2AMLogic/gf180-ldo/sim/README.md

# sim/ — evidence record format

This directory holds simulation testbenches and their results. Results are
**append-only evidence**: once a record is written, it is never edited or
deleted. A re-run — even one that corrects a mistake — mints a new record
with a new ID; a correction references the record it supersedes rather than
overwriting it in place.

This convention exists because CLAUDE.md commits this repo to two rules that
need a concrete schema to be enforceable:

- **Verification is the product.** No claim without a testbench. Every
  recorded result carries the full PVT corner matrix (−40/27/125 °C, ±10%
  supply, process corners) unless the record explicitly states why a subset
  was used.
- **`sim/` is append-only evidence.** Re-runs get new records; records are
  never edited or deleted.

## Provenance note (checked at build time, 2026-07-30)

This convention mirrors the ratified `sim/README.md` on `2AMLogic/gf180-bandgap`
`main` (landed via their PR #22, merged 2026-07-30). At the time this doc was
written, bandgap's harness PR (#23, "Stand up the ngspice + gf180mcu PVT
simulation harness") was still **open and unmerged**, and it writes evidence
as a machine-readable JSON/CSV pair under `sim/results/<tb>/` rather than the
Markdown records described below — i.e. it is a *competing* scheme that has
not yet been reconciled with the ratified Markdown convention. Since the
Markdown convention is what is currently ratified on bandgap `main`, this
repo adopts it as-is (see "LDO-specific extensions" below for the one place
this repo diverges, with rationale). If bandgap later reconciles #23 against
this convention (or supersedes it via a decision record), re-check this doc
against bandgap `main` and update accordingly — do not let the two repos'
evidence formats silently drift apart, since cross-block tooling and review
uniformity is the whole point of matching.

## Directory / naming convention

Each testbench topic gets its own experiment directory:

```
sim/
  <experiment-slug>/                 # e.g. dropout-vs-load, psrr-dc, startup, mc-untrimmed
    testbench/                       # testbench netlist(s) / xschem export used
    netlist-snapshots/
      <record-id>.spice              # frozen DUT netlist used for this record
    corners/
      <record-id>/
        <corner-id>.log              # raw ngspice output per PVT point
                                      # e.g. ss_-40c_2.97v.log
    records/
      <record-id>.md                 # append-only summary record
```

- **`<experiment-slug>`** — short, descriptive, kebab-case name for what is
  being verified (`dropout-vs-load`, `psrr-dc`, `startup`, `mc-untrimmed`,
  ...). One directory per distinct claim being tested, not per run.
- **`<record-id>`** — unique and traceable:
  `<YYYYMMDD>-<HHMMSS>-<short-git-sha>` (e.g. `20260729-153000-1a7ef75`).
  Re-runs simply mint a new `<record-id>`; nothing under `records/` is ever
  edited in place. The same `<record-id>` ties together the netlist snapshot,
  the raw per-corner logs, and the summary record for one run.
- **`<corner-id>`** — `<process-corner>_<temp>c_<supply>v.log`, e.g.
  `ss_-40c_2.97v.log`, `tt_27c_3.3v.log`, `ff_125c_3.63v.log`. For claims that
  are also load-conditioned (see "Operating conditions" below), the load
  point may be appended, e.g. `ss_-40c_2.97v_50ma.log`, when a single record
  sweeps more than one load current within the same corner matrix.
- **`testbench/`** is not versioned per record — it holds the current
  testbench netlist(s)/xschem export(s) used to generate records. If the
  testbench itself changes in a way that could affect comparability across
  records, note that in the new record's summary (e.g. under Claim or a
  free-text note).

### Raw corner logs are committed, not ignored

> **Superseded for new runs (issue #511, DR-0041).** The rest of this section
> describes how every record up to now was written, and those files stay
> exactly where they are. A run minted after DR-0041 stores its logs and
> netlist snapshot in the artifact store instead and commits only a manifest
> and the Markdown record; see "Stored evidence" below.

The repo root `.gitignore` ignores `*.log` (scratch output), so it carries an
explicit negation to re-include evidence logs:

```gitignore
!sim/*/corners/**/*.log
```

Raw per-corner ngspice output under `sim/<slug>/corners/<record-id>/` is
**evidence**, not scratch — a record's Links field points at those files, so
they must be committed alongside the record they substantiate. The negation
generalizes to any new experiment slug; no parent directory is excluded, so
git's "cannot re-include a file under an excluded directory" rule does not
apply. Anything else matching `*.log` (simulator scratch, tool noise) stays
ignored. Verify with `git check-ignore -v <path>` if a log unexpectedly fails
to stage.

**Binary `.raw` waveform dumps are scratch, not evidence — deliberately.**
The root `.gitignore` ignores `*.raw` with no negation, and that is
intentional, not an oversight: a full ngspice `.raw` rawfile (from `write
out.raw` or a `wrdata`/binary dump in a `.control` block) is large, opaque,
and not diffable, and a 9-point PVT matrix of them adds up fast. Anything a
record's **Result** cites — a measured value, a pass/fail, a spec-point
extraction from a curve — must be reproducible from the committed `.log`
alone, via `.meas` statements or `print`/`echo` output to stdout, which
ngspice captures into the corner log. A testbench deck MAY still write a
`.raw` file locally for interactive debugging, but must not rely on it as
the record of a claim: nothing under `sim/` is evidence unless it is
committed, and `.raw` files are never committed. If a harness needs to
preserve full waveform data rather than a scalar/point extraction, that is
a signal the record format needs a new evidence kind (open an issue rather
than silently committing a `.raw`) — this convention does not currently
have one.

## Summary record format

Each run produces one `records/<record-id>.md` file with the following
fields:

- **Record ID** — the `<record-id>` for this run (matches the filename and
  the corresponding `netlist-snapshots/` / `corners/` subdirectory).
- **Claim** — which spec parameter/line this record substantiates (reference
  the ratified spec, e.g. `spec/<file>.md#<anchor>`, once ratified specs
  exist — see #1). Placeholder anchors are acceptable until #1 ratifies.
- **Netlist provenance** — `schematic` (`design/...`) or `extracted`
  (post-layout, `layout/...`). Required so post-layout re-runs are
  distinguishable from the original schematic-level record.
- **Corner matrix run** — explicit list of (process corner, temperature,
  supply) points actually executed. Must be the full PVT matrix from
  CLAUDE.md (−40/27/125 °C, ±10% supply, process corners) unless the record
  states why a subset was used.
- **Operating conditions** *(LDO-specific — see below)* — load current or
  load profile, output capacitor value + ESR range, and enable state.
  Required whenever the claim depends on load or the output network, i.e.
  most LDO spec lines (dropout, load/line regulation, stability, transients,
  startup). Omit only for claims that are provably load-independent (e.g. a
  pure reference-voltage TC check with the output disconnected), and say so.
- **Statistical convention** (when applicable, e.g. Monte Carlo mismatch
  analysis) — N samples and sigma level reported. Used for distribution
  claims that are not a per-corner pass/fail (e.g. reporting a spread against
  the untrimmed spec).
- **Result** — per-corner pass/fail, plus an overall pass/fail against the
  ratified spec value. For curve-shaped claims (e.g. PSRR vs frequency,
  transient step response) that are checked against a single spec point
  within a sweep (e.g. "PSRR > 50 dB @ 1 kHz"), the Result states the value
  extracted at that spec point plus pass/fail against it; the full curve/
  waveform data lives in the raw log under `corners/`, referenced from
  Links. A record MAY report more than one spec point extracted from the
  same sweep (e.g. PSRR at 1 kHz and 100 kHz) as separate line items under
  Result, each with its own pass/fail — the sweep is run once, but every
  claim it substantiates gets an explicit, unambiguous verdict. Records
  minted by `sim/run_corners.py` additionally carry a **`dc path`** column
  and a **DC solve path** census inside Result — see "A verdict can move
  without the circuit moving" below. It is attribution, never a verdict: no
  rung value has ever made a record pass or fail.
- **Links** — paths to the testbench file(s), the frozen netlist snapshot,
  and the raw per-corner logs used to produce this record.
- **Timestamp / author** — when the record was created and who (human or
  agent) created it.
- **Supersedes** (optional) — the prior `<record-id>` this record supersedes,
  for corrections or for a post-layout extracted re-run that reports a
  schematic-vs-extracted delta against the schematic-level record. Mirrors
  the status/supersession language proposed for `spec/` decision records
  (see #6), so both conventions read as one house style.

## LDO-specific extensions (where "match bandgap" ends)

Bandgap's corner matrix is process/temperature/supply only — a bandgap
reference has no load pin. An LDO's spec lines are additionally load- and
output-network-conditioned (dropout @ 50 mA; load regulation 1–50 mA; line
regulation; stability across 0–50 mA load with a 1 µF ± ESR output cap
range; startup into full load, minimum load, and current limit; PSRR and
transient response, both load-dependent). A PVT corner alone does not fully
specify one of these claims — the **Operating conditions** field above
closes that gap so a claim like "dropout < 300 mV @ 50 mA at ss/125 °C/
2.97 V" is fully specified by the record: process/temp/supply come from
Corner matrix run, load/cap/enable come from Operating conditions. This is
the one deliberate divergence from the bandgap convention; the field is
additive (records with no load dependency simply state N/A), so it does not
break parity for claims that don't need it.

## Append-only rule

`records/*.md` files are never edited or deleted after creation. A re-run or
a correction always creates a new record with a new `<record-id>`. If it
corrects or replaces a prior result, it references that prior record via
**Supersedes** rather than overwriting it. This applies even to typo fixes —
the append-only guarantee is what makes `sim/` usable as an evidence trail;
"fixing" an existing record in place would defeat that.

The rule has **no exceptions and needs none**: everything under a real
experiment slug is real evidence. That is why the worked example below is
inline in this document only and is deliberately *not* materialized as files
under `sim/dropout-vs-load/` (or any other slug). A placeholder record
committed to a real slug would be an evidence-shaped file that is not
evidence — it would have to be either deleted later (breaking this rule the
moment it is written) or left permanently interleaved with genuine records,
where any rollup that globs `sim/*/records/*.md` would ingest its fabricated
verdict. Illustrate the format in prose; only real runs write files.

**Enforcement.** The writer refuses to overwrite in-process, and CI enforces
the rule on every pull request: `sim/check_append_only.py` diffs
`origin/<base>...HEAD` and fails if any path under `sim/*/records/`,
`sim/*/corners/`, `sim/*/netlist-snapshots/` (the frozen DUT netlists that a
record's fresh/stale attribution depends on), `layout/records/`, or
`manifests/artifacts/*.manifest.json` is modified, deleted, or renamed (only
additions pass). The "no exceptions" stance stands; if a decision record ever
ratifies one, it must be listed with its DR number in
`sim/append-only-allowlist.txt` so it stays visible in review (empty today).

**Growth report.** Because `sim/` can only grow, CI also runs
`sim/report_evidence_growth.py` on every pull request. It writes files and
bytes added per `sim/<slug>` to the job summary. It is reporting only: it
never fails and enforces no ceiling.

## Stored evidence

New evidence bytes go to the fleet artifact store; git keeps a manifest and a
Markdown record (issue #511, [DR-0041](../spec/decision-records/DR-0041-new-evidence-bytes-go-to-the-artifact-store-git-keeps-manifests.md)).
Evidence bytes are private and manifests are public, so a manifest is safe in
this public repo. Evidence already committed is not rewritten or migrated.

- **Corner-runner records.** `python3 sim/run_corners.py <bench>` stages the
  netlist snapshot and per-corner logs under `sim/.work/.stage/` (git-ignored),
  stores them with `klt artifact put`, then commits
  `manifests/artifacts/<bench>-<record-id>.manifest.json` and
  `sim/<bench>/records/<record-id>.md`. The record ends with a "Stored
  evidence" table (name, size, sha256 per object). Zero-byte files cannot be
  stored and are listed there as empty. The record's `netlist-snapshots/` and
  `corners/` paths are the manifest `name`s, not files in the repo.
- **Other outputs.** Write them to scratch (`sim/.work/...` or outside the
  repo), then
  `python3 sim/run_store_evidence.py <bench> <run-id> <dir> --summary <summary.md>`.
  It commits the manifest and `sim/<bench>/campaigns/<run-id>.md`.
  The `klt`-batch adapters (`klt_record.py`, `tb_adapter.py`) still write the
  old layout; moving them is tracked separately.
- **Configuration** is the environment only, read by `klt`:
  `KLT_ARTIFACT_BROKER` and optionally `KLT_ARTIFACT_REPO`. Nothing is
  defaulted and no broker URL, bucket or account identifier is written in this
  repo. A manifest `uri` is the logical `artifact:<key>`; any other scheme is
  refused. `klt` must be klayout-tools `7e3561f` or later. `klt` reports no
  commit, so the writer probes its behaviour offline. To try another version
  use a throwaway environment (`uvx --from ... klt`), not a host install.
- **Fail closed.** If the broker is unset or unreachable, or `klt` lacks
  `artifact put` or is too old, `run_corners.py` refuses before simulating
  (exit 10). A put that fails after the grid also exits 10. Either way nothing
  goes under `manifests/` or `sim/`, the staged bytes stay in
  `sim/.work/.stage/`, and there is no option to commit the bytes instead.
  `--no-write` exploration needs no store.
- **Verify by hash.** `klt artifact verify <manifest>` (or
  `python3 scripts/check_artifact_manifests.py verify <manifest>`) re-hashes
  every entry through the broker. CI runs
  `scripts/check_artifact_manifests.py check --tree <sha>`: schema, `artifact:`
  URIs only, and no stored object's bytes also committed. CI never contacts the
  broker, so it does not hash-verify and says so.

## Reproducibility caveat: a version string is not a content fingerprint (#182)

The Environment section documents "everything needed to re-run this record",
and lists the resolved `ngspice` **self-reported version string** (e.g.
`ngspice-46`). Issue #182 found that string insufficient on its own: this
repo's evidence is produced across a fleet of independently-provisioned
builder hosts (see Loom's own per-host lease records), each with its own
locally-installed toolchain, and even **on a single host over time** two
differently-built binaries were found coexisting that both print the
identical `"ngspice-46 ... Compiled with KLU Direct Linear Solver"` banner
while differing byte-for-byte. At a numerically marginal operating point
(within a couple of degrees of DR-0001's 45° phase-margin bar), that
difference in binary content was directly observed to move the measured
phase margin by ~2° and gain margin by ~1 dB on an otherwise byte-identical,
unmodified netlist and PDK — see
`sim/loop-stability/records/20260906-090647-3981d88.md` for the full
investigation and ruling-out evidence.

**Consequence for this convention**: "reproducible" for a `sim/` record does
**not** mean "any host/session reporting the same `ngspice` version string
will reproduce this record's numbers to the last digit" — it means
"reproducible given a matching resolved binary and PDK content, which the
record's Environment section must make checkable." Every record's
Environment section now also carries (or should carry, for records minted by
harness code that predates #182):

- **ngspice binary sha256** — a content fingerprint of the resolved
  executable (`sim.harness.runner.ngspice_binary_sha256()`), not just its
  self-reported version string.
- **Host** — the hostname that produced the record (`socket.gethostname()`),
  since Loom's builder fleet spans multiple independently-provisioned
  machines.

When comparing two records for a claimed regression or an unexplained
per-point delta near a spec bar, **check whether `ngspice binary sha256` and
`Host` match before treating the delta as evidence about the design**. A
mismatch on either field means the two records were not produced by the same
toolchain, and a delta between them is toolchain provenance, not a design
regression — file it as a toolchain-reproducibility question (as #182 did),
not as a spec-line failure. This does **not** relax DR-0001 or any other
ratified spec bar: a record's own PASS/FAIL verdict against its stated bar
stands as recorded regardless of this caveat; the caveat only qualifies
what a *comparison across two records* is allowed to conclude.

Recording the fingerprint makes drift *detectable after the fact*; it does
not stop it. Issue #184 hardens `sim/run_corners.py --check-env` to enforce
toolchain identity *before* a run, rather than only reporting the
fingerprint for later comparison — see
[`docs/environment-setup.md`](../docs/environment-setup.md)'s "A version
banner is not a toolchain identity" section.

Issue #247 then found that check could invert once Homebrew's unversioned
`ngspice` formula moved past the pinned 46_1 — it began blaming the
correctly-pinned binary and naming an unvalidated ngspice-47 keg as the
"correct" root. It now checks the *version* pin as well as containment, and
prefers a non-drifting root. The **four distinct ngspice-46 builds already
present across the committed records** are documented there as an accepted,
historical split (census, and what a cross-fingerprint comparison may and may
not conclude): `docs/environment-setup.md` → "The ngspice-46 builds already
in `sim/*/records/` are an accepted, historical split". Per the append-only
rule above, none of those records are regenerated to reconcile it.

## A verdict can move without the circuit moving: the DC solve path (#301)

The caveat above is about the toolchain *binary* changing underneath a
record. There is a second, closely-related way two records can disagree with
no electrical change between them, and it happens on one fixed binary: the
**DC continuation ladder**.

ngspice does not solve a DC operating point with one algorithm. It tries the
first-guess Newton solve, and on non-convergence descends a ladder of
continuation methods, taking the first one that converges:

| rung | what ngspice prints when this rung solved the point |
|---|---|
| `direct` | *(nothing — the first Newton pass converged)* |
| `dynamic-gmin` | `Dynamic gmin stepping completed` |
| `true-gmin` | `True gmin stepping completed` |
| `source-stepping` | `Source stepping completed` |
| `pseudo-transient` | `Transient op finished successfully` |

Which rung a corner lands on is a property of the numerical path, not of the
circuit. Issue #301 measured a 2×2 on `sim/quiescent-current` — two DUT
netlists × a seeded/unseeded deck, one host, one ngspice binary, one PDK —
in which the bench's overall verdict flipped between two builds whose
`iq_en_ua` agrees to six significant figures at every corner. DR-0033 (a
poly-resistor *flavour* swap, electrically neutral on this bench) had moved
which rung the one marginal corner caught on, and nothing in the recorded
evidence said so.

So every `sim/run_corners.py` record now reports, per corner, the deepest
rung that corner's DC solve(s) reached, plus a grid-level census. Read it
the same way as `ngspice binary sha256` and `Host`:

- **A census difference between two records is a real difference**, even
  when every printed measurement matches — those corners' solutions came
  from different algorithms.
- **A deep rung is not a failure.** ngspice descends the ladder on its own,
  and the answer it returns is still checked by the same `tb.json` checks as
  any other corner. The rung marks *marginality*, so a corner sitting on
  `source-stepping` today is the one to expect to move tomorrow.
- **Do not tune a deck against a rung.** A `.nodeset` DC seed chosen to move
  one corner up the ladder is validated against a numerical path, not
  physics; issue #301's own 2×2 is the counter-example (the seed that fixed
  the marginal corner on one DUT created a new failure at a *different*
  corner on the next one). Any future seed must re-run that A/B on the DUT
  current at the time.
- **The last rung is fatal, not marginal (#310).** Everything above applies
  to the first four rungs. A log showing the ladder fell *through*
  `source-stepping` — `Warning: source stepping failed` followed by
  `Note: Transient op started` / `Note: Transient op finished successfully` —
  means ngspice reported a snapshot of an unsettled synthetic transient as
  the operating point: it exits 0 and prints every requested measurement,
  but the values are not a DC solution. Committed evidence:
  `sim/quiescent-current/corners/20260915-234352-077e15b/ss_-40c_2.97v.log`
  reports `iq_en_ua = -137.99` — a *negative* no-load supply current, i.e.
  capacitor displacement current, which no DC operating point has — and the
  corner's bench checks only caught it by luck (see #310's "Why it
  matters"). The harness therefore fails such a corner outright, gated to
  DC-solve benches (`op`, `dc`, `ac`): a bench that declares a `.tran`
  analysis is exempt, because its initial-time-point solve walks the same
  ladder and a pseudo-transient initial condition does not invalidate the
  transient that follows. This applies on every code path that drives
  ngspice in this repo: `run_point()` and `run_ngspice_deck()` (#310), and
  the standalone bash driver `sim/harness/lib/run_point.sh`'s
  `harness_run_point()` plus `sim/devchar/lib/devchar.sh`'s `dc_run()`
  (#317) — the latter two shell out to the same
  `_ladder_exhaustion_lines()` / `_runs_transient_analysis()` rather than
  keeping their own copy, so all four call sites cannot drift apart.

Implementation: `sim.harness.runner.classify_dc_path()` classifies one
corner's combined ngspice stdout+stderr; `sim.harness.report.dc_path_census()`
rolls the grid up. Both are pure log parsing — they change no deck, assert
nothing, and run on every bench that goes through `run_point()`. Sweep
testbenches with their own driver (`sim/loop-stability`,
`sim/soft-start-loop-gain`) can opt in by calling `classify_dc_path()` on
what `run_ngspice_deck()` already returns; none does yet. `dc_path` census
reporting is `run_point()`/`run_ngspice_deck()`-specific (#301) and is not
part of what the bash driver's ladder-exhaustion *gate* needed to port —
`sim/harness/lib/run_point.sh` and `sim/devchar/lib/devchar.sh` fail a
corner outright the same way, they just do not also classify/census the
rung for corners that pass.

## Records measured under open_pdks `c6d73a3` are superseded as PDK evidence (#428 / #430)

`sim/harness/pdk.py` pins `PINNED_OPEN_PDKS_REVISION =
f6eeac7dad085ffcc829ccfd721f7b4ce39edcf7`. Every record minted before that
re-pin was measured at the previous pin, open_pdks
`c6d73a35f524070e85faff4a6a9eef49553ebc2b` (local `~/.ciel` trees, and the
batch fleet's `/opt/pdk`). Those records are **not edited**; the convention
below is how a reader tells which revision a record speaks for.

- **A record that states no `f6eeac7…` revision speaks for `c6d73a3…`.**
  Records minted by `klt sim` carry the worker's PDK stamp in their klt
  report (`environment.remote.worker_environment.pdk.stamp_text`).
- **A re-qualified bench gets a new record** whose `Supersedes` field names the
  prior head record(s) and whose PDK-revision field states `f6eeac7…`, with a
  same-DUT old-vs-new comparison when a same-DUT baseline exists. The older
  record stays valid evidence for `c6d73a3…` and is superseded only as
  evidence for the pinned revision. `sim/CHARACTERIZATION.md` picks the new
  record up automatically (newest record whose snapshot matches the current
  DUT).
- **The fleet's PDK can lag the repo's pin.** The batch fleet's worker image
  carries its own `/opt/pdk`; a request that does not say otherwise is
  simulated against that tree. `sim/harness/klt_batch.py` therefore submits
  `options.stage_model_inputs: true`, which ships the submitting host's model
  files (its `~/.ciel` tree, checked against the pin by
  `sim/run_corners.py --check-env`) with the job. Confirm per run: the klt
  report's `worker_environment.models_staged` is `true` and its `model_inputs`
  list the staged files. The report's `pdk.stamp_text` keeps naming the
  worker's own tree and is not what the job used.

Re-qualification status (issue #430). "Moved" means a measurement or a
pass/fail verdict differs from the same-DUT record at `c6d73a3…`:

| bench | new record | same-DUT old record | moved? |
|---|---|---|---|
| `quiescent-current` | `20261020-pdk-f6eeac7-iq` | `20261015-iq-320-pvt` | no (81/81 points identical) |
| `current-limit` | `20261020-pdk-f6eeac7-ilim` | `20261015-ilim-320-pvt` | no (63/63 points identical) |
| `enable-shutdown` | `20261020-pdk-f6eeac7-en` | none (older DUT only) | not separable; all checks pass |

The `tb.json` benches are re-qualified in the section below (#464, #467, #468). The
remaining benches (`loop-stability`, `soft-start`) are not yet re-qualified and
still speak for `c6d73a3…` only; they are tracked in #465.

## Re-qualification at the pinned open_pdks through `klt sim` (#464, #467, #468)

`sim/harness/pdk.py` pins open_pdks `f6eeac7`. The batch fleet's image carries
a different revision (`c6d73a3` when #467 checked: `worker_environment.pdk.stamp_text`
in a `klt sim` report), and an off-host `klt sim` executes the image's models
unless the request sets `options.stage_model_inputs`. A record that claims the
pin must therefore be run with the models staged and show
`worker_environment.pdk.models_staged: true`; the harness adapter below sets it.

A bench that declares itself in `tb.json` goes to the fleet through
`sim/harness/tb_adapter.py`, which turns `tb.json` (grid, `analyses`, `measure`,
`checks`) into a `klt_batch.Job`; the bench's `testbench/klt_run.py` is a few
lines over it and the measurements and bounds stay in `tb.json`. It maps a
`meas` analysis line to a `.meas` card, a `measure` entry built from card
results to a `.meas … param=` card (a card's result is a printed scalar, not a
vector a later `let` can read), and any other `measure` entry to an `expr`,
with `m_<name>` references and the bench's own `<kind>1.` plot qualifiers
rewritten. A single-request bench that reads a plot its analysis does not
produce is refused by name rather than approximated.

A bench that chains analyses in one `.control` block (`op`, `ac dec …`,
`ac lin 1 1k 1k`) cannot be one request, because `klt sim` runs one analysis per
corner. `tb_adapter.states()` splits it into one request per analysis and sends
each `measure` entry to the analysis whose plot it reads (`ac1.x` and `meas ac`
results to `ac1`; an unqualified vector read to the last analysis, ngspice's
current plot); an entry that reads two analyses is refused. These fragments take
their supply from `.param vdd_val`, and the fleet's worker answers a swept
`corners.params` axis with `params_unsupported_worker`, so each supply point is
its own request with `vdd_val` written into the body: a 3-supply bench is
`states x 3` requests, and the driver merges the values per corner. `klt_run.py`
leaves `summary.csv` and the per-request reports and logs under
`corners/<record-id>/klt-<state>-<vin>v/`; `PYTHONPATH=sim python3 -m
harness.klt_record <slug> --record-id <id>` turns them into the record and
netlist snapshot, graded with `report.evaluate_checks`, and writes the
old-vs-new table against the newest earlier record (a *Reading* is written by
hand).

| bench | driver | latest record at `f6eeac7` (batch) | verdict |
|---|---|---|---|
| `dropout-vs-load` | `testbench/klt_run.py` | `20261021-031411-06b3540` | PASS, 27/27 (#472) |
| `line-regulation` | `testbench/klt_run.py` | `20261021-032652-06b3540` | FAIL, 26/27 (`ff_125c_3.30v`, DR-0039, #302) |
| `load-regulation` | `testbench/klt_run.py` | `20261021-031815-06b3540` | PASS, 81/81 (#472) |
| `amp-openloop` | `testbench/klt_run.py` | `20261021-023703-7d3b2a0` | PASS, 81/81 |
| `psrr-dc` | `testbench/klt_run.py` | `20261021-023703-7d3b2a0` | PASS, 81/81 |
| `psrr-vs-freq` | `testbench/klt_run.py` | `20261021-023703-7d3b2a0` | FAIL, 42/45 (DR-0031, #302) |
| `psrr-vs-freq-50ma` | `testbench/klt_run.py` | `20261021-034534-0165a0b` | FAIL, 42/45 (DR-0031, #302; `ss_-40c_2.97v` physical since the supply-gated sink, #478) |
| `load-transient` | `testbench/klt_run.py` | `20261021-pdk-f6eeac7-tran` | FAIL, 73/81 (peak excursion; the DR-0037 DUT, not the pin, #483) |
| `startup` | `testbench/klt_run.py` | `20261021-pdk-f6eeac7-startup` | PASS, 81/81 (41 points carry a `Dynamic gmin stepping failed` warning) |
| `mc-output-accuracy` | `testbench/klt_run.py` | `20261021-pdk-f6eeac7-mc` | FAIL, 0/45 (`divider_exact_uv`; the DR-0037 DUT, not the pin, #484) |

For these three, running the same request on the image's `c6d73a3` and on the
staged `f6eeac7` gave a byte-identical `summary.csv`: the PDK revision alone
moved no number. The first re-qualification's failures reproduced in a
single-corner local run; #472 traced them to the sweep path landing on a second
DC root (pass device off) and changed the three sweeps (dropout Vin rising;
load current in 7 mA steps, Vsup outer in `line-regulation`) without moving a
bound. The remaining `line-regulation` failure is `ff_125c_3.30v`, DR-0039.

`amp-openloop` and `psrr-dc` measure `error_amp.spice`, which has not changed
since their previous records, so those two are same-DUT comparisons: the DC,
gain and headroom measurements agree with the earlier local records to within
their 6-digit rounding and the AC-crossing ones (`ugbw_khz`, `pm_deg`,
`peak_excess_db`) move by at most 0.7 %, with no verdict change. A single-corner
local run of the same request against the c6d73a3 and f6eeac7 trees returned
identical values, so that residual is not the PDK revision. The two PSRR benches
measure `ldo_core.spice`, which has moved since their previous records, so there
is no same-DUT record to compare against.

## Interim evidence note (for #4, device characterization)

#4 (characterizing gf180mcu devices for the LDO — pass FETs, resistors,
caps) is in flight and may land CSV tables with a per-directory README
(`sim/devchar/<category>/`) before or concurrent with this format landing,
per its own stated fallback ("use plain CSV tables plus a README per
directory... note in the PR that the format should be migrated once #5
ratifies"). That output is **table-shaped evidence**, not a single-claim
pass/fail record, and it does not need to be force-fit into one
`records/<record-id>.md` file per row. The relationship to this convention:

- A CSV table of measured device parameters across a corner sweep (e.g. an
  Rds(on)-vs-width table across all process/temp/supply points) is itself a
  form of raw/summarized output and belongs alongside a `corners/`-style
  directory, not in place of it — the underlying per-corner ngspice logs
  (or an equivalent single run producing the whole table) are the
  `corners/` content, and the CSV is a derived rollup.
- Where a characterization table's row is used later to *substantiate a
  spec claim* (e.g. "this pass-FET width meets the < 300 mV dropout spec"),
  that claim gets its own `records/<record-id>.md` under the relevant
  experiment slug (e.g. `sim/pass-fet-sizing/records/...`), with **Links**
  pointing back at the `sim/devchar/...` table and deck that produced the
  underlying data. The record does not have to re-run the sweep — it can
  cite the existing devchar evidence directly.
- Migration is **not required retroactively**: existing devchar CSVs/READMEs
  landed under the documented interim fallback are not invalidated by this
  format landing. New characterization work, and any record that makes a
  spec-line pass/fail claim from characterization data, should follow this
  convention going forward.

## Worked example

**Illustrative only** — nothing in this section exists on disk, and the paths,
record IDs, and values below remain invented to show the shape of a complete
record without duplicating a real one here. This matches the sister repo
(`2AMLogic/gf180-bandgap`), whose `sim/` likewise carries its worked example
in the README rather than as a committed placeholder tree.

Issue #12 has since landed the real `sim/dropout-vs-load/` (and six sibling
experiment directories, one per ratified spec line) — see
`sim/dropout-vs-load/records/` for an actual record in this exact shape, and
`sim/harness/README.md`'s "Writing a testbench" section for the `dut_netlist`
manifest field #12 added — which designates, among the design netlists #35's
`includes` brings into the deck, the one that is the DUT — so a testbench can
instantiate a real DUT (the LDO core) through this harness rather than only
PDK primitives.

Directory layout for a dropout-vs-load claim on the LDO output, followed by
a post-layout extracted re-run of the same claim:

```
sim/
  dropout-vs-load/
    testbench/
      tb_dropout_vs_load.spice
    netlist-snapshots/
      20260730-120000-4e9c1a2.spice
      20260815-093000-9b3d7f1.spice
    corners/
      20260730-120000-4e9c1a2/
        tt_27c_3.30v_50ma.log
        ss_-40c_2.97v_50ma.log
        ff_125c_3.63v_50ma.log
        ...
      20260815-093000-9b3d7f1/
        tt_27c_3.30v_50ma.log
        ss_-40c_2.97v_50ma.log
        ff_125c_3.63v_50ma.log
        ...
    records/
      20260730-120000-4e9c1a2.md
      20260815-093000-9b3d7f1.md
```

What `records/20260730-120000-4e9c1a2.md` would contain (invented values — no
simulation has been run and no ratified spec values exist yet, see #1):

```markdown
# Record 20260730-120000-4e9c1a2

- **Record ID**: 20260730-120000-4e9c1a2
- **Claim**: `spec/ldo.md#dropout-voltage` — dropout voltage at full load
  current, TBD mV target (placeholder; ratified spec pending #1)
- **Netlist provenance**: schematic (`design/ldo.sch`)
- **Corner matrix run**:
  - Process: tt, ss, ff
  - Temperature: −40 °C, 27 °C, 125 °C
  - Supply: 2.97 V, 3.30 V, 3.63 V (±10% of 3.3 V)
  - (9 corner points total — full process x temp matrix at nominal supply,
    plus supply sweep at tt/27C; see testbench for exact point list)
- **Operating conditions**:
  - Load current: 50 mA (full-load dropout point; stretch target 100 mA not
    yet swept)
  - Output cap: 1.0 µF, ESR = 100 mΩ (nominal; ESR range 10 mΩ–1 Ω not yet
    swept for this claim — see stability experiment for ESR sensitivity)
  - Enable state: enabled (EN = VIN), steady-state (not a startup transient)
- **Statistical convention**: N/A (corner-matrix claim, not a distribution
  claim)
- **Result**:
  - tt/27C/3.30V: PASS (placeholder value)
  - ss/-40C/2.97V: PASS (placeholder value)
  - ff/125C/3.63V: PASS (placeholder value)
  - ... (remaining corners: PASS, placeholder values)
  - **Overall: PASS** (placeholder — pending ratified spec, #1)
- **Links**:
  - Testbench: `sim/dropout-vs-load/testbench/tb_dropout_vs_load.spice`
  - Netlist snapshot: `sim/dropout-vs-load/netlist-snapshots/20260730-120000-4e9c1a2.spice`
  - Raw logs: `sim/dropout-vs-load/corners/20260730-120000-4e9c1a2/`
- **Timestamp / author**: 2026-07-30T12:00:00Z, agent-builder
- **Supersedes**: (none — first record for this claim)
```

A later post-layout extracted re-run of the same claim would live under the
same `dropout-vs-load/` experiment directory with its own `<record-id>`,
`Netlist provenance: extracted (layout/ldo.gds -> extracted netlist)`, the
same **Operating conditions** fields (load/cap/enable are a test-setup
property, not a netlist-provenance property, so they carry over unless the
re-run deliberately changes them), and a `Supersedes: 20260730-120000-4e9c1a2`
field carrying a schematic-vs-extracted delta summary in its Result section.

A Monte Carlo mismatch check (e.g. of output-accuracy spread under the
feedback divider's device mismatch) would follow the same shape as bandgap's
worked example: a distinct experiment slug, `Corner matrix run` narrowed to
the nominal or worst corner with a note explaining the narrowing, and a
populated `Statistical convention` field (e.g. "N = 500 Monte Carlo samples,
distribution reported at ±3σ").
