2AMLogic/gf180-ldo/spec/decision-records/README.md

# Decision records: status index

<!-- GENERATED by spec/decision-records/build_index.py -- do not edit. -->
<!-- Regenerate: python3 spec/decision-records/build_index.py > spec/decision-records/README.md -->

Only **ratified** records are in force. Everything else is a proposal or a held/negative-result write-up awaiting the operator. Status is read from each record's `Status` line (see `TEMPLATE.md`); CI fails if this file is stale or a record's status cannot be classified.

41 records: 12 ratified, 28 proposed, 1 held, 0 superseded.

| DR | Title | Status | Superseded by |
|---|---|---|---|
| [DR-0001](DR-0001-output-cap-strategy.md) | Output capacitor and ESR window | ratified | - |
| [DR-0002](DR-0002-input-flavor.md) | Input voltage flavor — 3.3 V now, 5 V deferred | ratified | - |
| [DR-0003](DR-0003-output-programmability.md) | Output programmability — fixed 1.8 V, mask-option taps only | ratified | - |
| [DR-0004](DR-0004-spec-ratification.md) | Ratification of the target specification, with amendments A1–A12 | ratified | - |
| [DR-0005](DR-0005-current-limit-window.md) | the untrimmed current-limit window cannot be ±10 % on this PDK | ratified | - |
| [DR-0006](DR-0006-startup-settling-window.md) | the Startup row's 3 ms settling window cannot coexist with its 1 V/ms ramp bound on an untrimmed on-chip ramp | ratified | - |
| [DR-0007](DR-0007-light-load-stability-envelope.md) | The 0 mA / no-external-load point of DR-0001's stability matrix | held | - |
| [DR-0008](DR-0008-loop-gain-rhp-pole-precondition.md) | DR-0001's phase/gain margin is only a stability test when the loop gain has no right-half-plane poles | ratified | - |
| [DR-0009](DR-0009-shelf-corner-vs-crossover-frontier.md) | With the amplifier no longer oscillating, the gain-shelf compensation reaches ~0.1 mA, not 50 mA | proposed | - |
| [DR-0010](DR-0010-buffer-sense-device-negative-result.md) | A direct super-source-follower sense device around `Mbuf` plateaus below the PM bar and spends PSRR margin | proposed | - |
| [DR-0011](DR-0011-isolated-sense-bias-negative-result.md) | An isolated-bias-reference super-source-follower still fails — it collapses margin instead of merely plateauing | proposed | - |
| [DR-0012](DR-0012-shelf-width-is-cc-over-cf.md) | The gain shelf's width is `Cc/Cf`, not an Iq budget — and that closes the 0.1 mA column | proposed | - |
| [DR-0013](DR-0013-adaptive-shelf-position.md) | The shelf does not need to be wider, it needs to move — and moving it hits the same `p2` ceiling. Candidate 2, measured and rejected at the committed operating point | proposed | - |
| [DR-0014](DR-0014-compensation-return-node.md) | `f_2`'s ceiling is the compensation network's return node, not an Iq budget — and adaptive *bias* cannot be the lever | proposed | - |
| [DR-0015](DR-0015-adaptive-shelf-from-the-pass-gate.md) | The gain shelf can be made to track the load — a triode replica across `Rz`, gated by the pass device's own drive | proposed | - |
| [DR-0016](DR-0016-compensation-pareto-front.md) | The compensation Pareto front for wide cap × load range — a spec-and-lever trade study, not a new circuit | proposed | - |
| [DR-0017](DR-0017-return-node-move-does-not-net-improve-with-adaptive-rz-already-shipped.md) | With `Mrza`/`Rza` already shipped, `Cc` -> `BG` plus a `Cf` step is a wash, not a win -- and the `Cf` floor is numerically prohibitive to reach | proposed | - |
| [DR-0018](DR-0018-narrow-stability-envelope-to-1uf-nominal.md) | With compensation-network tuning exhausted, propose closing issue #51's residual gap by spec decision (DR-0016's Candidates 1 and 3), not a further circuit change | ratified | - |
| [DR-0019](DR-0019-buffer-standing-current-blocked-by-amp-iq-allocation.md) | Buying `f_hi` via `Mbuf`/`Mbufb` standing current is blocked by the amplifier's own (already-exhausted) `iq_ua` allocation, and too low-leverage to reach the target even without it | proposed | - |
| [DR-0020](DR-0020-dropout-measurement-definition.md) | dropout is the headroom at the regulation knee, not `Vin − Vout` at a pinned `Vin = 2.10 V` | proposed | - |
| [DR-0021](DR-0021-vref-is-a-top-level-port.md) | `VREF` becomes a top-level `ldo_core` port; this repo does not design its own bandgap | proposed | - |
| [DR-0022](DR-0022-startup-clearance-narrows-above-1uf.md) | the Startup row's current-limit-clearance clause is a bound only up to C_eff = 1 µF, not to DR-0001's 4.7 µF ceiling | proposed | - |
| [DR-0023](DR-0023-softstart-injection-mirror-topology.md) | cascode the soft-start injection mirror (`Mgmo_ss` against `Mgmr_ss`) rather than restore an output-side clamp | ratified | - |
| [DR-0024](DR-0024-startup-current-budget-at-1uf.md) | restate the Startup row as a startup-current budget at 1 µF, and re-centre the soft-start ramp ~5x faster | ratified | - |
| [DR-0025](DR-0025-model-bin-selection-binds-on-per-finger-width.md) | gf180mcu model-bin selection binds on the per-finger width `W/NF`; this repo pins it in the deck rather than inheriting it from the host | ratified | - |
| [DR-0026](DR-0026-softstart-injection-accuracy-by-local-feedback.md) | make the soft-start injection transconductance accurate by local feedback, rather than by scaling the feedback transimpedance or reinstating an output-side clamp | ratified | - |
| [DR-0027](DR-0027-wnflag-facts-reproduce-across-ngspice-majors.md) | DR-0025's `wnflag` model-bin facts reproduce on ngspice-42 and ngspice-47; the ngspice-46 pin does not move | proposed | - |
| [DR-0029](DR-0029-softstart-injection-branch-gating-negative-result.md) | gate the soft-start injection transconductor's degeneration branches off a self-referential mirror node — proposed mechanism, not yet ready to ratify | proposed | - |
| [DR-0030](DR-0030-contact-layer-em-placeholder.md) | The `CON` contact layer's EM limit is a 129 µA/cut placeholder, with a falsifiable revisit trigger | proposed | - |
| [DR-0031](DR-0031-psrr-binds-on-the-softstart-injection-settled-state.md) | the ratified PSRR row binds on the soft-start injection element's *settled* state, and rectification-by-mirror-cutoff cannot meet it — negative result, plus the target it adds (T8) | proposed | - |
| [DR-0032](DR-0032-pass-device-width-is-capped-by-loop-gain-margin.md) | the pass device stays at W = 2 mm — the < 200 mV dropout stretch is unreachable by widening alone, capped by the ratified loop gain margin | proposed | - |
| [DR-0033](DR-0033-poly-resistor-flavour-is-set-by-dc-current-not-by-area.md) | A poly resistor's flavour is chosen by whether it carries DC current, not by its area — `Rbias` stays `ppolyf_u_1k`, the rest of `error_amp`'s field goes to `ppolyf_u_3k` | proposed | - |
| [DR-0034](DR-0034-the-dropout-stretch-unlocks-on-margin-dr-0033-already-delivered.md) | The 1.9 dB `DR-0032` was short of arrived with `DR-0033`, not from a compensation change — the pass device goes to W = 2.8 mm and the `< 200 mV` dropout stretch is met | proposed | - |
| [DR-0035](DR-0035-vin-referenced-softstart-ramp-ceiling.md) | reference the soft-start ramp ceiling to `VIN`, not to `VREF` — the ratified PSRR row closes with 9.6 dB of margin, and the Iq the branches burn after hand-over comes back with it | proposed | - |
| [DR-0036](DR-0036-softstart-branch-standing-current-is-recovered-at-the-ramp-ceiling-not-at-the-branches.md) | the soft-start injection branches' standing current is recovered at the ramp ceiling, not at the branches — branch-supply gating converges, and still loses | proposed | - |
| [DR-0037](DR-0037-vref-forcing-servo-replaces-the-idealized-bias-cccs.md) | a VREF-forcing V-to-I servo replaces the idealized `Fbias` / `Fss_ramp` CCCS in `ldo_ilimit` and `ldo_softstart` | proposed | - |
| [DR-0038](DR-0038-error-amp-stays-in-tree-against-gf180-opamp.md) | `error_amp` stays in tree -- `gf180-opamp`'s published amplifier is not comparable evidence, and what it does show is not a viable base | proposed | - |
| [DR-0039](DR-0039-line-reg-ff-125c-is-the-softstart-injection-residual.md) | the `ff_125c_3.30v` line-regulation failure is the soft-start injection element's settled residual, not loop gain — the 5 mV/V bound stays and DR-0035's VIN-referenced ceiling has to be re-landed over DR-0037 | proposed | - |
| [DR-0040](DR-0040-pass-array-generator-stays-own-against-gate-driver-power-array-folded.md) | the pass-array generator stays its own -- `gf180-gate-driver`'s `power_array_folded` solves a different problem (a row fold this array does not need), and neither generator subsumes the other | proposed | - |
| [DR-0041](DR-0041-new-evidence-bytes-go-to-the-artifact-store-git-keeps-manifests.md) | new evidence bytes go to the fleet artifact store; git keeps a manifest and the Markdown record | proposed | - |
| [DR-0043](DR-0043-ngspice-pin-is-a-major-version-floor-not-an-exact-version.md) | the ngspice pin is a major-version floor (at least ngspice-46), not an exact version | proposed | - |

## Design citations of unratified records

`design/*.sch` cites these records that are not ratified (report-only; ranked by total citations). CI fails on a cited record with no file, or a cited superseded record with no `superseded by` pointer.

| DR | Status | Citing file | Count |
|---|---|---|---|
| DR-0009 | proposed | design/error_amp.sch | 4 |
| DR-0007 | held | design/error_amp.sch | 2 |
| DR-0007 | held | design/ldo_core.sch | 1 |
| DR-0015 | proposed | design/error_amp.sch | 3 |
| DR-0021 | proposed | design/ldo_core.sch | 3 |
| DR-0029 | proposed | design/ldo_softstart.sch | 3 |
| DR-0036 | proposed | design/ldo_softstart.sch | 3 |
| DR-0012 | proposed | design/error_amp.sch | 2 |
| DR-0027 | proposed | design/ldo_softstart.sch | 2 |
| DR-0032 | proposed | design/ldo_core.sch | 2 |
| DR-0033 | proposed | design/error_amp.sch | 1 |
| DR-0033 | proposed | design/ldo_core.sch | 1 |
| DR-0034 | proposed | design/ldo_core.sch | 1 |
| DR-0034 | proposed | design/ldo_ilimit.sch | 1 |
| DR-0035 | proposed | design/ldo_softstart.sch | 2 |
| DR-0031 | proposed | design/ldo_softstart.sch | 1 |
