2AMLogic/gf180-ldo/spec/decision-records/DR-0032-pass-device-width-is-capped-by-loop-gain-margin.md

# DR-0032: the pass device stays at W = 2 mm — the < 200 mV dropout stretch is unreachable by widening alone, capped by the ratified loop gain margin

- **Status**: proposed
- **Date**: 2026-09-22
- **Decided by**: agent-builder, issue #139 (recommendation only)

## Context

`design/ldo_core.sch`'s pass device has shipped since issue #8 as
`pfet_03v3 L=0.28u W=2000u nf=40` (2 mm), described in the schematic itself as
a simplification of the ~4 mm sizing `sim/devchar/CONCLUSIONS.md` §1
recommends. Until #138 / `DR-0020` corrected the dropout *measurement* the
simplification had no measurable consequence. With the corrected measurement it
does: at 2 mm the ratified **< 300 mV** Dropout row still passes at every one of
27 PVT corners (worst 267.383 mV at `ss`/125 °C, 32.6 mV of margin), but the
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
