2AMLogic/gf180-ldo/sim/CHARACTERIZATION.md

# Characterization report

Aggregated, regeneratable rollup of every ratified `README.md` Target-specification row against the evidence currently committed under `sim/<slug>/records/`. This is issue #104 (T1/bronze checklist item 8, per #95's 2026-08-15 re-read).

## How this file is generated

```
python3 sim/build_characterization_report.py > sim/CHARACTERIZATION.md
```

This file is **generated, not hand-edited** — see `sim/build_characterization_report.py`'s module docstring for the exact verdict-extraction and freshness rules. Re-run it after any `sim/` record lands (or any `design/netlist/*.spice` change) and commit the regenerated file; do not edit this file by hand.

Current DUT netlist sha256: `design/netlist/ldo_core.spice` = `4f99a1a9dcf681be3b470b7f11c8cff1a7a3bc63b276f0aa909fe88dfef5e4e1`, `design/netlist/error_amp.spice` = `76841b846788afb832a627d942baeda532b89249767136f1467bd6c80eff736a`.

## Summary

| Spec row | Verdict | Fresh? | Evidence |
|---|---|---|---|
| Input | N/A | N/A | see note below |
| Output | FAIL | STALE | `sim/mc-output-accuracy/records/20260905-223503-3093ea1.md` (+ 3 more, see detail) |
| Load | N/A | N/A | see note below |
| Dropout @ 50 mA | PASS | fresh | `sim/dropout-vs-load/records/20261021-031411-06b3540.md` |
| Line reg | FAIL | fresh | `sim/line-regulation/records/20261021-032652-06b3540.md` |
| Load reg (0–50 mA) | PASS | fresh | `sim/load-regulation/records/20261021-031815-06b3540.md` |
| Load transient | PASS | STALE | `sim/load-transient/records/20260905-202554-3093ea1.md` |
| PSRR | FAIL | fresh | `sim/psrr-dc/records/20261021-023703-7d3b2a0.md` (+ 2 more, see detail) |
| Iq (excluding load current) | MIXED | fresh | `sim/quiescent-current/records/20261020-pdk-f6eeac7-iq.md` (+ 1 more, see detail) |
| Current limit | PASS | fresh | `sim/current-limit/records/20261020-pdk-f6eeac7-ilim.md` |
| Startup | MIXED | STALE | `sim/startup/records/20260916-112114-8b551ab.md` (+ 1 more, see detail) |
| Enable / shutdown | PASS | fresh | `sim/enable-shutdown/records/20261020-pdk-f6eeac7-en.md` |
| Thermal | PASS | fresh | `sim/current-limit/records/20261020-pdk-f6eeac7-ilim.md` |
| Output noise | N/A | N/A | see note below |
| Area | N/A | N/A | see note below |
| Stability | PASS | STALE | `sim/loop-stability/records/20260923-132038-a992b52.md` |

## Detail

### Input

**Ratified target**: 3.3 V ±10% (2.97–3.63 V)

**N/A**: Not independently tested: the 2.97-3.63 V input range is the Vin corner axis every other row's PVT sweep already covers, rather than a claim with a testbench of its own.

### Output

**Ratified target**: 1.8 V ±2% (fixed; divider laid out as a unit-resistor string for metal-mask-option derivatives)

**Verdict**: FAIL  **Fresh**: STALE

- `mc-output-accuracy` — statistical term (Monte Carlo mismatch): `sim/mc-output-accuracy/records/20260905-223503-3093ea1.md` — **PASS**, stale
  - Overall: PASS
- `amp-openloop` — deterministic systematic-offset term: `sim/amp-openloop/records/20261021-023703-7d3b2a0.md` — **PASS**, fresh (matches current `error_amp`)
  - Overall: PASS
- `line-regulation` — counted inside the window, not added to it: `sim/line-regulation/records/20261021-032652-06b3540.md` — **FAIL**, fresh (matches current `ldo_core`)
  - Overall: FAIL
- `load-regulation` — counted inside the window, not added to it: `sim/load-regulation/records/20261021-031815-06b3540.md` — **PASS**, fresh (matches current `ldo_core`)
  - Overall: PASS

### Load

**Ratified target**: 0–50 mA, where 0 mA means no external load — the feedback divider's ~2 µA is the only inherent preload and no external preload resistor may be assumed (DR-0001)

**N/A**: Not independently tested: the 0-50 mA operating-current axis is a condition exercised by the Dropout, Line reg, Load reg, Load transient, Current limit and PSRR rows, not a claim with a testbench of its own.

### Dropout @ 50 mA

**Ratified target**: < 300 mV — binds ss / 125 °C / Vin = 2.10 V (measured, note 4)

**Verdict**: PASS  **Fresh**: fresh

- `dropout-vs-load` — verdict rests on DR-0020's measurement definition (PROPOSED, not ratified): dropout read at the regulation knee. The ratified < 300 mV bound itself is unchanged. If the operator rejects DR-0020 this row reverts to FAIL on the superseded fixed-headroom metric: `sim/dropout-vs-load/records/20261021-031411-06b3540.md` — **PASS**, fresh (matches current `ldo_core`)
  - Overall: PASS

### Line reg

**Ratified target**: < 5 mV/V over Vin 2.97–3.63 V, at 1 mA and at 50 mA

**Verdict**: FAIL  **Fresh**: fresh

- `line-regulation`: `sim/line-regulation/records/20261021-032652-06b3540.md` — **FAIL**, fresh (matches current `ldo_core`)
  - Overall: FAIL

### Load reg (0–50 mA)

**Ratified target**: < 1% (18 mV), counted inside the ±2% accuracy window rather than in addition to it

**Verdict**: PASS  **Fresh**: fresh

- `load-regulation`: `sim/load-regulation/records/20261021-031815-06b3540.md` — **PASS**, fresh (matches current `ldo_core`)
  - Overall: PASS

### Load transient

**Ratified target**: 1 ↔ 50 mA step, 1 µs edges, at C_eff = 0.33 µF and ESR 0–500 mΩ: peak excursion ≤ 150 mV, recovery to within ±1% (18 mV) of the settled value in ≤ 20 µs

**Verdict**: PASS  **Fresh**: STALE

- `load-transient`: `sim/load-transient/records/20260905-202554-3093ea1.md` — **PASS**, stale
  - Overall: PASS

### PSRR

**Ratified target**: > 50 dB @ 1 kHz and > 20 dB @ 100 kHz, at I_load = 1 mA (binding — light load) and at 50 mA, C_eff = 1 µF nominal, verified across the stability window

**Verdict**: FAIL  **Fresh**: fresh

- `psrr-dc` — amp-level open-loop DC term: `sim/psrr-dc/records/20261021-023703-7d3b2a0.md` — **PASS**, fresh (matches current `error_amp`)
  - Overall: PASS
- `psrr-vs-freq` — closed-loop, 1 mA (binding light load): `sim/psrr-vs-freq/records/20261021-023703-7d3b2a0.md` — **FAIL**, fresh (matches current `ldo_core`)
  - Overall: FAIL
- `psrr-vs-freq-50ma` — closed-loop, 50 mA (full load): `sim/psrr-vs-freq-50ma/records/20261021-034534-0165a0b.md` — **FAIL**, fresh (matches current `ldo_core`)
  - Overall: FAIL

### Iq (excluding load current)

**Ratified target**: < 30 µA at no load **and** at full load — binds ff / 125 °C / 3.63 V

**Verdict**: MIXED  **Fresh**: fresh

- `quiescent-current`: `sim/quiescent-current/records/20261020-pdk-f6eeac7-iq.md` — **MIXED**, fresh (matches current `ldo_core`)
  - Overall (Iq, ratified < 30 uA enabled, no load and 50 mA): PASS … FAIL at `ss_-40c_2.97v` / Overall (shutdown Iq, ratified < 3 uA): PASS
- `enable-shutdown` — same run also substantiates this row's full-load enabled-state clause: `sim/enable-shutdown/records/20261020-pdk-f6eeac7-en.md` — **PASS**, fresh (matches current `ldo_core`)
  - Overall (Enable / shutdown, ratified shutdown Iq < 3 uA, Vin->Vout leakage <= 1 uA, disabled state): PASS / Overall (Iq at full load, ratified < 30 uA, enabled state): PASS

### Current limit

**Ratified target**: 62–95 mA over PVT untrimmed, constant-current (brickwall) clamp; never engages for I_load ≤ 50 mA at any corner (binds ff / −40 °C, strongest pass drive); survives a continuous Vout = 0 short at Vin_max (note 5, note 9)

**Verdict**: PASS  **Fresh**: fresh

- `current-limit`: `sim/current-limit/records/20261020-pdk-f6eeac7-ilim.md` — **PASS**, fresh (matches current `ldo_core`)
  - Overall (current limit, ratified 62–95 mA window): PASS

### Startup

**Ratified target**: monotonic into any load 0–50 mA and any C_eff in the stability window; controlled ramp ≤ 5 V/ms, so inrush ≤ 5 mA and startup at full rated load stays ≥ 10 mA below the current limit, both at C_eff = 1 µF (nominal) — above 1 µF both clauses are characterized, not bound, up to DR-0001's 4.7 µF ceiling (note 5a); inside ±2% within 1.8 ms of enable (note 8); overshoot ≤ +2% of the final value

**Verdict**: MIXED  **Fresh**: STALE

- `startup`: `sim/startup/records/20260916-112114-8b551ab.md` — **PASS**, stale
  - Overall: PASS
- `soft-start`: `sim/soft-start/records/20260918-190207-8a59d23.md` — **MIXED**, stale
  - Overall (Startup, ratified row, DR-0006): FAIL on ramp rate … and FAIL on inrush and current-limit clearance … PASS on the ratified ≤ 6 ms settling clause at 163/163 … PASS on the ratified ±2% settled-accuracy allocation at 161/163 / Overall (Startup, DR-0024 proposed bounds, not yet ratified): PASS on ramp rate (163/163 ≤ 5 V/ms) and settling (163/163 ≤ 1.8 ms) … FAIL on inrush, current-limit clearance, monotonicity and peak dV_out/dt / Overall (issue #246's own targets, `design/softstart_injection_ compensation.md` §3): T5 PASS at 63/63 … and T6/T7 PASS re-measured against the cascoded element … T1, T2, T3 and T4 FAIL / Overall (the named `softstart_injection_compensation.md` §4 experiment): conclusive.

### Enable / shutdown

**Ratified target**: shutdown Iq < 3 µA at ff / 125 °C / 3.63 V; disabled output state is pass device fully off with no internal active discharge; Vin→Vout leakage ≤ 1 µA at the same corner

**Verdict**: PASS  **Fresh**: fresh

- `enable-shutdown`: `sim/enable-shutdown/records/20261020-pdk-f6eeac7-en.md` — **PASS**, fresh (matches current `ldo_core`)
  - Overall (Enable / shutdown, ratified shutdown Iq < 3 uA, Vin->Vout leakage <= 1 uA, disabled state): PASS / Overall (Iq at full load, ratified < 30 uA, enabled state): PASS

### Thermal

**Ratified target**: 92 mW continuous worst case (Vin 3.63 V at 50 mA); ≤ 346 mW into a Vout = 0 short at the untrimmed 95 mA limit ceiling (note 9); specified to Tj ≤ 125 °C — θJA and sustained-short survivability delegated to the package/integration spec

**Verdict**: PASS  **Fresh**: fresh

- `current-limit` — only substantiates the '<=290 mW into a short' clause; the '92 mW continuous worst case' clause has no dedicated testbench of its own: `sim/current-limit/records/20261020-pdk-f6eeac7-ilim.md` — **PASS**, fresh (matches current `ldo_core`)
  - Overall (thermal, ratified <= 346 mW into a short): PASS

### Output noise

**Ratified target**: not specified — explicitly waived (note 7)

**N/A**: Explicitly waived, README note 7 -- no consumer requirement exists to substantiate a number against.

### Area

**Ratified target**: < 0.1 mm² total core area, pass FET included, excluding pads and sealring

**N/A**: Not simulable pre-layout -- no LDO layout exists yet (#2).

### Stability

**Ratified target**: stable 0.1-50 mA at C_eff = 1 uF nominal (X5R/X7R), ESR >= 200 mOhm; PM >= 45 deg, GM >= 10 dB worst corner (630/630 matrix points, worst 48.65 deg / 11.21 dB, DR-0008 resurgence clean 0/630). The full 0.33-4.7 uF / no-minimum-ESR window is NOT verified: 1523/1890 of its 0.1-50 mA points pass and the shortfall is structural (DR-0015, DR-0017), needing f_hi (buffer bandwidth) to close -- see DR-0016 Candidate 2 and DR-0019, which measures that lever foreclosed by the amplifier's own iq_ua allocation (issue #147). 0 mA (no external load) remains outside the envelope per DR-0007.

**Verdict**: PASS  **Fresh**: STALE

- `loop-stability` — verdict is computed from this record's own committed `-matrix.csv`, filtered to the ratified DR-0018 envelope (0.1-50 mA, C_eff = 1 uF, ESR >= 200 mOhm), not from the record's full-matrix prose verdict -- that prose states DR-0001's ORIGINAL, wider 4536-point matrix, which this row no longer claims (DR-0018, ratified 2026-09-15). The wider-matrix result is kept visible alongside the envelope verdict below, not dropped; points outside the envelope are covered by DR-0018 (cap/ESR) and DR-0007 (0 mA) -- subset accounting cross-checked in sim/loop-stability/records/20260922-022122-ac57c94.md: `sim/loop-stability/records/20260923-132038-a992b52.md` — **PASS**, stale
  - envelope (DR-0018, 0.1-50 mA / C_eff=1uF nominal / ESR>=200 mOhm): **PASS** -- 630/630 points passing, worst PM 48.65 deg / worst GM 11.21 dB, DR-0008 resurgence flagged 0/630; full matrix (DR-0001's original, wider window): 2790/4536 passing

## Tally

16 ratified rows: 12 testable (7 PASS, 3 FAIL, 2 MIXED, 0 UNKNOWN), 4 N/A.

Freshness among the 12 testable rows: 8 fresh, 4 stale, 0 unknown.

A row is only a true current PASS if its Verdict column reads PASS **and** its Fresh column reads fresh — a stale PASS reflects a design state this repo has since moved past, not a claim about `design/netlist/ldo_core.spice` as committed today.

## Appendix: supporting testbenches (not a ratified spec row)

These `sim/` experiment directories exist and carry real evidence but do not map to a distinct row of README.md's Target specification table — listed for completeness, not tallied above.

| Experiment | Role |
|---|---|
| `amp-selfosc` | precondition check for loop-stability's Bode margins (the error amp's own local loop must not self-oscillate); not itself a ratified spec row. |
| `op-point-sanity` | loop-closure sanity check, not a ratified spec row. |
| `smoke-bias` | harness self-verification (PVT plumbing), not a spec claim. |
| `devchar` | PDK device characterization feeding other rows' assumptions (e.g. divider-mismatch, README note 3); has no records/ directory of its own -- see sim/devchar/CONCLUSIONS.md. |
| `vref-transfer` | VREF-to-VOUT small-signal transfer over frequency, light load (1 mA) -- issue #178 / DR-0021 Decision #3's 'accuracy / tempco / noise / its own PSRR' contract-table row; not itself a ratified spec row (no threshold exists for this transfer), but its measured gain feeds the reference accuracy-class budget derived in sim/vref-transfer/README.md. |
| `vref-transfer-50ma` | VREF-to-VOUT small-signal transfer over frequency, full load (50 mA) -- the load-dependent sibling of vref-transfer, same role. |
| `soft-start-loop-gain` | small-signal loop gain, phase margin, gain margin and the DR-0008 gain-resurgence metric of the main loop *during* the soft-start hand-over, held at pinned points of the ramp across the `device`/`binj` DUT variants (issue #196). Not a ratified spec row, and explicitly not a DR-0001 verdict: DR-0001's matrix is the settled operating point, where the ramp is over and the FB injection is off, so `loop-stability` remains the Stability row's evidence and nothing here moves it -- see sim/soft-start-loop-gain/README.md, "What it measures, and what it deliberately does not". |
| `toolchain-portability` | measures the *simulator*, not the design (issue #254 / DR-0027): whether DR-0025's `wnflag` model-bin facts and `sim/loop-stability`'s loop-gain margins reproduce across ngspice majors (42, 46, 47). Not a ratified spec row and explicitly never a DR-0001 (or any other spec-line) verdict -- see sim/toolchain-portability/README.md, "What a record here may and may not conclude". No sim/loop-stability record is added, edited, or superseded by anything under this slug. |

---

Generated by `sim/build_characterization_report.py`. Not itself evidence — see the append-only records under `sim/<slug>/records/` for that. Regenerate after any `sim/` record lands or `design/netlist/*.spice` changes; do not hand-edit.
