2AMLogic/gf180-ldo/sim/devchar/caps/results/moscap.csv

device | moscap_corner | temp_c | vbias_v | w_um | l_um | area_um2 | c_f | c_density_ff_per_um2
cap_nmos_03v3 | moscap_typical | -40 | -3.30 | 10 | 10 | 100 | 2.3E-15 | 0.023
cap_nmos_03v3 | moscap_typical | -40 | -3.30 | 30 | 30 | 900 | 2.07E-14 | 0.023
cap_pmos_03v3 | moscap_typical | -40 | -3.30 | 10 | 10 | 100 | 3.958E-13 | 3.958
cap_pmos_03v3 | moscap_typical | -40 | -3.30 | 30 | 30 | 900 | 3.5622E-12 | 3.958
cap_nmos_03v3_b | moscap_typical | -40 | -3.30 | 10 | 10 | 100 | 9.25427E-14 | 0.925427
cap_nmos_03v3_b | moscap_typical | -40 | -3.30 | 30 | 30 | 900 | 8.32884E-13 | 0.925427
cap_pmos_03v3_b | moscap_typical | -40 | -3.30 | 10 | 10 | 100 | 3.97499E-13 | 3.97499
cap_pmos_03v3_b | moscap_typical | -40 | -3.30 | 30 | 30 | 900 | 3.57749E-12 | 3.97499
cap_nmos_06v0 | moscap_typical | -40 | -3.30 | 10 | 10 | 100 | 3.7E-15 | 0.037
cap_nmos_06v0 | moscap_typical | -40 | -3.30 | 30 | 30 | 900 | 3.33E-14 | 0.037
cap_pmos_06v0 | moscap_typical | -40 | -3.30 | 10 | 10 | 100 | 2.177E-13 | 2.177
cap_pmos_06v0 | moscap_typical | -40 | -3.30 | 30 | 30 | 900 | 1.9593E-12 | 2.177
cap_nmos_03v3 | moscap_typical | -40 | -3.15 | 10 | 10 | 100 | 2.3E-15 | 0.023
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
