2AMLogic/gf180-ldo/sim/devchar/caps/results/summary_mim.csv

device | mim_corner | temp_c | size_um | c_at_0v_f | density_at_0v_ff_per_um2 | c_spread_over_bias_ppm | voltage_coeff_0_to_3v3_ppm_per_v | area_density_ff_per_um2 | perimeter_density_ff_per_um | density_at_0v_large_ff_per_um2
cap_mim_1f0_m2m3_noshield | mimcap_ff | -40 | 10 | 1.00623e-13 | 1.00623 | 0 | 0 | 0.887528 | 0.296754 | 0.927095
cap_mim_1f0_m2m3_noshield | mimcap_ff | 27 | 10 | 1.00713e-13 | 1.00713 | 0 | 0 | 0.888322 | 0.297021 | 0.927924
cap_mim_1f0_m2m3_noshield | mimcap_ff | 125 | 10 | 1.00836e-13 | 1.00836 | 0 | 0 | 0.889413 | 0.297367 | 0.929062
cap_mim_1f0_m2m3_noshield | mimcap_ss | -40 | 10 | 1.22983e-13 | 1.22983 | 0 | 0 | 1.08475 | 0.362696 | 1.13312
cap_mim_1f0_m2m3_noshield | mimcap_ss | 27 | 10 | 1.23093e-13 | 1.23093 | 0 | 0 | 1.08573 | 0.362988 | 1.13413
cap_mim_1f0_m2m3_noshield | mimcap_ss | 125 | 10 | 1.23244e-13 | 1.23244 | 0 | 0 | 1.08706 | 0.363442 | 1.13552
cap_mim_1f0_m2m3_noshield | mimcap_typical | -40 | 10 | 1.11803e-13 | 1.11803 | 0 | 0 | 0.986143 | 0.329717 | 1.03011
cap_mim_1f0_m2m3_noshield | mimcap_typical | 27 | 10 | 1.11903e-13 | 1.11903 | 0 | 0 | 0.987025 | 0.330013 | 1.03103
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
