2AMLogic/gf180-ldo/sim/devchar/caps/results/summary_mim_pvt.csv

device | size_um | c_typical_27c_f | c_max_f | c_max_corner | c_max_temp_c | c_min_f | c_min_corner | c_min_temp_c | pvt_spread_pct_of_typical | tc_27_to_125_ppm_per_c | tc_m40_to_27_ppm_per_c
cap_mim_1f0_m2m3_noshield | 10 | 1.11903e-13 | 1.23244e-13 | mimcap_ss | 125 | 1.00623e-13 | mimcap_ff | -40 | 20.2148 | 12.4926 | 13.3378
cap_mim_1f5_m2m3_noshield | 10 | 1.62173e-13 | 1.87926e-13 | mimcap_ss | 125 | 1.36624e-13 | mimcap_ff | -40 | 31.6341 | 33.5998 | 44.9124
cap_mim_1f5_m3m4_noshield | 10 | 1.62173e-13 | 1.87926e-13 | mimcap_ss | 125 | 1.36624e-13 | mimcap_ff | -40 | 31.6341 | 33.5998 | 44.9124
cap_mim_1f5_m4m5_noshield | 10 | 1.62173e-13 | 1.87926e-13 | mimcap_ss | 125 | 1.36624e-13 | mimcap_ff | -40 | 31.6341 | 33.5998 | 44.9124
cap_mim_1f5_m5m6_noshield | 10 | 1.62173e-13 | 1.87926e-13 | mimcap_ss | 125 | 1.36624e-13 | mimcap_ff | -40 | 31.6341 | 33.5998 | 44.9124
cap_mim_2f0_m2m3_noshield | 10 | 2.08538e-13 | 2.29593e-13 | mimcap_ss | 125 | 1.87457e-13 | mimcap_ff | -40 | 20.2054 | 8.95447 | 18.1076
