2AMLogic/gf180-ldo/sim/devchar/caps/results/summary_moscap.csv

device | moscap_corner | temp_c | size_um | density_max_ff_per_um2 | vbias_at_max_v | density_min_ff_per_um2 | vbias_at_min_v | density_at_0v_ff_per_um2 | density_at_p1v65_ff_per_um2 | density_at_m1v65_ff_per_um2 | max_over_min_ratio | knee_v_at_half_swing | usable_bias_min_v | usable_bias_max_v
cap_nmos_03v3 | moscap_ff | -40 | 10 | 3.5847 | 1.8 | 0.0207 | -3.3 | 0.0220543 | 3.58469 | 0.0207 | 173.174 | 0.633882 | 0.9 | 3.3
cap_nmos_03v3 | moscap_ff | -40 | 30 | 3.5847 | 1.8 | 0.0207 | -3.3 | 0.0220543 | 3.58469 | 0.0207 | 173.174 | 0.633882 | 0.9 | 3.3
cap_nmos_03v3 | moscap_ff | 27 | 10 | 3.5847 | 1.8 | 0.0207 | -3.3 | 0.0220543 | 3.58469 | 0.0207 | 173.174 | 0.633882 | 0.9 | 3.3
cap_nmos_03v3 | moscap_ff | 27 | 30 | 3.5847 | 1.8 | 0.0207 | -3.3 | 0.0220543 | 3.58469 | 0.0207 | 173.174 | 0.633882 | 0.9 | 3.3
cap_nmos_03v3 | moscap_ff | 125 | 10 | 3.5847 | 1.8 | 0.0207 | -3.3 | 0.0220543 | 3.58469 | 0.0207 | 173.174 | 0.633882 | 0.9 | 3.3
cap_nmos_03v3 | moscap_ff | 125 | 30 | 3.5847 | 1.8 | 0.0207 | -3.3 | 0.0220543 | 3.58469 | 0.0207 | 173.174 | 0.633882 | 0.9 | 3.3
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
