2AMLogic/gf180-ldo/sim/devchar/fets/results/cgg_nmos.csv

device | corner | temp_c | vin_v | l_um | w_mm | metric | cgg_f | cgd_f | cgg_per_mm_f
nfet_03v3 | typical | -40 | 2.10 | 0.28u | 1 | cgg_at_vds300mV | 8.00449E-13 | 3.18346E-13 | 8.00449E-13
nfet_03v3 | typical | -40 | 2.10 | 0.28u | 2 | cgg_at_vds300mV | 1.6009E-12 | 6.36691E-13 | 8.00449E-13
nfet_03v3 | typical | -40 | 2.10 | 0.28u | 4 | cgg_at_vds300mV | 3.20179E-12 | 1.27338E-12 | 8.00449E-13
nfet_03v3 | typical | -40 | 2.10 | 0.28u | 8 | cgg_at_vds300mV | 6.40359E-12 | 2.54677E-12 | 8.00449E-13
nfet_03v3 | typical | -40 | 2.10 | 0.28u | 16 | cgg_at_vds300mV | 1.28072E-11 | 5.09353E-12 | 8.00449E-13
nfet_03v3 | typical | -40 | 2.10 | 0.50u | 1 | cgg_at_vds300mV | 8.07787E-13 | 1.87434E-13 | 8.07787E-13
nfet_03v3 | typical | -40 | 2.10 | 0.50u | 2 | cgg_at_vds300mV | 1.61557E-12 | 3.74869E-13 | 8.07787E-13
nfet_03v3 | typical | -40 | 2.10 | 0.50u | 4 | cgg_at_vds300mV | 3.23115E-12 | 7.49738E-13 | 8.07787E-13
nfet_03v3 | typical | -40 | 2.10 | 0.50u | 8 | cgg_at_vds300mV | 6.46229E-12 | 1.49948E-12 | 8.07787E-13
nfet_03v3 | typical | -40 | 2.10 | 0.50u | 16 | cgg_at_vds300mV | 1.29246E-11 | 2.99895E-12 | 8.07787E-13
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
