2AMLogic/gf180-ldo/WORK_LOG.md

# Work Log

Merged PRs and closed issues from the initial 30-day Guide review window.

## Archives

- [2026-09](work_log/WORK_LOG_2026-09.md)

### 2026-11-08

- **PR #564**: feat: add 1 uF load-transient PVT records with recovery time

### 2026-11-07

- **PR #562**: Bump Repo Skills 0.25.1 -> 0.25.10

### 2026-11-06

- **PR #557**: feat: report files and bytes added per sim slug on PRs (non-blocking)
- **Issue #388** (closed): ci: report sim/ evidence growth per PR and cap runaway additions (append-only evidence can only grow)
- **PR #558**: refactor(layout): share one guard_ring in gen_gds_common
- **Issue #555** (closed): Deduplicate the two _guard_ring implementations into gen_gds_common
- **PR #553**: refactor: collapse quiescent-current klt_run onto tb_adapter
- **Issue #476** (closed): Collapse quiescent-current klt_run.py onto tb_adapter (duplicate grade/main/PDK pin gap)
- **PR #556**: feat: cite limit-checked sim envelopes as T1 item 5 evidence
- **Issue #552** (closed): T1 item 5: cite #538's limit-checked envelopes for Current limit, Dropout, Load reg, Enable/shutdown

### 2026-11-05

- **PR #550**: refactor: run xschem netlist export through klt netlist with a bounded timeout
- **Issue #549** (closed): Simplify: replace hand-rolled xschem subprocess in xschem_export.py with klt netlist (also adds missing timeout)
- **PR #546**: sim: soft-start startup peak is equal in both DUTs across the full PVT and EXTRA_CAPS matrix
- **Issue #351** (closed): Explain the 2x lower peak Icap / dV/dt at soft-start with the DR-0037 bias servo (142 vs 282 mA at tt/27C)

### 2026-11-04

- **PR #543**: sim(enable-shutdown): add 63-corner batch envelope with ratified limits
- **Issue #538** (closed): sim: declare limits and spec_row in klt_run front ends and re-mint envelopes for the passing T1 item-5 rows (current limit, enable/shutdown, dropout, load reg)
- **PR #541**: feat(sim): declare ratified limits and spec_row in klt envelopes
- **PR #539**: signoff: declare all ratified item-5 rows as gaps and grade against a klt git rev
- **Issue #523** (closed): T1 item 5 (corner verification): declare the ratified row set and cite klt sim corner envelopes per row in the block manifest

### 2026-11-02

- **Issue #366** (closed): sim: route the remaining ratified-row PVT grid drivers (loop-stability, current-limit, enable-shutdown, soft-start) through klt_batch instead of local fan-out

### 2026-10-31

- **PR #534**: Bump Repo Skills 0.24.7 -> 0.25.1

### 2026-10-27

- **PR #527**: chore(signoff): pin klayout-tools to PyPI 0.8.0 and regenerate T1 record
- **Issue #526** (closed): Bump klayout-tools pin dc136150a49e → 0.8.0

### 2026-10-25

- **PR #520**: sim: parameterise load-transient output network, add --param override and recovery measures

### 2026-10-24

- **PR #517**: refactor: restore helper names and wrap long line in gen_gds
- **Issue #510** (closed): pass_array/gen_gds.py: revert over-broad renames from #509 (_insert_merged_region, _contacts_per_merged_region)
- **PR #509**: refactor: hoist PCell-instantiate and merged-region helpers into gen_gds_common
- **Issue #508** (closed): Hoist repeated PCell-instantiate and merged-layer-region helpers into gen_gds_common.py

### 2026-10-23

- **PR #512**: feat: store new sim evidence via the artifact store, commit manifests only
- **Issue #511** (closed): Adopt the common artifact store for sim evidence (manifests in git, bytes via klt artifact)

### 2026-10-22

- **PR #505**: feat(signoff): attest T1 items 1, 9 and 10 via klt signoff --attest
- **Issue #448** (closed): signoff: attest T1 items 1, 9 and 10 with klt signoff --attest envelopes
- **PR #490**: sim: attribute load-transient excursions to the DR-0034 pass width and the out-of-envelope output network
- **PR #499**: docs: record pass-array generator stays its own vs gate-driver power_array_folded (DR-0040)
- **Issue #498** (closed): Adopt or record: pass-device array generator vs gf180-gate-driver's folded power array (REUSE.md)

### 2026-10-21

- **PR #494**: refactor(sim): share klt grid retry driver between loop sweeps
- **Issue #492** (closed): Dedup run_grid_klt() DC-seed retry driver and backend selection between loop sweeps
- **PR #491**: refactor(sim): share ROW coercion and curve capture between loop sweeps
- **Issue #489** (closed): Dedup run_curve() and ROW coercion between loop-stability and soft-start-loop-gain sweep.py (falsy-zero NaN drift)
- **PR #487**: sim(mc-output-accuracy): attribute the divider-identity residual to the soft-start FB injection element
- **PR #481**: Bump Repo Skills 0.24.3 -> 0.24.7
- **PR #486**: sim: re-qualify load-transient, startup and mc-output-accuracy at f6eeac7 via klt sim
- **Issue #464** (closed): sim: add klt sim front ends and re-qualify the tb.json reference benches at open_pdks f6eeac7 (part of #430)
- **Issue #469** (closed): sim: re-qualify transient and Monte Carlo benches load-transient, startup, mc-output-accuracy at f6eeac7 via klt sim (part of #464)
- **PR #480**: sim: gate the psrr-vs-freq-50ma sink on the supply so ss/-40C/2.97V reaches 50 mA physically
- **PR #479**: fix(sim): reach DC bench operating points by continuation so the sweeps stay off the pass-device-off root
- **PR #477**: sim: re-qualify amp-openloop and the PSRR benches at open_pdks f6eeac7 on the batch fleet
- **PR #475**: spec: DR-0039 attributes the ff/125C line-regulation failure to the soft-start injection residual
- **PR #474**: sim: shared tb.json klt adapter and fleet re-qualification of three DC-sweep benches at open_pdks f6eeac7
- **PR #471**: refactor: share one ngspice measurement-line parser across harness consumers
- **PR #466**: sim: re-qualify iq, current-limit, enable-shutdown at open_pdks f6eeac7 via staged models
- **Issue #478** (closed): sim: psrr-vs-freq-50ma ss_-40c_2.97v converges to the pass-device-off state (Vout 0.145 V, 5.0 mA)
- **Issue #473** (closed): line-regulation: ff_125c_3.30v reads ~8.2 mV/V against the ratified 5 mV/V bound (design or spec decision; split from #472)
- **Issue #472** (closed): sim: three DC-sweep benches regress on the DR-0037 DUT (dropout knee guard x5, ss/-40C false convergence x2)
- **Issue #470** (closed): Consolidate three drifting ngspice measurement parsers into one
- **Issue #468** (closed): sim: re-qualify AC benches amp-openloop, psrr-dc, psrr-vs-freq, psrr-vs-freq-50ma at f6eeac7 via klt sim (part of #464)
- **Issue #467** (closed): sim: shared tb.json klt adapter + re-qualify dropout-vs-load, line-regulation, load-regulation at f6eeac7 (part of #464)
- **PR #462**: refactor: hoist grid rollup and CSV writer into harness.pvt_log
- **Issue #461** (closed): Dedup rollup/write_csv between enable-shutdown and current-limit summarize.py

### 2026-10-20

- **PR #431**: feat(sim): pin PDK to open_pdks f6eeac7 via ciel and refuse mismatched trees
- **Issue #429** (closed): Re-pin open_pdks to f6eeac7: ciel install, PDK search + revision check (phase 1 of #428)

### 2026-10-18

- **PR #458**: refactor(sim): share klt_run argparse prologue and summary.csv writer
- **Issue #456** (closed): Dedupe klt_run.py wrappers: shared argparse prologue and summary.csv writer

### 2026-10-17

- **PR #455**: sim(soft-start-loop-gain): add klt sim batch front end for the margin and hand-over decks
- **Issue #451** (closed): sim: batch front end for the soft-start-loop-gain Tian bench (follow-up to #366)
- **PR #452**: sim(loop-stability): add klt sim batch front end for the Tian loop-gain grid
- **PR #450**: sim: add klt sim batch front end for enable-shutdown PVT grid
- **PR #446**: sim: cap local jobs at 2 and require explicit backend for remaining grid drivers

### 2026-10-16

- **PR #442**: sim(soft-start): cap per-unit batch timeout at 3480 s to fit the fleet job ceiling (#320, partial)
- **PR #439**: sim(soft-start): complete the 63-point PVT matrix for the DR-0037 servo via per-process batch shards
- **PR #434**: Bump Repo Skills 0.24.1 -> 0.24.3

### 2026-10-15

- **PR #432**: sim(quiescent-current): 81-point PVT record for the DR-0037 bias servo (#320, partial)
- **PR #427**: test: disable git auto-maintenance in temp-repo test fixtures
- **PR #425**: sim(current-limit): full PVT record for the DR-0037 bias servo (#320, partial)
- **PR #424**: Bump Repo Skills 0.19.5 -> 0.24.1
- **PR #419**: fix(harness): validate manifest checks at load (#418)
- **PR #380**: fix(sim): protect frozen netlist snapshots with the append-only guard
- **Issue #426** (closed): test flake: test_lock_note_text_tamper_fails errors on temp-dir cleanup (Directory not empty)
- **Issue #418** (closed): sim: reject malformed check definitions before a PVT run
- **Issue #378** (closed): Protect frozen DUT netlist snapshots with the append-only evidence guard
- **Issue #374** (closed): sim: phase 2 of #366 - route current-limit, enable-shutdown, soft-start, soft-start-loop-gain grid drivers through klt_batch

### 2026-10-14

- **Issue #293** (closed): README: embed the fleet burndown chart (one line)

### 2026-10-13

- **PR #400**: ci: fail when README T1 tier/count prose disagrees with the verdict of record
- **Issue #398** (closed): ci: fail when README T1 tier/count prose disagrees with signoff/records/t1-tier-report.json

### 2026-10-12

- **PR #423**: sim: make append-only record writes atomic under concurrent writers
- **PR #421**: fix(sim): fail closed on non-finite measurements and statistics (#420)
- **PR #417**: spec: extend the amendment guard to ratified README notes
- **PR #415**: fix(ci): size nightly startup smoke budget from measurement (#409)
- **PR #414**: fix(ci): cover top-level layout/records in host-path guard (#413)
- **PR #412**: fix(sim): require complete unique stability-matrix coverage before row PASS
- **Issue #422** (closed): sim: make append-only record writes atomic under concurrent writers
- **Issue #420** (closed): sim: prevent measurement overflow from silently passing spread checks
- **Issue #416** (closed): spec: extend the amendment guard to ratified README notes
- **Issue #413** (closed): ci: include top-level layout records in the host-path evidence guard
- **Issue #411** (closed): Auditor: CI reader counts superseded cancelled checks as failures
- **Issue #410** (closed): Require complete, unique stability-matrix coverage before the characterization row can PASS
- **Issue #409** (closed): Build/runtime failure on main: nightly startup smoke times out after 300 seconds

### 2026-10-10

- **PR #407**: sim: reject failed ngspice runs even when all generic PVT measurements parse
- **Issue #406** (closed): sim: reject failed ngspice runs even when all generic PVT measurements parse

### 2026-10-09

- **PR #404**: ci: pin the ratified README spec table behind a lock and DR amendments
- **PR #403**: ci: harden ci.yml (permissions, concurrency, timeouts, pin uv/volare)
- **Issue #397** (closed): ci: pin the ratified README spec table so a row cannot change without a decision record
- **Issue #402** (closed): ci: harden ci.yml (least-privilege permissions, concurrency, timeouts, pin uv/volare)

### 2026-10-08

- **PR #394**: Bind characterization freshness to the designated DUT
- **PR #392**: spec: index design citations of unratified decision records (#387)
- **PR #389**: spec: DR-0038 resolves error_amp reuse 'evaluate' (keep own)
- **PR #386**: test: golden-record unit tests for the sim rollup scripts
- **PR #385**: docs: README repository layout lists every tracked top-level path (#383)
- **PR #382**: ci: adopt correctness-only ruff (F+E9) lint gate
- **PR #379**: Dedupe gen_gds helpers: route divider and testcell through gen_gds_common (#370)
- **PR #375**: sim(loop-stability): cap local jobs at 2, require explicit --backend local (Part of #366)
- **PR #373**: fix(sim): stop embedding absolute host paths in records (#365)
- **PR #372**: ci: enforce append-only evidence rule at PR level
- **PR #369**: Generate status index for spec/decision-records (#362)
- **PR #368**: docs(signoff): README reflects the two drawn layout cells (Part of #79)
- **PR #364**: Enforce pinned xschem 3.4.7 in netlist export (#361)
- **PR #360**: sim(soft-start): bias-acquisition characterization of both DR-0037 servos (#352)
- **Issue #393** (closed): Bind characterization freshness to the designated DUT
- **Issue #387** (closed): Cross-check design/ schematic DR citations against decision-record status (surface load-bearing unratified records)
- **Issue #384** (closed): Resolve reuse.lock.json 'evaluate' for error_amp vs gf180-opamp with a decision record
- **Issue #381** (closed): Unit-test the sim rollup scripts (summarize.py / peak_analyze.py) against committed raw logs
- **Issue #383** (closed): README: Repository layout block omits signoff/, ratification/, docs/, reuse.lock.json
- **Issue #377** (closed): ci: adopt a correctness-only Python lint gate (ruff F+E9) in place of the no-op lint script
- **Issue #370** (closed): Dedupe gen_gds helpers: route divider and testcell through gen_gds_common.py
- **Issue #365** (closed): sim harness: records embed absolute host paths (home dirs, worktree paths) into public append-only evidence
- **Issue #371** (closed): ci: enforce sim/ append-only evidence rule at PR level (no modify/delete/rename of committed records)
- **Issue #362** (closed): Generate a status index for spec/decision-records (23 of 36 records are still 'proposed')
- **Issue #361** (closed): design/netlist.py --check is unwired and cannot distinguish a stale netlist from a different xschem build (pin: 3.4.7)
- **Issue #357** (closed): Auditor Capability Request: Python runtime missing on audit host
- **Issue #352** (closed): Investigate the gmin-stepping 'nonconvergence' diagnostic on the DR-0037 self-biased servo (possible zero-current operating point)

### 2026-10-07

- **PR #354**: sim(soft-start): explain 2x lower startup peak Icap with DR-0037 servo (#351)
- **PR #350**: design: VREF-forcing V-to-I servo replaces Fbias/Fss_ramp (#320) [partial: single-point verification]

### 2026-10-06

- **PR #343**: fix(sim/loop-stability): drop dead Xsoftstart.CLG nodeset from dc_seed_lines
- **Issue #307** (closed): sim(loop-stability): dc_seed_lines() seeds Xsoftstart.CLG, a node ldo_softstart no longer has (it is HG now)

### 2026-10-03

- **PR #342**: layout: make testcell gen_gds.py assertions audible via _fail()
- **Issue #296** (closed): layout: testcell's gen_gds.py assertions are silent — klayout -b -r swallows SystemExit

### 2026-10-02

- **PR #341**: spec: ratify DR-0026 per operator review, correct header (#261)
- **Issue #303** (closed): PR #267 / DR-0028's branch-supply gating costs 5-7 dB of PSRR at the two corners the ratified row already fails
- **Issue #261** (closed): process: PR #258 (DR-0026 proposal) merged without the loom:operator human-approval gate every prior DR-ratification PR received

### 2026-09-30

- **PR #340**: feat: let handover_t15.py grade an arbitrary --dut-netlist, gated on --no-write
- **PR #338**: spec: the soft-start branch standing current comes back at the ramp ceiling, not at the branches (DR-0036)
- **PR #297**: layout: draw the feedback divider, and make an inapplicable LVS negative control a hard error
- **PR #171**: fix(ratification): remove unwrapped private-repo reference from market-key/SKILL.md
- **Issue #339** (closed): sim harness: soft-start's hand-over and transient drivers have no --dut-netlist override, so an A/B of the injection element needs a dirty design/ tree
- **Issue #287** (closed): [Parent #173] Lay out the current-limit and soft-start blocks as DRC/LVS-clean cells
- **Issue #286** (closed): [Parent #173] Lay out the feedback divider, and give drclvs.py LVS negative controls that work on an all-passive cell

### 2026-09-25

- **PR #337**: layout(#335): align floorplan §8.3 to DR-0030's updated margin
- **PR #336**: layout(#333): dedupe _fail/_rd/_load_pdk_pcells/_label into gen_gds_common.py
- **PR #334**: docs: restate DR-0030's contact EM margin at the shipped 2.8 mm device
- **Issue #335** (closed): floorplan §8.3's 'DR-0030 still quotes 25.0 µA / 5.2×' note goes stale once #332 lands
- **Issue #333** (closed): Remove duplicate _fail/_rd/_load_pdk_pcells/_label helpers in passives and pass_array gen_gds.py
- **Issue #332** (closed): DR-0030's contact-layer margin (25.0 µA / 5.2×) is stated at the superseded 2 mm device

### 2026-09-24

- **PR #331**: layout(#330): floorplan §3 re-keyed to the shipped 70 µm unit, and its IR split replaced by the measured one
- **PR #329**: layout(#285): the pass array and its Msense replica, as one DRC/LVS-clean cell
- **PR #328**: sim: scope the compliance-sink guarantee in five sibling decks and gate the missing vout half
- **PR #326**: sim(#304): the compliance sink never had a root to delete at fs_125c_3.63v -- it is a false convergence, and the claims now say so
- **Issue #330** (closed): floorplan §3 still describes the superseded 50 µm unit cell, and its IR split is 3.3 mΩ optimistic against the as-drawn array
- **Issue #325** (closed): sim: five sibling decks still assert the unscoped compliance-sink guarantee #304 disproved
- **Issue #304** (closed): sim/psrr-vs-freq lands on the sub-ground DC root at fs_125c_3.63v -- the compliance-limited sink does not delete it under FB injection
- **Issue #285** (closed): [Parent #173] Lay out the pass-device array and its Msense replica as one DRC/LVS-clean cell

### 2026-09-23

- **PR #323**: spec: propose a VIN-referenced soft-start ramp ceiling (DR-0035)
- **PR #322**: sim(standalone benches): propagate #310's pseudo-transient op gate to run_point.sh
- **PR #321**: fix: render the PDK's lvs_format-less passives as primitive R/C so LVS can read them
- **PR #319**: fix: prefer the newest evidence record matching the current DUT
- **PR #318**: sim(harness): make the pseudo-transient op rung fatal for DC benches
- **PR #316**: spec: the < 200 mV dropout stretch unlocks on margin DR-0033 already delivered — pass device to 2.8 mm (DR-0034)
- **PR #315**: design(error_amp): fix stale rejected-variant phase margin in §6.14's cost/benefit table
- **PR #314**: sim(harness): record which DC continuation rung each PVT corner's op solved on
- **PR #306**: design: a poly resistor's flavour follows its DC-current duty (DR-0033) — Rz/Rza/Rbufb go ppolyf_u_3k, Rbias cannot, and 17% of the core-area budget comes back
- **PR #305**: sim: the ratified PSRR row fails on main -- bisected to the soft-start injection element's settled residual, and why no sizing lever closes it (DR-0031)
- **PR #299**: refactor: share one sha256_of() helper instead of three copies
- **PR #295**: spec: keep the pass device at 2 mm — the 200 mV dropout stretch is capped by DR-0018's ratified gain margin, not by area
- **Issue #317** (closed): sim(standalone benches): the shared run_point.sh driver lacks the pseudo-transient op gate #310 added to the harness
- **Issue #313** (closed): drclvs.py cannot netlist any cell with a passive: the PDK's resistor/MIM-cap xschem symbols have no lvs_format
- **Issue #311** (closed): quiescent-current's #301 DC seed inverts on the post-DR-0033 DUT: it now CREATES the pseudo-transient corner the unseeded deck no longer has
- **Issue #310** (closed): sim(harness): a pseudo-transient `op` fallback is recorded as a converged DC point — FATAL_LOG_PATTERNS does not catch it
- **Issue #309** (closed): sim: quiescent-current's head record lost its res_ff/res_ss corners in DR-0033's swap, and error_amp.md §6.14 cites the rejected variant's phase margin
- **Issue #301** (closed): sim(quiescent-current): the ss/-40C/2.97V corner lands on the non-regulating DC branch, so the Iq row's verdict depends on the Newton path rather than on Iq
- **Issue #300** (closed): bug: the ratified PSRR row fails at three corners on current main (29.4 dB at ff/125C/3.63V against a > 50 dB floor), hidden behind a STALE record
- **Issue #298** (closed): Remove duplicate sha256_of() in toolchain-portability: reuse a shared helper
- **Issue #294** (closed): Unlock the < 200 mV dropout stretch: it needs ~1.9 dB more gain margin at 50 mA / 1 uF / 500 mOhm, not a wider pass device
- **Issue #289** (closed): sim/psrr-vs-freq FAILS 3/45 corners on current main (worst 29.4 dB vs the ratified 50 dB row) while its committed record still reads PASS — a stale-record regression, likely from the soft-start series
- **Issue #279** (closed): The amplifier's ppolyf_u_1k serpentines are 24% of the core area budget; ppolyf_u_3k would recover ~16% of it at a wider corner spread on a steep stability frontier
- **Issue #139** (closed): Pass device ships at W = 2 mm, half the sizing DR-0004's spec review assumed — now measurable, and it costs the < 200 mV dropout stretch at 9/27 corners

### 2026-09-22

- **PR #283**: layout: make the DRC/LVS flow drive any registered cell, on any host
- **PR #282**: spec: derive the tech LEF EM unit convention and book the CON contact gap as DR-0030
- **PR #281**: fix: grade Stability against DR-0018's ratified envelope, not DR-0001's original matrix
- **PR #280**: layout: add the floorplan, matching plan and a re-derivable core-area estimate
- **PR #277**: sim: re-verify DR-0018's ratified stability envelope on the current design (630/630)
- **PR #275**: chore: resync installed Loom surfaces
- **PR #274**: 2am: add reuse.lock.json in_tree entry for error_amp vs gf180-opamp
- **Issue #278** (closed): Electromigration limits are not published in the open gf180mcu PDK, so the 50 mA power-path metal sizing rests on a stated placeholder
- **Issue #276** (closed): Characterization rollup grades Stability against DR-0001's original matrix, not the ratified DR-0018 envelope
- **Issue #272** (closed): 2am: reuse rule 9 — in-tree error amplifier duplicates sibling canary gf180-opamp — add reuse.lock.json in_tree entry (evaluate), then adopt or record
- **Issue #51** (closed): LDO loop stability: close the 1-50 mA phase-margin gap via DR-0012's Candidate 2 (adaptive pass-device-replica bias)
- **Issue #15** (closed): Floorplan and matching plan (pass array, sense matching, Kelvin sensing)

### 2026-09-20

- **PR #271**: signoff: grade this block's T1 state from a klt manifest instead of hand-reading it
- **Issue #270** (closed): Commit a klt signoff block manifest so this block's T1 state is graded, not hand-read

### 2026-09-19

- **PR #269**: spec: renumber the soft-start branch-gating negative result DR-0027 -> DR-0029
- **PR #266**: Remove duplicate load() in soft-start-loop-gain: reuse loop-stability's
- **PR #264**: spec: propose DR-0027, a negative/partial result on gating soft-start's degeneration branches
- **PR #263**: spec: DR-0025's wnflag facts reproduce on ngspice-42/47 (DR-0027)
- **PR #262**: sim: list soft-start-loop-gain in the rollup and fail on any unmapped slug
- **PR #260**: sim: waive grid-level spread checks on a grid too small to define a spread (#253)
- **Issue #268** (closed): DR-0027 numbering collision: two decision records both landed as DR-0027 (PR #263, PR #264)
- **Issue #265** (closed): Remove duplicate load() in soft-start-loop-gain/testbench/compare_records.py: reuse loop-stability's
- **Issue #257** (closed): sim: build_characterization_report.py leaves sim/soft-start-loop-gain unmapped — its records appear in neither the rollup nor the appendix
- **Issue #254** (closed): spec: revisit DR-0025's `wnflag` bin-pin validation on ngspice majors other than 46 (#221's un-performed scope)
- **Issue #253** (closed): sim: `selftest.sh --quick` always FAILs stage 3 on a spread check a single point cannot satisfy

### 2026-09-18

- **PR #258**: spec: propose DR-0026, make the soft-start injection accurate by local feedback rather than by scaling the divider
- **PR #256**: fix: render every bold clause of a split Overall verdict in the rollup
- **PR #255**: spec: ratify DR-0025's per-finger model-bin convention and deck-level wnflag pin
- **PR #252**: fix: make the ngspice identity check pin-aware, not brew-prefix-aware
- **PR #250**: soft-start: cascode the FB-injection mirror per DR-0023, with full PVT evidence (#246)
- **PR #228**: spec: propose ratifying DR-0024's 1 uF startup-current budget + 1.8 ms settling window
- **PR #217**: spec: propose ratifying DR-0023's cascoded soft-start injection mirror topology
- **Issue #251** (closed): sim: CHARACTERIZATION.md drops every FAIL clause of a record whose Overall verdict spans more than one bold run
- **Issue #249** (closed): spec: decide the R4 lever for the soft-start injection element's absolute accuracy (T1-T4 unreachable by cascoding alone)
- **Issue #248** (closed): sim: the ngspice toolchain-identity check is inverted once Homebrew moves past the pinned 46_1
- **Issue #247** (closed): sim: the ngspice toolchain-identity check is inverted once Homebrew moves past the pinned 46_1
- **Issue #246** (closed): Implement DR-0023's cascoded soft-start injection mirror (Mgmo_ss/Mgmr_ss) and re-run sim/soft-start
- **Issue #219** (closed): spec: propose ratifying DR-0025's per-finger model-bin convention and deck-level wnflag pin
- **Issue #191** (closed): Soft start: replace the idealized FB-injection source (Binj_ss) with a device-level transconductor
- **Issue #187** (closed): Soft-start: inrush and current-limit clearance still fail at the 4.7 uF end of DR-0001's capacitor window

### 2026-09-16

- **PR #245**: sim(startup): re-judge tb.json checks against DR-0006's ratified 6 ms bound
- **PR #244**: fix(sim/harness): catch undefined-vector .let/v(...) as fatal (#242)
- **PR #243**: fix(sim/soft-start-loop-gain): rewrite device/binj narrative as cap-resize A/B, retire has_gmsum
- **PR #241**: fix: widen merge-pr.sh closing-keyword regex for colon-adjacent form
- **PR #240**: fix(sim/soft-start-loop-gain): drop dead acopen-fb-inj/acshort-gmsum attribution rows (#234)
- **PR #238**: sim(startup): re-run full PVT against current main's DUT, confirm DR-0006's 6 ms bound holds
- **PR #236**: docs(sim/harness): document -j/--timeout override for Gear-integration benches
- **PR #233**: fix(soft-start): revert device-level FB transconductor to Binj_ss (issue #231)
- **Issue #242** (closed): sim/harness: run_ngspice_deck()'s FATAL_LOG_PATTERNS misses ngspice's "no such variable" wording
- **Issue #239** (closed): sim/soft-start-loop-gain: device/binj is now a DR-0024 cap-resize A/B, not an injection-element A/B (render_record narrative + hand-over GMSUM bug)
- **Issue #237** (closed): merge-pr.sh champion:hold-state pipefail fix (#224/#230) regressed via resync (64fe646)
- **Issue #235** (closed): merge-pr.sh's closing-keyword detector misses colon-adjacent `fix: #N` — false-close self-heal gap (recurred on #191)
- **Issue #234** (closed): sim/soft-start-loop-gain: acopen-fb-inj and acshort-gmsum no longer measure anything after #231's Binj_ss revert
- **Issue #232** (closed): sim/startup: default -j/--timeout causes mass CPU-contention timeouts on multi-core hosts
- **Issue #231** (closed): sim/startup regresses: ff/sf high-temp/voltage corners no longer settle within 6 ms (blocks #128)
- **Issue #220** (closed): sim: DR-0006's 6 ms startup bound may no longer hold — the post-#195/#197 DUT settles 1.455x slower than the netlist it was measured against
- **Issue #128** (closed): Re-run sim/startup with tb.json's checks at 6 ms once DR-0006 ratifies

### 2026-09-15

- **PR #230**: fix: guard unmatched grep -o in champion:hold-state staleness check (#224)
- **PR #229**: spec: mark DR-0022's clearance-at-1uF pass-count as stale
- **PR #226**: ci: run a pass-device-bearing corner in pvt-smoke (verify wnflag=1 on ngspice-42/47)
- **PR #225**: sim(soft-start): confirm DR-0024's resize is a no-op on Iq and loop-stability
- **PR #223**: spec: propose 1 uF startup-current budget + ~5x soft-start resize (DR-0024)
- **PR #222**: spec: pin gf180mcu model-bin selection in the deck and root-cause it (DR-0025)
- **PR #218**: sim: regenerate CHARACTERIZATION.md and add CI staleness check
- **PR #215**: spec: propose DR-0023, cascode the soft-start injection mirror
- **PR #199**: spec: propose ratifying DR-0018's narrowed Stability envelope (+ DR-0007 hold-condition note)
- **PR #137**: spec: propose ratifying DR-0005's 62-95 mA current-limit window
- **Issue #227** (closed): spec: DR-0022's clearance-at-1uF evidence is stale against issue #191's fresher regression data
- **Issue #224** (closed): merge-pr.sh silently exits 1 on every merge when no champion:hold-state comment exists (pipefail bug)
- **Issue #221** (closed): sim: verify the deck-level '.options wnflag=1' bin pin on ngspice-42 and ngspice-47 (only 46 is covered by DR-0025)
- **Issue #216** (closed): sim/CHARACTERIZATION.md is stale against main's own netlist — regenerate after the DR-0005/DR-0006 ratifications and re-point note references
- **Issue #214** (closed): ngspice model-bin resolution for XMpass (pfet_03v3, W=2000u/nf=40) is unverified and build-dependent; every large-W-device sim/ record may rest on an unpinned bin choice
- **Issue #198** (closed): Cut the DR-0018 ratification PR (narrow Stability envelope to 1 µF nominal + DR-0007 status update)
- **Issue #105** (closed): Operator decision: ratify, reject, or revise DR-0005 (current-limit window)

### 2026-09-14

- **PR #213**: refactor(sim): consolidate current-limit/enable-shutdown run_point() into a shared harness_run_pvt_point
- **PR #127**: spec: propose ratifying DR-0006's 6 ms startup settling window
- **Issue #211** (closed): Remove duplicate run_point() in current-limit/enable-shutdown run.sh: consolidate the PVT-point wrapper
- **Issue #106** (closed): Operator decision: ratify, reject, or revise DR-0006 (startup settling window)

### 2026-09-13

- **PR #210**: refactor: dedup ngspice run+validate logic into run_ngspice_deck()
- **PR #208**: Dedup PDK-discovery and corner_sections() codegen blocks across the four sim testbenches
- **PR #206**: Dedup parse_row_fields() between loop-stability and soft-start-loop-gain sweep.py
- **PR #205**: Dedup op-point-sanity's run_point(): reuse sim/harness/lib/run_point.sh
- **Issue #209** (closed): Dedup ngspice run+validate logic: shared helper for loop-stability and soft-start-loop-gain sweeps
- **Issue #207** (closed): Dedup PDK-discovery and corner_sections() codegen blocks across the four sim testbenches
- **Issue #204** (closed): ngspice 'could not find a valid modelname' on all four .include-based testbenches (current-limit, enable-shutdown, op-point-sanity, likely soft-start)
- **Issue #203** (closed): Dedup parse_row_fields() between loop-stability and soft-start-loop-gain sweep.py
- **Issue #202** (closed): Dedup op-point-sanity's run_point(): reuse sim/harness/lib/run_point.sh

### 2026-09-12

- **PR #201**: Remove unused import: re in soft-start-loop-gain selftest
- **Issue #200** (closed): Remove unused import: re in sim/soft-start-loop-gain/testbench/selftest.py

### 2026-09-10

- **PR #197**: sim: soft-start hand-over loop-gain characterization, and the compensation recommendation for #191
- **Issue #196** (closed): sim: small-signal loop-gain / phase-margin characterization of the soft-start hand-over state with the device-level FB-injection element in the loop — the compensation analysis #191's Builder asked for and nobody filed
