2AMLogic/gf180-ldo/sim/tests/test_build_characterization_report.py

#!/usr/bin/env python3
"""Unit tests for sim/build_characterization_report.py's verdict extraction.

    python3 -m unittest discover -s sim/tests -v

``sim/CHARACTERIZATION.md`` is regenerated from the committed records and
diffed in CI, but that diff cannot catch a *faithfulness* defect: the
generator is deterministic, so its output always matches whatever it last
produced regardless of whether the extracted verdict actually reflects the
record's own prose. These tests cover exactly that gap (issue #251): a
record that states one verdict as several bold runs separated by unbolded
prose must render every one of those clauses, not just the first.

No PDK, no ngspice, no network -- these read committed text only.
"""

from __future__ import annotations

import ast
import csv
import hashlib
import importlib.util
import json
import re
import shutil
import subprocess
import sys
import tempfile
import unittest
from pathlib import Path

SIM_DIR = Path(__file__).resolve().parents[1]
_REPORT_PATH = SIM_DIR / "build_characterization_report.py"
_spec = importlib.util.spec_from_file_location(
    "build_characterization_report", _REPORT_PATH
)
bcr = importlib.util.module_from_spec(_spec)
sys.modules["build_characterization_report"] = bcr
_spec.loader.exec_module(bcr)

# The pre-#251 extractor: one bold run per `**Overall...**`, terminated by
# the next `*`. Kept here as the regression oracle -- every verdict it finds
# must still be found, and must still be the *prefix* of what the current
# extractor renders for the same verdict, so no landed record's rendering is
# silently rewritten or dropped by a change to the grouping rules.
LEGACY_OVERALL_RE = re.compile(r"\*\*Overall[^*]*\*\*")

RECORDS = sorted((SIM_DIR).glob("*/records/*.md"))

# The record that surfaced #251 (soft-start, DR-0023 cascode, PR #250): its
# section 7 states four verdicts, each as several bold runs separated by
# unbolded prose.
MULTI_RUN_RECORD = SIM_DIR / "soft-start" / "records" / "20260918-190207-8a59d23.md"
# Its superseded predecessor states each verdict as one contiguous bold run.
SINGLE_RUN_RECORD = SIM_DIR / "soft-start" / "records" / "20260915-103035-18f664f.md"


class TestMultiBoldRunVerdicts(unittest.TestCase):
    """A verdict split across several bold runs renders every clause."""

    FIXTURE = """## 7. Overall verdicts

**Overall (Startup, ratified row, DR-0006): FAIL on ramp rate** (163/163
points exceed the bound) **and FAIL on inrush and current-limit clearance**
(0/83 and 2/83 at C_eff = 1 uF).
**PASS on the ratified <= 6 ms settling clause at 163/163** (worst 1.28 ms).

**Overall (DR-0024 proposed bounds, not yet ratified): PASS on ramp
rate** and **FAIL on inrush, current-limit clearance, monotonicity**, all
for the reason section 3 measures.

## 8. Next
"""

    def test_every_bold_clause_of_a_split_verdict_is_captured(self):
        snippets = bcr.extract_verdict_snippets(self.FIXTURE, None)
        self.assertEqual(len(snippets), 2, snippets)
        self.assertIn("FAIL on ramp rate", snippets[0])
        self.assertIn("and FAIL on inrush and current-limit clearance", snippets[0])
        self.assertIn("PASS on the ratified <= 6 ms settling clause", snippets[0])
        self.assertIn("PASS on ramp rate", snippets[1])
        self.assertIn(
            "FAIL on inrush, current-limit clearance, monotonicity", snippets[1]
        )

    def test_unbolded_prose_between_clauses_is_not_rendered_as_verdict(self):
        snippets = bcr.extract_verdict_snippets(self.FIXTURE, None)
        self.assertNotIn("points exceed the bound", snippets[0])
        self.assertNotIn("worst 1.28 ms", snippets[0])

    def test_split_verdict_classifies_as_mixed(self):
        snippets = bcr.extract_verdict_snippets(self.FIXTURE, None)
        self.assertEqual(bcr.classify(snippets), "MIXED")

    def test_a_blank_line_ends_a_verdict_statement(self):
        text = "**Overall: PASS** on everything.\n\n**Note**: unrelated bold run.\n"
        snippets = bcr.extract_verdict_snippets(text, None)
        self.assertEqual(snippets, ["Overall: PASS"])

    def test_a_sibling_list_item_ends_a_verdict_statement(self):
        text = (
            "- **Overall (current limit, ratified window): FAIL** - 36/63\n"
            "  corners outside the window, **and FAIL at 125 C**.\n"
            "- **Links**:\n"
            "  - Testbench: `sim/current-limit/testbench/tb.json`\n"
        )
        snippets = bcr.extract_verdict_snippets(text, None)
        self.assertEqual(len(snippets), 1, snippets)
        self.assertIn("Overall (current limit, ratified window): FAIL", snippets[0])
        self.assertIn("and FAIL at 125 C", snippets[0])
        self.assertNotIn("Links", snippets[0])

    def test_prose_emphasis_after_the_opener_is_not_a_verdict_clause(self):
        text = (
            "**Overall (the §4 experiment): conclusive.** The A/B moves the "
            "peak by -9.0%, ruling the ramp node **out** as the mechanism.\n"
        )
        self.assertEqual(
            bcr.extract_verdict_snippets(text, None),
            ["Overall (the §4 experiment): conclusive."],
        )

    def test_a_second_overall_opener_starts_a_new_verdict(self):
        text = (
            "**Overall (a): PASS** because of x, **and PASS on y**. "
            "**Overall (b): FAIL** because of z.\n"
        )
        snippets = bcr.extract_verdict_snippets(text, None)
        self.assertEqual(len(snippets), 2, snippets)
        self.assertIn("and PASS on y", snippets[0])
        self.assertNotIn("Overall (b)", snippets[0])
        self.assertIn("Overall (b): FAIL", snippets[1])


class TestLandedRecordRendering(unittest.TestCase):
    """Against the real, append-only records committed under sim/."""

    def test_the_record_that_surfaced_251_renders_its_dropped_clauses(self):
        text = MULTI_RUN_RECORD.read_text()
        rendered = " / ".join(bcr.extract_verdict_snippets(text, None))
        for clause in (
            "FAIL on inrush and current-limit clearance",
            "FAIL on inrush, current-limit clearance, monotonicity and peak",
            "T1, T2, T3 and T4 FAIL",
            "PASS on the ratified",
        ):
            self.assertIn(clause, rendered)
        # ... and its §4 verdict does not pick up the "ruling the ramp node
        # **out**" emphasis run that follows it in the same paragraph.
        self.assertTrue(
            rendered.endswith("§4 experiment): conclusive."), rendered
        )

    def test_superseded_single_run_record_renders_byte_identically(self):
        text = SINGLE_RUN_RECORD.read_text()
        legacy = [
            bcr._clean(m) for m in LEGACY_OVERALL_RE.findall(text)
        ]
        self.assertTrue(legacy, "oracle found no verdicts in the fixture record")
        self.assertEqual(bcr.extract_verdict_snippets(text, None), legacy)

    def test_no_landed_record_loses_or_rewrites_a_verdict(self):
        """Corpus-wide invariant against every committed record.

        For each record: the same number of `**Overall...**` verdicts as the
        pre-#251 extractor found, each rendered snippet starting with exactly
        the text that extractor produced. Records that stated a verdict as a
        single bold run therefore render byte-identically; the only permitted
        change is extra clauses appended to a verdict that was split.
        """
        self.assertGreater(len(RECORDS), 50, "record corpus not found")
        for record in RECORDS:
            text = record.read_text()
            legacy = [bcr._clean(m) for m in LEGACY_OVERALL_RE.findall(text)]
            if not legacy:
                continue
            with self.subTest(record=str(record.relative_to(SIM_DIR.parent))):
                current = bcr.extract_verdict_snippets(text, None)
                self.assertEqual(len(current), len(legacy))
                for now, before in zip(current, legacy):
                    self.assertTrue(
                        now.startswith(before),
                        f"verdict rewritten:\n  was: {before!r}\n  now: {now!r}",
                    )


class TestKeywordFilterAndFallback(unittest.TestCase):
    def test_keyword_still_selects_one_sub_claim(self):
        text = (
            "- **Overall (current limit, ratified 65-80 mA window): FAIL** - 36/63\n"
            "  corners outside the window.\n"
            "- **Overall (thermal, ratified <= 290 mW into a short): FAIL** -\n"
            "  worst-case 345.2 mW.\n"
        )
        cl = bcr.extract_verdict_snippets(text, "current limit")
        th = bcr.extract_verdict_snippets(text, "thermal")
        self.assertEqual(len(cl), 1, cl)
        self.assertEqual(len(th), 1, th)
        self.assertIn("current limit", cl[0])
        self.assertIn("thermal", th[0])
        self.assertNotIn("thermal", cl[0])
        self.assertNotIn("65-80 mA", th[0])

    def test_result_heading_fallback_for_records_without_an_overall_span(self):
        text = "# Record\n\n## Result: PASS\n\nSome prose.\n"
        self.assertEqual(bcr.extract_verdict_snippets(text, None), ["Result: PASS"])
        self.assertEqual(
            bcr.extract_verdict_snippets(text, "thermal"), ["Result: PASS"]
        )

    def test_a_record_with_no_verdict_at_all_is_unknown(self):
        self.assertEqual(bcr.extract_verdict_snippets("nothing here\n", None), [])
        self.assertEqual(bcr.classify([]), "UNKNOWN")


class TestUnmappedSlugCoverage(unittest.TestCase):
    """Every sim/<slug>/records/ directory reaches the rollup (issue #257).

    The rollup is only "the single file tying every row to its evidence" if
    an experiment cannot exist under sim/ without appearing in it. Before
    #257 an unmapped slug produced a stderr-only warning and exit 0, so
    `sim/soft-start-loop-gain/` -- real committed evidence -- appeared in
    neither the row table nor the appendix and CI (which diffs stdout only)
    stayed green.
    """

    def test_the_committed_tree_has_no_unmapped_slug(self):
        self.assertEqual(
            bcr.unmapped_slugs(),
            [],
            "a sim/<slug>/records/ directory reaches neither a ROWS entry "
            "nor SUPPORTING_SLUGS_NOTE -- map it before committing",
        )

    def test_soft_start_loop_gain_reaches_the_rendered_appendix(self):
        self.assertIn("soft-start-loop-gain", bcr.SUPPORTING_SLUGS_NOTE)
        self.assertIn("| `soft-start-loop-gain` |", bcr.render())

    def _run_generator(self) -> subprocess.CompletedProcess:
        return subprocess.run(
            [sys.executable, str(_REPORT_PATH)],
            capture_output=True,
            text=True,
            check=False,
        )

    def test_an_unmapped_slug_makes_the_generator_exit_non_zero(self):
        """End-to-end against the real script, via a synthetic slug.

        Asserted through a subprocess rather than by calling main() so the
        exit status CI actually observes is the thing under test.
        """
        scratch = Path(
            tempfile.mkdtemp(prefix="zz-unmapped-selftest-", dir=SIM_DIR)
        )
        try:
            (scratch / "records").mkdir()
            (scratch / "records" / "20260101-000000-0000000.md").write_text(
                "# synthetic record\n\n**Overall: PASS**\n"
            )
            self.assertIn(scratch.name, bcr.unmapped_slugs())

            done = self._run_generator()
            self.assertNotEqual(
                done.returncode, 0, "unmapped slug did not fail the generator"
            )
            self.assertIn(scratch.name, done.stderr)
            # The report is still emitted, so regenerating into the committed
            # file does not truncate it -- the failure is the exit status.
            self.assertTrue(
                done.stdout.startswith("# Characterization report"), done.stdout[:200]
            )
        finally:
            shutil.rmtree(scratch)

    def test_the_generator_exits_zero_on_the_committed_tree(self):
        done = self._run_generator()
        self.assertEqual(done.returncode, 0, done.stderr)
        self.assertEqual(done.stderr, "")


class TestClassify(unittest.TestCase):
    def test_pass_fail_mixed_unknown(self):
        self.assertEqual(bcr.classify(["Overall: PASS"]), "PASS")
        self.assertEqual(bcr.classify(["Overall: FAIL"]), "FAIL")
        self.assertEqual(bcr.classify(["Overall: PASS", "Overall: FAIL"]), "MIXED")
        self.assertEqual(bcr.classify(["Overall: PASS … and FAIL on x"]), "MIXED")
        self.assertEqual(bcr.classify(["Overall: conclusive"]), "UNKNOWN")


_MATRIX_FIELDS = [
    "corner_id",
    "process",
    "temp_c",
    "vin_v",
    "iload_ma",
    "ceff_uf",
    "esr_ohm",
    "vout_v",
    "dc_loop_gain_db",
    "f_crossover_hz",
    "phase_margin_deg",
    "f_180_hz",
    "gain_margin_db",
    "result",
    "resurgence_db",
    "resurgence_result",
]


def _matrix_row(
    iload_ma,
    ceff_uf,
    esr_ohm,
    result,
    pm=60.0,
    gm=20.0,
    resurgence_result="PASS",
    process="tt",
    temp_c="27",
    vin_v="3.30",
):
    return {
        "corner_id": f"{process}_{temp_c}c_{vin_v}v",
        "process": process,
        "temp_c": str(temp_c),
        "vin_v": str(vin_v),
        "iload_ma": str(iload_ma),
        "ceff_uf": str(ceff_uf),
        "esr_ohm": str(esr_ohm),
        "vout_v": "1.8",
        "dc_loop_gain_db": "80",
        "f_crossover_hz": "1000",
        "phase_margin_deg": str(pm),
        "f_180_hz": "2000",
        "gain_margin_db": str(gm),
        "result": result,
        "resurgence_db": "-1.0",
        "resurgence_result": resurgence_result,
    }


def _full_envelope_rows(result="PASS") -> list[dict]:
    """One row per required DR-0018 coordinate (630), straight from the axes."""
    return [
        _matrix_row(i, c, e, result, process=p, temp_c=f"{t:g}", vin_v=f"{v:g}")
        for p in bcr.DR0018_PROCESSES
        for t in bcr.DR0018_TEMPS_C
        for v in bcr.DR0018_SUPPLIES_V
        for i in bcr.DR0018_LOADS_MA
        for c in bcr.DR0018_CEFF_UF
        for e in bcr.DR0018_ESRS_OHM
    ]


class _EnvelopeFixture:
    """A scratch record + companion ``-matrix.csv`` under a tempdir, in the
    exact layout ``envelope_verdict()`` reads: ``<stem>.md`` next to
    ``<stem>-matrix.csv`` under a single ``records/`` directory.
    """

    def __init__(self, tmpdir: Path, rows: list[dict], overall: str = "PASS"):
        self.dir = tmpdir / "records"
        self.dir.mkdir(parents=True, exist_ok=True)
        self.record = self.dir / "20260101-000000-0000000.md"
        self.record.write_text(f"# Fixture record\n\n**Overall: {overall}**\n")
        csv_path = self.dir / "20260101-000000-0000000-matrix.csv"
        with csv_path.open("w", newline="") as f:
            writer = csv.DictWriter(f, fieldnames=_MATRIX_FIELDS)
            writer.writeheader()
            for row in rows:
                writer.writerow(row)


class TestEnvelopeVerdict(unittest.TestCase):
    """``envelope_verdict()`` grades a record from its own ``-matrix.csv``
    subset, not from the record's top-level prose verdict (issue #276).
    """

    def setUp(self):
        self._tmp = tempfile.TemporaryDirectory()
        self.addCleanup(self._tmp.cleanup)
        self.tmpdir = Path(self._tmp.name)

    def test_envelope_passes_when_every_required_point_is_present_and_passes(self):
        rows = _full_envelope_rows() + [
            # Outside the envelope (0.33 uF) and FAILing -- must not affect
            # the envelope verdict, only the full-matrix count below.
            _matrix_row(50, 0.33, 0.001, "FAIL"),
        ]
        fixture = _EnvelopeFixture(self.tmpdir, rows, overall="PASS")
        env = bcr.envelope_verdict(fixture.record, bcr.DR0018_STABILITY_ENVELOPE)
        self.assertEqual(env["verdict"], "PASS")
        self.assertEqual(env["n_pass"], 630)
        self.assertEqual(env["n_total"], 630)
        self.assertEqual(env["n_pass_full"], 630)
        self.assertEqual(env["n_total_full"], 631)
        self.assertEqual(env["coverage"]["n_covered"], 630)
        self.assertTrue(env["coverage"]["complete"])

    def test_two_passing_points_no_longer_establish_the_whole_row(self):
        """Issue #410: the former positive fixture (two passing points at
        tt / 27 C / 3.30 V) is a diagnostic subset, not the 630-point row."""
        rows = [
            _matrix_row(0.1, 1.0, 0.2, "PASS"),
            _matrix_row(50, 1.0, 0.5, "PASS"),
            _matrix_row(50, 0.33, 0.001, "FAIL"),
        ]
        fixture = _EnvelopeFixture(self.tmpdir, rows, overall="PASS")
        env = bcr.envelope_verdict(fixture.record, bcr.DR0018_STABILITY_ENVELOPE)
        self.assertEqual(env["verdict"], "UNKNOWN")
        self.assertEqual(env["n_pass"], 2)
        self.assertEqual(env["n_total"], 2)
        self.assertEqual(env["n_total_full"], 3)
        self.assertEqual(env["coverage"]["n_covered"], 2)
        self.assertEqual(env["coverage"]["n_required"], 630)
        snippet = bcr._render_envelope_snippet(env, bcr.DR0018_STABILITY_ENVELOPE)
        self.assertIn("incomplete coverage", snippet)
        self.assertIn("2/630", snippet)
        self.assertIn("2/2 points passing", snippet)

    def test_single_passing_point_is_unknown(self):
        fixture = _EnvelopeFixture(self.tmpdir, [_matrix_row(1, 1.0, 0.5, "PASS")])
        env = bcr.envelope_verdict(fixture.record, bcr.DR0018_STABILITY_ENVELOPE)
        self.assertEqual(env["verdict"], "UNKNOWN")

    def test_one_point_repeated_630_times_cannot_fill_the_matrix(self):
        rows = [_matrix_row(1, 1.0, 0.5, "PASS") for _ in range(630)]
        fixture = _EnvelopeFixture(self.tmpdir, rows)
        env = bcr.envelope_verdict(fixture.record, bcr.DR0018_STABILITY_ENVELOPE)
        self.assertEqual(env["verdict"], "UNKNOWN")
        self.assertEqual(env["n_total"], 630)
        self.assertEqual(env["coverage"]["n_covered"], 1)
        self.assertEqual(env["coverage"]["n_duplicate_rows"], 629)
        snippet = bcr._render_envelope_snippet(env, bcr.DR0018_STABILITY_ENVELOPE)
        self.assertIn("629 duplicate rows", snippet)

    def test_legacy_number_formatting_normalizes_to_the_same_slot(self):
        rows = _full_envelope_rows()
        for r in rows:
            r["vin_v"] = f"{float(r['vin_v']):.2f}"
            r["temp_c"] = f"{float(r['temp_c']):.1f}"
            r["esr_ohm"] = f"{float(r['esr_ohm']):.3f}"
            r["process"] = r["process"].upper()
        fixture = _EnvelopeFixture(self.tmpdir, rows)
        env = bcr.envelope_verdict(fixture.record, bcr.DR0018_STABILITY_ENVELOPE)
        self.assertEqual(env["verdict"], "PASS")

    def _assert_missing(self, predicate, n_missing):
        rows = [r for r in _full_envelope_rows() if not predicate(r)]
        fixture = _EnvelopeFixture(self.tmpdir, rows)
        env = bcr.envelope_verdict(fixture.record, bcr.DR0018_STABILITY_ENVELOPE)
        self.assertEqual(env["verdict"], "UNKNOWN")
        self.assertEqual(env["coverage"]["n_missing"], n_missing)
        self.assertEqual(env["coverage"]["n_covered"], 630 - n_missing)

    def test_missing_process_corner_prevents_pass(self):
        self._assert_missing(lambda r: r["process"] == "res_ss", 90)

    def test_missing_temperature_prevents_pass(self):
        self._assert_missing(lambda r: r["temp_c"] == "125", 210)

    def test_missing_supply_prevents_pass(self):
        self._assert_missing(lambda r: r["vin_v"] == "2.97", 210)

    def test_missing_load_prevents_pass(self):
        self._assert_missing(lambda r: r["iload_ma"] == "0.1", 126)

    def test_missing_esr_prevents_pass(self):
        self._assert_missing(lambda r: r["esr_ohm"] == "0.5", 315)

    def test_malformed_coordinates_never_fill_a_slot_or_pass(self):
        rows = _full_envelope_rows()
        victim = rows.pop()
        bad = dict(victim, vin_v="not-a-number")
        blank = dict(victim, process="")
        fixture = _EnvelopeFixture(self.tmpdir, rows + [bad, blank])
        env = bcr.envelope_verdict(fixture.record, bcr.DR0018_STABILITY_ENVELOPE)
        self.assertEqual(env["verdict"], "UNKNOWN")
        self.assertEqual(env["coverage"]["n_missing"], 1)
        self.assertGreaterEqual(env["coverage"]["n_malformed"], 2)

    def test_malformed_row_alongside_complete_coverage_blocks_pass(self):
        rows = _full_envelope_rows()
        rows.append(dict(rows[0], process=""))
        fixture = _EnvelopeFixture(self.tmpdir, rows)
        env = bcr.envelope_verdict(fixture.record, bcr.DR0018_STABILITY_ENVELOPE)
        self.assertEqual(env["verdict"], "UNKNOWN")
        self.assertEqual(env["coverage"]["n_missing"], 0)

    def test_partial_matrix_with_in_envelope_failure_is_fail_with_coverage(self):
        rows = [
            _matrix_row(1, 1.0, 0.5, "PASS"),
            _matrix_row(25, 1.0, 0.5, "FAIL", pm=10.0, gm=1.0),
        ]
        fixture = _EnvelopeFixture(self.tmpdir, rows)
        env = bcr.envelope_verdict(fixture.record, bcr.DR0018_STABILITY_ENVELOPE)
        self.assertEqual(env["verdict"], "FAIL")
        self.assertEqual(env["coverage"]["n_covered"], 2)
        snippet = bcr._render_envelope_snippet(env, bcr.DR0018_STABILITY_ENVELOPE)
        self.assertIn("**FAIL**", snippet)
        self.assertIn("incomplete coverage", snippet)

    def test_complete_matrix_with_one_failure_or_resurgence_flag_still_fails(self):
        rows = _full_envelope_rows()
        rows[5]["resurgence_result"] = "FAIL"
        fixture = _EnvelopeFixture(self.tmpdir, rows)
        env = bcr.envelope_verdict(fixture.record, bcr.DR0018_STABILITY_ENVELOPE)
        self.assertEqual(env["verdict"], "FAIL")
        self.assertTrue(env["coverage"]["complete"])

    def test_out_of_envelope_failures_stay_disclosed_not_graded_on_a_complete_matrix(self):
        rows = _full_envelope_rows() + [_matrix_row(0, 0.33, 0.001, "FAIL")]
        fixture = _EnvelopeFixture(self.tmpdir, rows)
        env = bcr.envelope_verdict(fixture.record, bcr.DR0018_STABILITY_ENVELOPE)
        self.assertEqual(env["verdict"], "PASS")
        snippet = bcr._render_envelope_snippet(env, bcr.DR0018_STABILITY_ENVELOPE)
        self.assertIn("630/631 passing", snippet)

    def test_required_axes_match_the_sweep_definitions_and_dr0018_accounting(self):
        src = (SIM_DIR / "loop-stability" / "testbench" / "sweep.py").read_text()

        def tup(name):
            m = re.search(rf"^{name}\s*=\s*\(([^)]*)\)", src, re.MULTILINE)
            return [eval(x.strip()) for x in m.group(1).split(",") if x.strip()]

        self.assertEqual(tuple(tup("PROCESS_CORNERS")), bcr.DR0018_PROCESSES)
        self.assertEqual(tuple(tup("TEMPS_C")), bcr.DR0018_TEMPS_C)
        loads = tuple(round(v * 1e3, 6) for v in tup("ILOADS_A") if v > 0)
        self.assertEqual(loads, bcr.DR0018_LOADS_MA)
        esrs = tuple(v for v in tup("ESRS_OHM") if v >= 0.2)
        self.assertEqual(esrs, bcr.DR0018_ESRS_OHM)
        nominal = float(re.search(r"^NOMINAL_SUPPLY_V\s*=\s*([\d.]+)", src, re.M).group(1))
        tol = float(re.search(r"^SUPPLY_TOL\s*=\s*([\d.]+)", src, re.M).group(1))
        self.assertEqual(
            tuple(round(nominal * k, 2) for k in (1 - tol, 1.0, 1 + tol)),
            bcr.DR0018_SUPPLIES_V,
        )
        self.assertEqual(len(bcr.DR0018_STABILITY_ENVELOPE.required_coords), 630)

    def test_a_failing_point_inside_the_envelope_fails_the_row_even_when_the_records_own_prose_says_pass(self):
        """The core case the issue's Acceptance Criteria calls out: a point
        *inside* the ratified envelope fails, so the row must go FAIL --
        proving the filter drives the outcome, not the record's own
        top-level prose verdict.
        """
        rows = [
            _matrix_row(0.1, 1.0, 0.2, "PASS"),
            # Inside the envelope (1 uF, 0.5 ohm, 25 mA) and FAILing.
            _matrix_row(25, 1.0, 0.5, "FAIL", pm=10.0, gm=1.0),
        ]
        fixture = _EnvelopeFixture(self.tmpdir, rows, overall="PASS")

        # The record's own prose verdict (what the old extractor used) says
        # PASS -- confirm that channel still reads PASS, to prove the two
        # disagree and it is the envelope filter, not the prose, that wins.
        prose_snippets = bcr.extract_verdict_snippets(fixture.record.read_text(), None)
        self.assertEqual(bcr.classify(prose_snippets), "PASS")

        env = bcr.envelope_verdict(fixture.record, bcr.DR0018_STABILITY_ENVELOPE)
        self.assertEqual(env["verdict"], "FAIL")
        self.assertEqual(env["n_pass"], 1)
        self.assertEqual(env["n_total"], 2)

    def test_a_resurgence_flag_inside_the_envelope_fails_the_row_even_if_the_margin_result_column_passes(self):
        rows = [
            _matrix_row(10, 1.0, 0.2, "PASS", resurgence_result="FAIL"),
        ]
        fixture = _EnvelopeFixture(self.tmpdir, rows, overall="PASS")
        env = bcr.envelope_verdict(fixture.record, bcr.DR0018_STABILITY_ENVELOPE)
        self.assertEqual(env["verdict"], "FAIL")
        self.assertEqual(env["n_resurge_flagged"], 1)

    def test_no_matrix_csv_is_unknown_not_a_crash(self):
        records_dir = self.tmpdir / "records"
        records_dir.mkdir()
        record = records_dir / "20260101-000000-0000000.md"
        record.write_text("# Fixture record\n\n**Overall: PASS**\n")
        env = bcr.envelope_verdict(record, bcr.DR0018_STABILITY_ENVELOPE)
        self.assertEqual(env, {"available": False, "verdict": "UNKNOWN"})

    def test_no_point_inside_the_envelope_is_unknown(self):
        rows = [_matrix_row(50, 0.33, 0.001, "FAIL")]  # all outside the envelope
        fixture = _EnvelopeFixture(self.tmpdir, rows, overall="FAIL")
        env = bcr.envelope_verdict(fixture.record, bcr.DR0018_STABILITY_ENVELOPE)
        self.assertEqual(env["verdict"], "UNKNOWN")
        self.assertEqual(env["n_total"], 0)
        self.assertEqual(env["n_total_full"], 1)

    def test_rendered_snippet_names_the_decision_record_and_shows_the_full_matrix_count(self):
        rows = _full_envelope_rows()
        rows[0]["phase_margin_deg"] = "55.0"
        rows[0]["gain_margin_db"] = "12.0"
        rows.append(_matrix_row(50, 0.33, 0.001, "FAIL"))
        fixture = _EnvelopeFixture(self.tmpdir, rows, overall="PASS")
        env = bcr.envelope_verdict(fixture.record, bcr.DR0018_STABILITY_ENVELOPE)
        snippet = bcr._render_envelope_snippet(env, bcr.DR0018_STABILITY_ENVELOPE)
        self.assertIn("DR-0018", snippet)
        self.assertIn("**PASS**", snippet)
        self.assertIn("630/630", snippet)
        # The wider-matrix result must stay visible alongside the envelope
        # verdict, not be dropped (issue #276 acceptance criteria).
        self.assertIn("630/631 passing", snippet)


class TestStabilityRowUsesEnvelopeVerdict(unittest.TestCase):
    """End-to-end against the real committed head record (issue #276): the
    rendered Stability row must grade against DR-0018's ratified envelope,
    not DR-0001's original full matrix, while still showing the full-matrix
    result.
    """

    def test_stability_row_is_defined_with_the_dr0018_envelope(self):
        stability = next(r for r in bcr.ROWS if r.name == "Stability")
        self.assertEqual(len(stability.sources), 1)
        self.assertIs(stability.sources[0].envelope, bcr.DR0018_STABILITY_ENVELOPE)

    def test_rendered_report_shows_the_ratified_envelope_verdict_and_the_full_matrix_count(self):
        report = bcr.render()
        # The verdict column is what issue #276 is about: graded against
        # DR-0018's envelope it must read PASS. The freshness column is a
        # separate fact -- whether the head loop-stability record's frozen
        # snapshot still contains the committed ldo_core netlist -- and is
        # checked here against that fact directly rather than pinned to
        # "fresh" (issue #320): pinning it made this rendering test fail on
        # every DUT change, and the only way to make it pass again without
        # a re-run would be to report a STALE record as fresh. When the DUT
        # has moved past the record the row must say STALE, never fresh.
        _record, snapshot = bcr.latest_substantive_record("loop-stability")
        self.assertIsNotNone(snapshot)
        dut = (bcr.REPO_ROOT / "design" / "netlist" / "ldo_core.spice").read_bytes()
        expected_fresh = "fresh" if dut in snapshot.read_bytes() else "STALE"
        self.assertIn(f"| Stability | PASS | {expected_fresh} |", report)
        stability_section = report.split("### Stability")[1].split("###")[0]
        self.assertIn("DR-0018", stability_section)
        self.assertIn("630/630", stability_section)
        # Tracks whichever loop-stability record is currently head, so it moves
        # with the design: 2974/4536 at the 2 mm pass device, 2790/4536 since
        # issue #294 / DR-0034 widened it to 2.8 mm (the wider DR-0001 window
        # is outside DR-0018's ratified envelope and is not graded here).
        self.assertIn("2790/4536", stability_section)


class TestLatestSubstantiveRecordPrefersCurrentDut(unittest.TestCase):
    """Record selection is freshness-first, not recency-only (issue #311).

    Record ids are minted when a branch *runs* its bench, not when it
    merges, so a branch that measures against the DUT it started from can
    land a record that is simultaneously the newest by id and a measurement
    of a DUT `main` has since replaced. Selected on recency alone that
    record downgrades its row from fresh to stale even though a record
    matching the current DUT is sitting in the same directory -- what
    #308's `20260923-093349-7674ddf` (pre-DR-0033) would have done to
    `20260923-005938-b62ac83` (post-swap) on the Iq row.

    Synthetic trees only: `bcr.SIM_DIR` and `bcr.DUT_CANDIDATES` are
    repointed at a tempdir so these assert the selection *rule*, not
    whichever records happen to be committed today.
    """

    SLUG = "zz-selection-fixture"
    CURRENT_DUT = ".subckt ldo_core vin vout\nRz n1 n2 1k ppolyf_u_3k\n.ends\n"
    PRE_SWAP_DUT = ".subckt ldo_core vin vout\nRz n1 n2 1k ppolyf_u_1k\n.ends\n"

    def setUp(self):
        self._tmp = tempfile.TemporaryDirectory()
        self.addCleanup(self._tmp.cleanup)
        root = Path(self._tmp.name)
        self.records_dir = root / self.SLUG / "records"
        self.snapshots_dir = root / self.SLUG / "netlist-snapshots"
        self.records_dir.mkdir(parents=True)
        self.snapshots_dir.mkdir(parents=True)

        dut = root / "design" / "netlist" / "ldo_core.spice"
        dut.parent.mkdir(parents=True)
        dut.write_text(self.CURRENT_DUT)

        for name, value in (
            ("SIM_DIR", root),
            ("DUT_CANDIDATES", {"ldo_core": dut}),
            ("DUT_BY_SLUG", {self.SLUG: "ldo_core"}),
        ):
            original = getattr(bcr, name)
            setattr(bcr, name, value)
            self.addCleanup(setattr, bcr, name, original)

    def _add_record(self, record_id: str, snapshot_of: str | None = None) -> None:
        """A record, plus (optionally) its frozen netlist snapshot.

        `snapshot_of=None` is the metadata-only correction record case: a
        record with no snapshot of its own, which is not a measurement and
        must never be selected over one that is.
        """
        (self.records_dir / f"{record_id}.md").write_text(
            f"# {record_id}\n\n**Overall: PASS**\n"
        )
        if snapshot_of is not None:
            (self.snapshots_dir / f"{record_id}.spice").write_text(
                f"* frozen DUT snapshot for {record_id}\n{snapshot_of}"
            )

    def _selected_id(self) -> str | None:
        record, _snapshot = bcr.latest_substantive_record(self.SLUG)
        return None if record is None else record.stem

    def test_a_newer_stale_record_does_not_outrank_an_older_fresh_one(self):
        """The #311 regression: stale-latest vs. fresh-earlier."""
        self._add_record("20260923-005938-b62ac83", self.CURRENT_DUT)
        self._add_record("20260923-093349-7674ddf", self.PRE_SWAP_DUT)

        record, snapshot = bcr.latest_substantive_record(self.SLUG)
        self.assertEqual(record.stem, "20260923-005938-b62ac83")
        # ...and the row therefore reports fresh, which is the whole point:
        # the false downgrade was the observable defect.
        self.assertEqual(bcr.freshness(snapshot, "ldo_core"), ("fresh", "ldo_core", None))

    def test_the_newest_record_still_wins_when_it_matches_the_current_dut(self):
        """Recency is still the tiebreak among records that do match."""
        self._add_record("20260923-005938-b62ac83", self.CURRENT_DUT)
        self._add_record("20260923-125526-8225d5d", self.CURRENT_DUT)
        self.assertEqual(self._selected_id(), "20260923-125526-8225d5d")

    def test_a_newer_snapshotless_record_is_still_skipped(self):
        """Unchanged: a correction record is not a measurement."""
        self._add_record("20260923-005938-b62ac83", self.CURRENT_DUT)
        self._add_record("20260923-201500-deadbee", snapshot_of=None)
        self.assertEqual(self._selected_id(), "20260923-005938-b62ac83")

    def test_no_matching_snapshot_falls_back_to_the_newest_snapshotted_record(self):
        """Edge case: a genuinely stale row still reports as stale, citing
        its newest evidence -- the pre-#311 behaviour, unchanged.
        """
        self._add_record("20260801-003015-b64d60e", self.PRE_SWAP_DUT)
        self._add_record("20260923-093349-7674ddf", self.PRE_SWAP_DUT)

        record, snapshot = bcr.latest_substantive_record(self.SLUG)
        self.assertEqual(record.stem, "20260923-093349-7674ddf")
        self.assertEqual(bcr.freshness(snapshot, "ldo_core"), ("stale", None, None))

    def test_no_snapshots_at_all_falls_back_to_the_newest_record(self):
        self._add_record("20260801-003015-b64d60e", snapshot_of=None)
        self._add_record("20260923-093349-7674ddf", snapshot_of=None)

        record, snapshot = bcr.latest_substantive_record(self.SLUG)
        self.assertEqual(record.stem, "20260923-093349-7674ddf")
        self.assertIsNone(snapshot)

    def _write_matrix(self, record_id: str, rows: list[dict]) -> None:
        with (self.records_dir / f"{record_id}-matrix.csv").open("w", newline="") as f:
            writer = csv.DictWriter(f, fieldnames=_MATRIX_FIELDS)
            writer.writeheader()
            writer.writerows(rows)

    def test_a_newly_selected_partial_record_cannot_render_a_current_full_row_pass(self):
        """Issue #410: freshness-first selection keeps choosing the newest
        record that matches the current DUT, even when it is a diagnostic
        subset. The older complete record must not be silently substituted,
        and the subset must not read as a whole-row PASS.
        """
        full_id, partial_id = "20260923-005938-b62ac83", "20260924-010101-abcdef0"
        self._add_record(full_id, self.CURRENT_DUT)
        self._write_matrix(full_id, _full_envelope_rows())
        self._add_record(partial_id, self.CURRENT_DUT)
        self._write_matrix(partial_id, [_matrix_row(1, 1.0, 0.5, "PASS")])

        record, snapshot = bcr.latest_substantive_record(self.SLUG)
        self.assertEqual(record.stem, partial_id)
        self.assertEqual(bcr.freshness(snapshot, "ldo_core")[0], "fresh")
        env = bcr.envelope_verdict(record, bcr.DR0018_STABILITY_ENVELOPE)
        self.assertEqual(env["verdict"], "UNKNOWN")
        self.assertEqual(env["coverage"]["n_covered"], 1)
        self.assertEqual(env["coverage"]["n_required"], 630)

        # The older complete record, graded on its own, is still a PASS --
        # the downgrade comes from the selected record, not from the grader.
        older = bcr.envelope_verdict(self.records_dir / f"{full_id}.md",
                                     bcr.DR0018_STABILITY_ENVELOPE)
        self.assertEqual(older["verdict"], "PASS")

    def test_an_empty_or_missing_records_directory_is_still_none_none(self):
        self.assertEqual(bcr.latest_substantive_record(self.SLUG), (None, None))
        self.assertEqual(
            bcr.latest_substantive_record("zz-no-such-slug"), (None, None)
        )


class TestCommittedTreeSelection(unittest.TestCase):
    """The same rule against the real, committed records under `sim/`.

    Stated as the invariant rather than as "today's answer": for every slug
    the report cites, if *any* of that slug's records matches the current
    DUT then the selected record must be the newest such record. A future
    branch that legitimately lands an out-of-order record (the #311
    scenario) therefore exercises this test rather than breaking it.
    """

    def _fresh_record_ids(self, slug: str) -> list[str]:
        records_dir = bcr.SIM_DIR / slug / "records"
        snapshots_dir = bcr.SIM_DIR / slug / "netlist-snapshots"
        return [
            record.stem
            for record in sorted(records_dir.glob("*.md"))
            if bcr.freshness(
                snapshots_dir / f"{record.stem}.spice", bcr.expected_dut(slug)
            )[0]
            == "fresh"
        ]

    def test_no_cited_slug_is_reported_stale_while_a_matching_record_exists(self):
        slugs = sorted({source.slug for row in bcr.ROWS for source in row.sources})
        self.assertGreater(len(slugs), 5, "row->slug mapping not found")
        checked = 0
        for slug in slugs:
            fresh_ids = self._fresh_record_ids(slug)
            if not fresh_ids:
                continue  # every record predates the current DUT: row is stale
            checked += 1
            with self.subTest(slug=slug):
                record, snapshot = bcr.latest_substantive_record(slug)
                self.assertEqual(bcr.freshness(snapshot, bcr.expected_dut(slug))[0], "fresh")
                self.assertEqual(record.stem, fresh_ids[-1])
        self.assertGreater(checked, 0, "no committed slug has a fresh record")


class TestFreshnessBindsToDesignatedDut(unittest.TestCase):
    """Freshness identifies the circuit actually measured (issue #393).

    A snapshot that merely *contains* the current standalone amplifier as an
    included supporting cell must not be fresh for a core source. Synthetic
    trees only; the committed evidence is not consulted.
    """

    CORE = ".subckt ldo_core vin vout\nRz n1 n2 1k ppolyf_u_3k\n.ends\n"
    STALE_CORE = ".subckt ldo_core vin vout\nRz n1 n2 1k ppolyf_u_1k\n.ends\n"
    AMP = ".subckt error_amp inp inn out\nRa a b 1k\n.ends\n"
    STALE_AMP = ".subckt error_amp inp inn out\nRa a b 2k\n.ends\n"
    CORE_REL = "design/netlist/ldo_core.spice"
    AMP_REL = "design/netlist/error_amp.spice"
    SLUG = "zz-bind-fixture"

    def setUp(self):
        self._tmp = tempfile.TemporaryDirectory()
        self.addCleanup(self._tmp.cleanup)
        self.root = Path(self._tmp.name)
        netlists = self.root / "design" / "netlist"
        netlists.mkdir(parents=True)
        core = netlists / "ldo_core.spice"
        amp = netlists / "error_amp.spice"
        core.write_text(self.CORE)
        amp.write_text(self.AMP)
        for name, value in (
            ("REPO_ROOT", self.root),
            ("SIM_DIR", self.root / "sim"),
            ("DUT_CANDIDATES", {"ldo_core": core, "error_amp": amp}),
            ("DUT_BY_SLUG", {self.SLUG: "ldo_core"}),
        ):
            original = getattr(bcr, name)
            setattr(bcr, name, value)
            self.addCleanup(setattr, bcr, name, original)

    @staticmethod
    def _section(label: str, path: str, body: str) -> str:
        bar = "* " + "=" * 70
        return f"{bar}\n* {label:<21}: {path}\n* sha256               : 00\n{bar}\n{body}"

    def _snap(self, name: str, text: str) -> Path:
        path = self.root / f"{name}.spice"
        path.write_text(text)
        return path

    def _harness(self, dut_rel: str, dut_body: str, cells=()) -> str:
        parts = ["* Frozen netlist snapshot\n\n"]
        parts.append(self._section("DUT netlist", dut_rel, dut_body))
        for rel, body in cells:
            parts.append(self._section("included design cell", rel, body))
        parts.append(self._section("testbench fragment", "sim/x/tb.spice", ".end\n"))
        return "\n".join(parts)

    def test_stale_core_with_current_included_amp_is_stale_for_a_core_source(self):
        snap = self._snap(
            "a",
            self._harness(self.CORE_REL, self.STALE_CORE, [(self.AMP_REL, self.AMP)]),
        )
        self.assertEqual(bcr.freshness(snap, "ldo_core"), ("stale", None, None))

    def test_current_core_dut_is_fresh_for_core(self):
        snap = self._snap(
            "b",
            self._harness(self.CORE_REL, self.CORE, [(self.AMP_REL, self.STALE_AMP)]),
        )
        self.assertEqual(bcr.freshness(snap, "ldo_core"), ("fresh", "ldo_core", None))

    def test_current_core_with_stale_supporting_amp_is_not_an_amp_measurement(self):
        snap = self._snap(
            "c",
            self._harness(self.CORE_REL, self.CORE, [(self.AMP_REL, self.STALE_AMP)]),
        )
        status, label, reason = bcr.freshness(snap, "error_amp")
        self.assertEqual(status, "unknown")
        self.assertIsNone(label)
        self.assertIn(self.CORE_REL, reason)

    def test_current_core_with_current_included_amp_is_not_fresh_for_an_amp_source(self):
        snap = self._snap(
            "d",
            self._harness(self.CORE_REL, self.CORE, [(self.AMP_REL, self.AMP)]),
        )
        self.assertEqual(bcr.freshness(snap, "error_amp")[0], "unknown")

    def test_standalone_amp_with_current_content_is_fresh_for_amp(self):
        bar = self._section("included design cell", self.AMP_REL, self.AMP)
        snap = self._snap("e", "* hdr\n" + bar + self._section("testbench fragment", "t", "x\n"))
        self.assertEqual(bcr.freshness(snap, "error_amp"), ("fresh", "error_amp", None))

    def test_standalone_stale_amp_is_stale_for_amp(self):
        snap = self._snap("f", "* hdr\n" + self._section("DUT netlist", self.AMP_REL, self.STALE_AMP))
        self.assertEqual(bcr.freshness(snap, "error_amp"), ("stale", None, None))

    def test_legacy_headerless_snapshots_are_compared_to_the_expected_netlist_only(self):
        core_only = self._snap("g", "* legacy\n" + self.CORE)
        amp_only = self._snap("h", "* legacy\n" + self.AMP)
        self.assertEqual(bcr.freshness(core_only, "ldo_core")[0], "fresh")
        self.assertEqual(bcr.freshness(core_only, "error_amp")[0], "stale")
        self.assertEqual(bcr.freshness(amp_only, "error_amp")[0], "fresh")
        # The demonstrated defect: stale core + current amp, headerless.
        mixed = self._snap("i", "* legacy\n" + self.STALE_CORE + self.AMP)
        self.assertEqual(bcr.freshness(mixed, "ldo_core"), ("stale", None, None))

    def test_legacy_source_header_naming_another_netlist_is_unknown(self):
        snap = self._snap("j", f"* source     : {self.AMP_REL}\n" + self.AMP)
        status, _label, reason = bcr.freshness(snap, "ldo_core")
        self.assertEqual(status, "unknown")
        self.assertIn(self.AMP_REL, reason)

    def test_missing_snapshot_unmapped_dut_and_ambiguous_dut_are_unknown_with_reason(self):
        self.assertEqual(bcr.freshness(None, "ldo_core")[0], "unknown")
        snap = self._snap("k", "* legacy\n" + self.CORE)
        status, _l, reason = bcr.freshness(snap, None)
        self.assertEqual((status, bool(reason)), ("unknown", True))
        two = self._snap(
            "l",
            "* h\n"
            + self._section("DUT netlist", self.CORE_REL, self.CORE)
            + self._section("DUT netlist", self.CORE_REL, self.CORE),
        )
        status, _l, reason = bcr.freshness(two, "ldo_core")
        self.assertEqual(status, "unknown")
        self.assertIn("more than one", reason)

    def test_selection_rejects_incidental_amp_match_but_keeps_genuine_earlier_fresh(self):
        records = self.root / "sim" / self.SLUG / "records"
        snaps = self.root / "sim" / self.SLUG / "netlist-snapshots"
        records.mkdir(parents=True)
        snaps.mkdir(parents=True)
        for rid in ("20260901-000000-aaaaaaa", "20260902-000000-bbbbbbb"):
            (records / f"{rid}.md").write_text("**Overall: PASS**\n")
        # Older: genuinely current core. Newer: stale core + current amp.
        (snaps / "20260901-000000-aaaaaaa.spice").write_text(
            self._harness(self.CORE_REL, self.CORE)
        )
        (snaps / "20260902-000000-bbbbbbb.spice").write_text(
            self._harness(self.CORE_REL, self.STALE_CORE, [(self.AMP_REL, self.AMP)])
        )
        record, _snap = bcr.latest_substantive_record(self.SLUG)
        self.assertEqual(record.stem, "20260901-000000-aaaaaaa")
        # With only the incidental match available the row stays stale and
        # cites the newest evidence.
        (snaps / "20260901-000000-aaaaaaa.spice").write_text(
            self._harness(self.CORE_REL, self.STALE_CORE)
        )
        record, snap = bcr.latest_substantive_record(self.SLUG)
        self.assertEqual(record.stem, "20260902-000000-bbbbbbb")
        self.assertEqual(bcr.freshness(snap, "ldo_core")[0], "stale")


class TestStoreBackedRecordFreshness(unittest.TestCase):
    """A record whose snapshot is in the artifact store is still evidence.

    Since DR-0041 (issue #511) `python3 sim/run_corners.py <bench>` puts the
    frozen netlist snapshot in the fleet artifact store and commits only the
    run's manifest and its Markdown record, so
    `sim/<slug>/netlist-snapshots/<record-id>.spice` is not a file. Requiring
    that file made `latest_substantive_record()` skip every such record
    (issue #597): the row kept citing an older, snapshotted record, or
    reported `unknown` when no record of the bench had a committed snapshot.

    These assert the rule, not the committed tree -- no store-backed record
    exists under `sim/` yet, which is exactly why the committed-output diff
    in CI cannot catch this. Synthetic trees only: `bcr.REPO_ROOT`,
    `bcr.SIM_DIR`, `bcr.DUT_CANDIDATES` and `bcr.DUT_BY_SLUG` are repointed
    at a tempdir.
    """

    SLUG = "zz-store-backed-fixture"
    CORE = ".subckt ldo_core vin vout\nRz n1 n2 1k ppolyf_u_3k\n.ends\n"
    STALE_CORE = ".subckt ldo_core vin vout\nRz n1 n2 1k ppolyf_u_1k\n.ends\n"
    AMP = ".subckt error_amp inp inn out\nRa a b 1k\n.ends\n"
    CORE_REL = "design/netlist/ldo_core.spice"
    AMP_REL = "design/netlist/error_amp.spice"

    def setUp(self):
        self._tmp = tempfile.TemporaryDirectory()
        self.addCleanup(self._tmp.cleanup)
        self.root = Path(self._tmp.name)
        netlists = self.root / "design" / "netlist"
        netlists.mkdir(parents=True)
        self.core = netlists / "ldo_core.spice"
        self.amp = netlists / "error_amp.spice"
        self.core.write_text(self.CORE)
        self.amp.write_text(self.AMP)

        self.records_dir = self.root / "sim" / self.SLUG / "records"
        self.snapshots_dir = self.root / "sim" / self.SLUG / "netlist-snapshots"
        self.manifests_dir = self.root / "manifests" / "artifacts"
        for directory in (self.records_dir, self.snapshots_dir, self.manifests_dir):
            directory.mkdir(parents=True)

        for name, value in (
            ("REPO_ROOT", self.root),
            ("SIM_DIR", self.root / "sim"),
            ("DUT_CANDIDATES", {"ldo_core": self.core, "error_amp": self.amp}),
            ("DUT_BY_SLUG", {self.SLUG: "ldo_core"}),
        ):
            original = getattr(bcr, name)
            setattr(bcr, name, value)
            self.addCleanup(setattr, bcr, name, original)

    # -- fixture builders ------------------------------------------------

    @staticmethod
    def _sha(text: str) -> str:
        return hashlib.sha256(text.encode()).hexdigest()

    def _record(
        self,
        record_id: str,
        *,
        dut_rel: str | None = CORE_REL,
        dut_sha: str | None = None,
        includes: tuple[tuple[str, str], ...] = (),
        manifest_sha: str | None = None,
    ) -> Path:
        """A Markdown record shaped as `sim/harness/report.py` renders one.

        `dut_rel=None` is the `error_amp` bench shape: the testbench names no
        DUT, so the record has no `DUT netlist:` Links bullet and no
        `DUT netlist sha256:` line -- the netlist appears only as an
        `Included design netlist` entry.
        """
        lines = [
            f"# Record {record_id}",
            "",
            f"- **Record ID**: {record_id}",
            "- **Links**:",
            f"  - Testbench: `sim/{self.SLUG}/testbench/tb.spice`",
        ]
        if dut_rel is not None:
            lines.append(f"  - DUT netlist: `{dut_rel}`")
        lines += [
            f"  - Netlist snapshot: `sim/{self.SLUG}/netlist-snapshots/{record_id}.spice`",
            "",
            "**Overall: PASS**",
            "",
            "## Environment",
            "",
            f"- Testbench netlist sha256: `{self._sha('tb')}`",
        ]
        if dut_sha is not None:
            lines.append(f"- DUT netlist sha256: `{dut_sha}`")
        # The decoy: `Manifest sha256` hashes the bench's tb.json, never a
        # netlist, so it must never satisfy a DUT comparison.
        lines.append(f"- Manifest sha256: `{manifest_sha or self._sha('tb.json')}`")
        for path, sha in includes:
            lines.append(f"- Included design netlist `{path}` sha256: `{sha}`")
        lines.append("")
        path = self.records_dir / f"{record_id}.md"
        path.write_text("\n".join(lines))
        return path

    def _manifest(self, record_id: str, *, entry_name: str | None = None) -> Path:
        """The committed artifact manifest `store_files()` installs.

        `entry_name` overrides the snapshot entry's name, for the case of a
        manifest that stores a run's logs but not its netlist snapshot.
        """
        if entry_name is None:
            entry_name = f"sim/{self.SLUG}/netlist-snapshots/{record_id}.spice"
        path = self.manifests_dir / f"{self.SLUG}-{record_id}.manifest.json"
        path.write_text(
            json.dumps(
                {
                    "schema_version": 1,
                    "entries": [
                        {"name": entry_name, "sha256": "ab" * 32, "size": 4096},
                        {
                            "name": f"sim/{self.SLUG}/corners/{record_id}/tt.log",
                            "sha256": "cd" * 32,
                            "size": 128,
                        },
                    ],
                },
                indent=2,
            )
            + "\n"
        )
        return path

    def _committed_snapshot(self, record_id: str, body: str) -> None:
        bar = "* " + "=" * 70
        (self.snapshots_dir / f"{record_id}.spice").write_text(
            f"* Frozen netlist snapshot\n\n{bar}\n"
            f"* {'DUT netlist':<21}: {self.CORE_REL}\n"
            f"* {'sha256':<21}: 00\n{bar}\n{body}"
        )

    def _store_backed(self, record_id: str, dut_sha: str) -> Path:
        record = self._record(record_id, dut_sha=dut_sha)
        self._manifest(record_id)
        return record

    # -- acceptance criteria --------------------------------------------

    def test_store_backed_record_is_cited_fresh_over_an_older_stale_snapshot(self):
        """The #597 defect: the newest record is store-backed and current,
        an older one has a committed snapshot of a superseded DUT. The row
        must cite the newest and report it fresh.
        """
        self._record("20261101-000000-0ld0ld0", dut_sha=self._sha(self.STALE_CORE))
        self._committed_snapshot("20261101-000000-0ld0ld0", self.STALE_CORE)
        newest = self._store_backed("20261110-120000-abcdef0", self._sha(self.CORE))

        record, snapshot = bcr.latest_substantive_record(self.SLUG)
        self.assertEqual(record, newest)
        self.assertIsNone(snapshot, "a store-backed record has no snapshot file")
        self.assertEqual(
            bcr.record_freshness(record, snapshot, "ldo_core"),
            ("fresh", "ldo_core", None),
        )

    def test_store_backed_record_with_a_superseded_dut_sha_is_stale(self):
        record = self._store_backed("20261110-120000-abcdef0", self._sha(self.STALE_CORE))
        self.assertEqual(
            bcr.record_freshness(record, None, "ldo_core"), ("stale", None, None)
        )
        # ...and it is still the cited record: a stale row cites its newest
        # evidence rather than silently reaching back past it.
        selected, snapshot = bcr.latest_substantive_record(self.SLUG)
        self.assertEqual(selected, record)
        self.assertIsNone(snapshot)

    def test_a_record_with_neither_snapshot_nor_manifest_is_still_skipped(self):
        """Unchanged: a metadata-only correction record is not a measurement,
        and must not outrank the older measurement it points back at.
        """
        self._record("20261101-000000-0ld0ld0", dut_sha=self._sha(self.CORE))
        self._committed_snapshot("20261101-000000-0ld0ld0", self.CORE)
        self._record("20261110-120000-abcdef0", dut_sha=self._sha(self.CORE))

        record, snapshot = bcr.latest_substantive_record(self.SLUG)
        self.assertEqual(record.stem, "20261101-000000-0ld0ld0")
        self.assertIsNotNone(snapshot)

    def test_a_store_backed_record_with_no_sha_for_the_expected_dut_is_unknown(self):
        """No sha256 line for the expected netlist is `unknown` with a
        reason -- never matched against another hash the record happens to
        state. The fixture's `Manifest sha256` is deliberately set to the
        current DUT's hash: reading it would report a false `fresh`.
        """
        record = self._record(
            "20261110-120000-abcdef0",
            dut_sha=None,
            manifest_sha=self._sha(self.CORE),
        )
        self._manifest("20261110-120000-abcdef0")

        status, label, reason = bcr.record_freshness(record, None, "ldo_core")
        self.assertEqual(status, "unknown")
        self.assertIsNone(label)
        self.assertIn(self.CORE_REL, reason)
        self.assertIn("stored, not committed", reason)

    def test_the_regenerated_report_is_unchanged_on_the_committed_tree(self):
        """AC: `python3 sim/build_characterization_report.py` still matches
        the committed `sim/CHARACTERIZATION.md` byte for byte -- the same
        check CI's diff step performs, asserted here against the real tree.
        """
        proc = subprocess.run(
            [sys.executable, str(_REPORT_PATH)],
            capture_output=True,
            text=True,
            check=False,
        )
        self.assertEqual(proc.returncode, 0, proc.stderr)
        self.assertEqual(
            proc.stdout,
            (SIM_DIR / "CHARACTERIZATION.md").read_text(),
            "regenerated report differs from the committed one",
        )

    def test_the_report_builder_makes_no_network_or_store_call(self):
        """AC: grading a store-backed record reads committed bytes only.

        Asserted structurally rather than by mocking: the module imports no
        transport or subprocess machinery at all, so there is no code path
        that could reach the broker.
        """
        source = _REPORT_PATH.read_text()
        tree = ast.parse(source)
        imported = set()
        for node in ast.walk(tree):
            if isinstance(node, ast.Import):
                imported.update(alias.name.split(".")[0] for alias in node.names)
            elif isinstance(node, ast.ImportFrom) and node.module:
                imported.add(node.module.split(".")[0])
        self.assertEqual(
            imported & {"subprocess", "socket", "http", "urllib", "requests", "os"},
            set(),
            f"report builder imports a transport/subprocess module: {sorted(imported)}",
        )
        self.assertNotIn("klt artifact", source)

    # -- edge cases ------------------------------------------------------

    def test_expected_dut_listed_only_as_an_included_design_cell_is_graded(self):
        """The `error_amp` bench shape: the testbench designates no DUT, so
        the netlist appears only as an `Included design netlist` line.
        """
        bcr.DUT_BY_SLUG[self.SLUG] = "error_amp"
        record = self._record(
            "20261110-120000-abcdef0",
            dut_rel=None,
            includes=((self.AMP_REL, self._sha(self.AMP)),),
        )
        self._manifest("20261110-120000-abcdef0")
        self.assertEqual(
            bcr.record_freshness(record, None, "error_amp"),
            ("fresh", "error_amp", None),
        )
        self.assertEqual(bcr.latest_substantive_record(self.SLUG)[0], record)

    def test_a_record_designating_another_dut_is_unknown_not_matched(self):
        """Issue #393's rule, carried over: a record that measured the core
        is not an `error_amp` measurement even when it froze the current amp
        alongside it.
        """
        record = self._record(
            "20261110-120000-abcdef0",
            dut_rel=self.CORE_REL,
            dut_sha=self._sha(self.CORE),
            includes=((self.AMP_REL, self._sha(self.AMP)),),
        )
        self._manifest("20261110-120000-abcdef0")
        status, label, reason = bcr.record_freshness(record, None, "error_amp")
        self.assertEqual(status, "unknown")
        self.assertIsNone(label)
        self.assertIn(self.CORE_REL, reason)

    def test_an_unmapped_slug_is_unknown_for_a_store_backed_record(self):
        record = self._store_backed("20261110-120000-abcdef0", self._sha(self.CORE))
        status, label, reason = bcr.record_freshness(record, None, None)
        self.assertEqual((status, label), ("unknown", None))
        self.assertIn("no expected DUT", reason)

    def test_a_manifest_without_the_snapshot_entry_counts_as_no_manifest(self):
        record_id = "20261110-120000-abcdef0"
        self._record(record_id, dut_sha=self._sha(self.CORE))
        self._manifest(record_id, entry_name=f"sim/{self.SLUG}/corners/{record_id}/tt.log")
        self.assertIsNone(
            bcr.stored_snapshot_manifest(self.records_dir / f"{record_id}.md")
        )
        # ...so it is skipped like a correction record, and the older
        # snapshotted measurement is cited instead.
        self._record("20261101-000000-0ld0ld0", dut_sha=self._sha(self.CORE))
        self._committed_snapshot("20261101-000000-0ld0ld0", self.CORE)
        self.assertEqual(
            bcr.latest_substantive_record(self.SLUG)[0].stem, "20261101-000000-0ld0ld0"
        )

    def test_a_malformed_manifest_counts_as_no_manifest_rather_than_raising(self):
        record_id = "20261110-120000-abcdef0"
        self._record(record_id, dut_sha=self._sha(self.CORE))
        (self.manifests_dir / f"{self.SLUG}-{record_id}.manifest.json").write_text(
            "{not json"
        )
        self.assertIsNone(
            bcr.stored_snapshot_manifest(self.records_dir / f"{record_id}.md")
        )
        self.assertEqual(bcr.latest_substantive_record(self.SLUG), (
            self.records_dir / f"{record_id}.md", None
        ))

    def test_a_committed_snapshot_still_outranks_the_records_own_hashes(self):
        """Where both exist the snapshot file is what is graded, so no
        landed row's verdict changes: the record below states the current
        DUT's sha but its committed snapshot froze the superseded netlist.
        """
        record_id = "20261110-120000-abcdef0"
        record = self._record(record_id, dut_sha=self._sha(self.CORE))
        self._committed_snapshot(record_id, self.STALE_CORE)
        self._manifest(record_id)
        snapshot = self.snapshots_dir / f"{record_id}.spice"
        self.assertEqual(
            bcr.record_freshness(record, snapshot, "ldo_core"), ("stale", None, None)
        )
        self.assertEqual(
            bcr.latest_substantive_record(self.SLUG), (record, snapshot)
        )


if __name__ == "__main__":
    unittest.main()
