2AMLogic/gf180-ldo/(commit log)

2026-07-29 Scaffold canary block: Low-dropout regulator on gf180mcu
    Selected by the scored block matrix (marketing repo strategy/).
    Draft spec pending engineering ratification.
2026-07-31 docs: add LDO architecture survey recommending PMOS pass device and output-cap-dominant compensation (#19)
2026-07-31 docs: define sim/ append-only evidence record format (#18)
    * docs: define sim/ append-only evidence record format
    Adds sim/README.md defining the record-ID scheme, directory convention,
    and summary-record fields for sim/ evidence (mirroring gf180-bandgap's
    ratified sim/README.md, since its competing JSON-manifest harness PR
    was still unmerged at build time). Extends the schema with an
    LDO-specific Operating conditions field (load current, output cap/ESR,
    enable state) that bandgap's process/temp/supply-only convention does
    not need, plus a note reconciling #4's interim CSV/README characterization
    tables with this convention.
    Commits one worked example under sim/dropout-vs-load/ (testbench,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
2026-07-31 docs: propose decision records for output-cap window, input flavor, output programmability (#21)
    Adds three `proposed` decision records under spec/decision-records/, written
    against the DR-NNNN template:
    - DR-0001 ratifies an effective output-cap envelope of 0.33-4.7 uF with a
    0-500 mOhm ESR window (ceramic-stable, no minimum ESR) and forks capless
    as a separate variant. Numbers are concrete enough to enumerate the
    load x cap x ESR x PVT stability matrix.
    - DR-0002 defers 5 V input compatibility to a follow-on variant, keeps the
    amplifier on 3.3 V devices, and states a falsifiable revisit trigger
    against the device-characterization data that has not landed yet.
    - DR-0003 keeps the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
2026-07-31 docs: document .raw waveform files as scratch, not evidence (#23)
    Closes the gap in sim/README.md's evidence convention: the root
    .gitignore has ignored *.raw with no negation all along, but nothing
    said so explicitly. Binary ngspice rawfiles are large, opaque, and
    not diffable across a 9-point PVT matrix, and every claim the record
    format supports is already required to be a scalar/point extraction
    reproducible from the committed .log via .meas/print. Document that
    as the deliberate choice so a harness author knows up front that
    `write out.raw` output will not be evidence, before #2 lands the
    first real harness run.
    Closes #20
2026-07-31 feat: characterize gf180mcu pass-FETs, resistors, and caps for the LDO (#22)
    * feat: characterize gf180mcu pass-FETs, resistors, and caps for the LDO
    Add ngspice-based device-characterization decks and result tables under
    sim/devchar/ covering the LDO's candidate pass-FET, feedback-divider
    resistor, and compensation-capacitor flavors in the gf180mcu PDK.
    - fets/: Rds(on) vs width at the real dropout test point (Vin = Vout +
    dropout, not the 2.97 V supply floor), gate/gate-drain capacitance,
    off-state leakage, and threshold-voltage extraction for pfet_03v3,
    nfet_03v3, and the 05v0/06v0 mid-voltage flavors, across ff/ss/fs/sf/
    typical corners and -40/27/125 C.
    - resistors/: extracted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
    [cgg_nmos.csv, cgg_pmos.csv, coverage.csv, leak_nmos.csv, leak_pmos.csv, mim.csv, mismatch_mc_raw.csv, moscap.csv]
2026-07-31 feat: add ngspice PVT corner-runner harness (#24)
    * feat: add ngspice PVT corner-runner harness
    Ports the gf180-bandgap harness pattern (issue #2, PR #23) to gf180-ldo:
    a stdlib-python3 sim/harness/ package (PDK discovery, corner definitions,
    deck composition, ngspice execution, and Markdown evidence-record writing)
    plus sim/run_corners.py, sim/selftest.sh, sim/env.sh and sim/pdk.json.
    Adapts the record writer to this repo's LDO-specific "Operating conditions"
    evidence field (sim/README.md) that a bandgap does not need, and includes
    sim/smoke-bias/ as the harness's own PVT-plumbing acceptance test.
    * test: record a clean smoke-bias PVT evidence run
    Real end-to-end acceptance evidence for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
    [test_harness.py]
2026-07-31 docs: rewrite README and CLAUDE.md for a public audience, add Apache-2.0 LICENSE (#26)
    Prepares this repo's public-facing surface ahead of the open-source
    publication decision.
    - LICENSE: add the canonical, unmodified Apache-2.0 text with the appendix
    copyright line filled in (no LICENSE existed before).
    - README.md: rewrite the header for readers who have never seen this repo —
    what the block is, which PDK and open-source tools it uses, an explicit
    early-stage status disclaimer (no schematic, no layout, no silicon), and
    the agent-native build story stated plainly. Drop the private/proprietary
    banner, the catalog/business framing, and the internal competitive
    selection rationa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
2026-07-31 feat: add GitHub Actions CI running the harness self-test (#29)
    Wires sim/selftest.sh (which runs sim/tests/test_harness.py's unittest
    suite, then gracefully skips its PDK-backed PVT stage when ngspice/PDK
    are absent) into a push/PR-triggered workflow that stays headless by
    design. A separate pvt-smoke job runs the same self-test with the real
    gf180mcu PDK, gated to a nightly schedule, workflow_dispatch, or an
    opt-in `ci:pdk-smoke` PR label so it never blocks the default PR path.
    Also wires package.json's placeholder check:ci/check:all/test scripts
    to the real commands.
2026-07-31 docs: ratify the target spec table with amendments A1-A12 (#33)
    Replace the DRAFT spec table in README.md with the ratified table: the
    Input, Output and Stability rows are the verbatim replacement text from
    DR-0002, DR-0003 and DR-0001, and the table gains current-limit,
    load-transient, line-regulation, startup, enable/shutdown, thermal and
    output-noise rows plus per-row corner bindings and conditions carried in
    seven numbered notes that are part of the spec.
    Mark DR-0001..0003 ratified and add DR-0004, which records the operator's
    2026-07-31 ratification of issue #1, the disposition of each amendment,
    the two judgment calls the amendments left to the spec (accuracy is
    regulator-only; the c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
2026-07-31 feat: add ldo_core xschem schematic with placeholder amp and DC sanity sim (#34)
    Enters the LDO core (pass device, feedback divider, enable stub, and a
    behavioral placeholder error amp) in xschem against gf180mcu, exports a
    reproducible/ERC-checked ngspice netlist via design/netlist.py, and records
    a nominal-conditions DC operating-point sanity result under
    sim/op-point-sanity/. The real error amp (#9) and current-limit circuitry
    (#11) are explicitly out of scope; ldo_core exposes a two-port loop-break
    (ERRAMP_OUT/PASS_GATE) and a current-sense tap (Mpass.D-VOUT) for them.
    [ldo_core.sch, ldo_erramp_placeholder.sch]
2026-08-01 feat: design the LDO error amplifier against offset, PSRR and Iq budgets (#35)
    * feat: replace the placeholder error amp with a real two-stage OTA
    Adds design/error_amp.{sch,sym} -- an NMOS-input, PMOS-mirror-load,
    two-stage Miller-compensated OTA with a nulling resistor and a
    supply-referenced self-bias (no external bias or enable pin), on the
    INP INN OUT VDD VSS pinout issue #8 ratified. ldo_core instantiates it in
    place of ldo_erramp_placeholder, which is deleted; the symbol reuses the
    placeholder's pin coordinates so the swap is a symbol-name change with no
    rewiring.
    ldo_core's reference moves 0.6 V -> 1.2 V with the divider re-ratioed to
    300k/600k (beta = 2/3). The binding reason is i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
    [error_amp.sch, ldo_core.sch, ldo_erramp_placeholder.sch]
2026-08-01 feat: constant-current limit, real enable/shutdown path, and their PVT evidence (#39)
    * feat: add constant-current limit and a real enable path to the LDO core
    Adds design/ldo_ilimit.sch, a constant-current (brickwall) current limit,
    and turns issue #8's one-transistor enable stub into a real low-current
    disabled state by gating every bias branch in the hierarchy.
    The limit senses a 1/40 replica of the pass device off PASS_GATE and
    returns that current to VOUT through Rsns, so the sensed current is
    delivered to the load rather than burned -- the pass path keeps its
    original Mpass.D-to-VOUT wire and ldo_core's topology is unchanged.
    A VREF/Rbias-derived reference current through Rref, also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
    [error_amp.sch, ldo_core.sch, ldo_ilimit.sch, summary.csv]
2026-08-01 feat: add per-spec-line LDO testbench suite with PVT evidence records (#37)
    Builds seven sim/<slug>/ experiments (dropout-vs-load, load-regulation,
    line-regulation, load-transient, psrr-vs-freq, quiescent-current, startup),
    one per ratified README.md spec line, each run across the full PVT matrix
    via sim/run_corners.py and recorded per sim/README.md's append-only format.
    Extends sim/harness/ with a `dut_netlist` testbench-manifest field (plus
    --dut-netlist CLI override) so a testbench can instantiate a real DUT
    (design/netlist/ldo_core.spice) through the harness -- the fragment
    .include restriction previously forced every DUT-instantiating testbench
    to bypass the harness entirely (as sim/op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
2026-08-01 sim: run the mc-output-accuracy Monte Carlo deck and record 45-point evidence (#41)
    * sim: add Monte Carlo mismatch deck for closed-loop output accuracy
    Adds sim/mc-output-accuracy/, a Monte Carlo local-mismatch testbench for the
    ratified 1.8 V +/-2% output-accuracy row. The deck Monte-Carlos every FET in
    the loop through the PDK's real per-instance sw_stat_mismatch model and
    deliberately does NOT Monte Carlo the feedback divider, which this PDK cannot
    model (mis_r = 0); it instead measures a per-sample identity that proves the
    divider contributed nothing, so design/error_amp.md S3.2's hand-budgeted
    divider term stays additive rather than double-counted.
    25 independent ldo_core copies per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
    [summarize.py]
2026-08-01 sim: add Tian dual-injection loop-gain testbench and record the DR-0001 stability matrix (#36)
    * sim: add Tian dual-injection loop-gain testbench for ldo_core
    Adds sim/loop-stability/, the experiment that measures the LDO loop gain
    and extracts phase margin / gain margin against the criterion ratified in
    spec/decision-records/DR-0001-output-cap-strategy.md.
    - tb_loop_stability.spice.in breaks the loop at ldo_core's deliberately
    unconnected ERRAMP_OUT -> PASS_GATE ports and injects both a series
    voltage and a shunt current, combining them with the Tian/Middlebrook
    formula. The break sits between a ~1 MOhm driver impedance and a few pF
    of pass-gate capacitance, so single-injection ac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
    [20260801-002833-b8ce7d0-matrix.csv, 20260801-050406-65416d2-matrix.csv]
2026-08-01 layout: stand up the gf180mcu DRC/LVS flow on a one-transistor test cell (#45)
    Adds `python3 layout/drclvs.py` -- a single command that builds a small
    gf180mcu test cell, runs DRC against two decks, and runs LVS against the
    netlist exported from that cell's own xschem schematic.
    The test cell is deliberately one nfet_03v3 with a guard-ring bulk tie,
    generated from the PDK's own PCell so the geometry is correct by
    construction: when the deck and the invocation are what is under test,
    hand-drawn geometry makes every failure ambiguous. It is not part of the
    LDO, and no LDO layout exists yet -- the flow is the deliverable.
    Seven stages, all of which must pass for exit 0:
    1 build the GDS fro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
    [drclvs_testcell.sch]
2026-08-01 sim: add nodeset bias hints and re-record dropout-vs-load against the current DUT (#47)
    ngspice's default all-zero initial guess lets Newton-Raphson converge
    "successfully" onto a non-physical DC operating point for this closed,
    high-gain LDO loop at load (the pass device off, with the load's ideal
    current sink forced through parasitic leakage to tens of volts). Add a
    manifest-level `nodeset` field (Testbench.nodeset -> `.nodeset v(node)=value
    ...`) to sim/harness so a testbench can bias the initial guess into the
    physical solution's basin without constraining the converged answer.
    Use it to fix and re-record dropout-vs-load (15/15 corners now converge to a
    consistent, physical ~300 mV read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
    [test_harness.py]
2026-08-01 feat: add a soft-start clamp that ramps the output at enable, with 163-point PVT evidence (#44)
    * feat: add ldo_softstart, a pass-gate clamp that ramps the output at enable
    The ratified Startup row failed two clauses at nearly every corner (#38):
    uncontrolled inrush (153-289 mA peak supply current) and up to +6.5%
    overshoot, because there was no soft-start element in the design at all.
    ldo_softstart generates a linear voltage ramp on an internal capacitor and
    holds VOUT to 1.5x that ramp with a PMOS-input comparator driving a clamp on
    PASS_GATE -- the same clamp idiom ldo_ilimit already uses. It disengages
    completely once the ramp passes VREF, so the settled loop is untouched: Men's
    gate i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
    [ldo_core.sch, ldo_softstart.sch, summary.csv]
2026-08-01 sim: replace ideal load sinks with compliance-limited sinks and re-record five experiments (#49)
    The .dc/.op/.ac decks that load ldo_core with an ideal current sink
    (`Iload VOUT 0 DC 50m`) have a second, genuinely non-physical DC solution:
    an ideal sink demands its commanded current at any terminal voltage,
    including tens of volts below ground, where the only thing that can supply
    it is forward-biased substrate junctions in the PDK models. A cold
    Newton-Raphson start reaches it, and #40 showed a `.nodeset` hint could not
    reliably steer away from it once a deck also sweeps load/supply or runs
    several DUT instances.
    Replace the ideal sink with a compliance-limited behavioural sink
    (`Vilc`/`Bl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
    [test_harness.py]
2026-08-01 sim/startup: fix runaway integration cost with .options method=gear (#50)
    The 45-point startup matrix stopped completing after the DUT gained
    Xilimit (#11/PR #39) and Xsoftstart (#38/PR #44): ngspice's default
    trapezoidal integrator rings across the near-short branch's fast
    current-limit clamping event and collapses the whole deck's global
    timestep, since all three branches (full/min/short load) share one
    tran analysis. Measured at tt_27c_3.30v, this took >120s CPU and did
    not finish the 6ms window (matching the issue's own ~2min-CPU-for-
    1.49ms-of-6ms finding); a from-scratch re-measurement in this session
    also showed the isolated near-short branch alone not finishing within
    900s wall under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
2026-08-01 fix: add a feedforward compensation zero to narrow the LDO loop-stability gap (#52)
    * feat: add a feedforward compensation zero to the LDO loop's feedback path
    Closes DR-0001's stability FAIL by adding Cff (~15 pF) from VOUT to FB, in
    parallel with Rtop -- a genuine left-half-plane zero at 1/(2*pi*Rtop*Cff)
    that does not depend on the external output cap's ESR, per the lever
    design/error_amp.md section 6 already named. error_amp.sch is untouched.
    * sim: re-record the DR-0001 loop-stability matrix against the Cff-compensated loop
    Full 3240-point PVT/load/cap/ESR sweep against the feedforward-compensated
    design/ldo_core.sch (record 20260801-140530-d6d47f5, supersedes
    20260801-050406-65416d2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
    [20260801-140530-d6d47f5-matrix.csv, ldo_core.sch]
2026-08-01 fix(error_amp): close the LDO loop-stability gap with a class-AB gate buffer and a Type-II gain-shelf Miller network (#56)
    * feat(error_amp): add a class-AB gate buffer and a Type-II gain-shelf Miller network
    The LDO loop was a two-pole system at every point of DR-0001's matrix: the
    amplifier's Miller-set dominant pole and the load-dependent output pole both
    sat decades below crossover, so the loop rolled off at -40 dB/dec through
    unity and the phase margin sat within a couple of degrees of zero (#42's
    record: worst PM -1.26 deg, 150/3240 points passing). No rescaling of the
    existing components fixes that -- with a plain Miller integrator, PM >= 45 deg
    at 50 mA / 0.33 uF needs an amplifier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
    [20260801-191742-84f67b8-matrix.csv, error_amp.sch, ldo_core.sch, summary.csv]
2026-08-01 spec/DR-0007: map the proposed envelope onto the record's full failure set (#57)
    Adds a "Coverage check" subsection to DR-0007 that walks the head-of-chain
    loop-stability record's 551 remaining failures
    (sim/loop-stability/records/20260801-191742-84f67b8.md) against the
    envelope this record proposes to claim (1 mA <= I_load <= 50 mA), so a
    ratification decision can be made against an explicit account.
    The two excluded columns are recorded as sitting on different footings,
    because they do:
    - 536 points at 0 mA are argued out of scope on the merits (the area and
    PSRR derivations already in this record independently rule the corner
    out for this topology). Intended to be permanent.
    - 15 po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
2026-08-02 feat(sim): add self-oscillation precondition check for loop stability, propose DR-0008 (#53) (#60)
    * sim/amp-selfosc: measure that the error amplifier's local Miller loop oscillates
    sim/loop-stability/'s phase and gain margins are a stability test only when
    the loop gain T(s) has no right-half-plane poles. design/error_amp.sch closes
    a local feedback loop inside the cell -- the Rz/Cc Miller network from N1
    around M2P and the class-AB gate buffer back to OUT -- and that loop stays
    closed when the LDO loop is broken at ERRAMP_OUT/PASS_GATE, so the
    precondition is a design property nothing in the repo measured.
    Measured, it does not hold. Add the experiment that measures it, the
    frequency-dom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
    [error_amp.sch]
2026-08-02 sim/loop-stability: detect gain resurgence above the first 0 dB crossing (#61)
    * sim/loop-stability: add a resurgence_db bar for gain above the first 0 dB crossing
    DR-0001's phase/gain margin is only a stability test when the loop gain has
    no right-half-plane poles, and nothing in this deck checked that precondition
    -- DR-0008 had to establish it out-of-band with sim/amp-selfosc/'s ~6
    CPU-minute-per-point transient bench. DR-0008 also found a cheap
    frequency-domain signature of the same failure that falls out of the AC sweep
    this bench already runs: |T| climbing back above 0 dB above its first 0 dB
    crossing.
    Measure it. `resurgence_db` is the largest |T| in dB anywhere above the first
    (fal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
    [20260802-044544-acfcdab-matrix.csv]
2026-08-02 fix(clamps): export error_amp's BG so soft-start and current-limit steer the class-AB buffer (#62)
    * fix(clamps): export error_amp's BG so soft-start and current-limit steer the class-AB buffer
    #51 replaced error_amp's class-A output stage -- whose SINK was a ~4 uA
    current source -- with a class-AB buffer whose sink is Mbuf, a 150 um/1 um
    PMOS source follower. design/ldo_softstart.sch and design/ldo_ilimit.sch both
    act on the regulator by pulling PASS_GATE up and were both sized against that
    4 uA number, so both lost the node: the soft-start ramp was bypassed outright
    (enable->1.764 V collapsed from milliseconds to tens of microseconds, peak
    startup current 141-366 mA, 63/63 corners over th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
    [20260802-023435-5ea33e8-matrix.csv, 20260802-071154-166834d-matrix.csv, 20260802-085331-8a1a9e8-delta.csv, error_amp.sch, ldo_core.sch, ldo_ilimit.sch, ldo_softstart.sch, summary.csv]
2026-08-02 fix(error_amp): Miller-split the Rz/Cc local loop to stop it oscillating (Part of #53) (#63)
    * fix(error_amp): stop the amplifier oscillating -- Miller-split the Rz/Cc local loop
    DR-0008 measured that design/error_amp.sch's Rz/Cc network is itself a
    feedback loop (N1 around M2P and the class-AB buffer, back to OUT) which
    stays closed when the LDO loop is broken for a Tian extraction, and that it
    has right-half-plane poles: 21-58 dB of gain peaking at 420-750 kHz with a
    +180 deg phase advance, and volts of peak-to-peak on a settled, undriven
    transient. While that holds, no Bode PM/GM read off sim/loop-stability/ is
    a stability claim at any load.
    The mechanism is two poles below a 813x forwa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
    [20260802-095235-c828e73-matrix.csv, error_amp.sch, summary.csv]
2026-08-02 docs(error_amp): record a negative result for the super-source-follower buffer sense device (Part of #53) (#64)
    DR-0009 named a super source follower around Mbuf as the first candidate
    to close the residual 48/540 phase-margin gap at 0.1 mA. Two variants were
    built and measured against design/error_amp.sch as committed at 0c04069:
    - Sense gate tied directly to OUT: real but plateauing PM improvement
    (32.37 -> ~37 deg at the worst target corner, never reaching the 45 deg
    bar) that also measurably eats into the PSRR row's last margin
    (gain_1k_db 53.13 dB vs the 53.5 dB floor at ss/125C/2.97V, a corner the
    narrower sizing sweep missed).
    - Sense gate AC-coupled from OUT and DC-reference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
2026-08-02 docs(error_amp): record a second negative result for the buffer sense device, with an isolated bias reference (Part of #53) (#65)
    DR-0010 left one variant of the super-source-follower sense device
    around Mbuf untried: a dedicated, diode-connected bias reference for
    the sense gate, isolated from NBIAS. Built and measured against
    97789aa -- it avoids the Iq blowup and the NBIAS signal leak DR-0010's
    two variants hit, but collapses the LDO loop's worst-corner phase/gain
    margin far past either of them (three of six checked points go
    negative on both bars). A control with the sense device disconnected
    from BG recovers baseline, isolating the cause to that connectivity
    itself, not the bias scheme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
2026-08-02 sim/loop-stability: add res_ff/res_ss to the process-corner axis (#66)
    * sim/loop-stability: add res_ff/res_ss to the process-corner axis
    Rz (ppolyf_u_1k) sets both the shelf gain and the shelf corner frequency of
    the loop's Type-II compensation since #51/#56, making it a first-order
    compensation parameter. sim/devchar/CONCLUSIONS.md S2 puts ppolyf_u_1k's
    process spread at ~40%, close to the ~17% margin the measured pass/fail
    boundary in Rz leaves, and this was previously unverified: the matrix held
    res_* sections at typical throughout.
    Follows sim/enable-shutdown/testbench/run.sh's existing
    CORNERS="tt ff ss fs sf res_ff res_ss" pattern. Expands the matrix from 45 to
    63 PVT points (3240 -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
    [20260802-151515-2a08fce-matrix.csv]
2026-08-02 fix(error_amp): widen the gain shelf to Cc/Cf so the 0.1 mA column passes 756/756 (#67)
    * sim/loop-stability: mint a clean-tree re-run of the 3240-point matrix (Part of #53)
    The head record 20260802-095235-c828e73 self-flags "DIRTY WORKING TREE at
    run time; not citable as a clean-tree result", which leaves the baseline
    issue #53 measures against formally uncitable under this repo's evidence
    standard ("sim/ results are append-only evidence").
    This is that run repeated with no design change and a clean tree, on the
    identical testbench and the identical committed netlist. It reproduces
    c828e73 exactly: 785/3240 passing, 0/3240 resurging, worst point
    sf_-40c_2.97v / 50mA / 0.33uF / 1mOhm at PM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
    [20260802-135744-931ec19-matrix.csv, 20260802-162533-628dbb3-matrix.csv, 20260802-171044-db620a6-matrix.csv, error_amp.sch, summary.csv]
2026-08-02 sim/loop-stability: raise AC_DEC to 400 with a stated resolvable-Q bound, and the A/B that says what it changed (#68)
    * sim/loop-stability: raise AC_DEC to 400, with a stated resolvable-Q bound
    `dec 50` (4.7% steps) resolves a resonance to within 1 dB only out to
    Q ~ 11. Above that the grid does not merely misreport a sharp feature, it
    can miss it entirely -- and `resurgence_db`, the DR-0008 precondition
    detector added by #59, is computed off that same grid, so the detector
    inherits the blindness of the sample it is computed from.
    Policy (issue #58, option 1 of the two it left live):
    miss(Q, dec) = 20*log10(sqrt((2*Q*(10^(1/(2*dec)) - 1))^2 + 1)) dB
    `AC_DEC` = 400 is the smallest x2 s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
    [20260802-201346-e912fbd-matrix.csv, 20260802-204343-e912fbd-delta.csv]
2026-08-02 fix: use a fixed 5% scan-start offset for resurgence_db, not a grid-tied one (#70)
    resurgence_db's scan used to start one AC-grid step (f0*10^(1/AC_DEC)) above
    the first 0 dB crossing, tying the metric's value to the sweep resolution
    even though the quantity it reports -- sup|T| over (f0, F_STOP] -- does not
    depend on resolution at all. Measured: raising AC_DEC 50 -> 400 on a
    byte-identical netlist moved resurgence_db at all 4536 matrix points by
    +0.061...+2.362 dB while phase margin and crossover barely moved.
    Replace the offset with a fixed f0*1.05, independent of AC_DEC, so the
    metric is comparable across records taken at different resolutions (median
    0.21 dB / max 0.95 dB residual measu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
    [test_loop_stability.py]
2026-08-04 docs: reconcile README status summary with the tree, fix a broken relative link (#74)
    README.md's opening summary claimed "no schematic, no layout, and no
    silicon," but design/ holds four xschem schematics for the full LDO
    hierarchy (core, error amp, current limit, soft start) with corner-swept
    simulation evidence, and layout/testcell/ is a DRC/LVS-clean physical
    verification flow (issue #14 / PR #45). Only "no silicon" was still true.
    The maturity-ladder line and layout/README.md already described the real
    state accurately; this reconciles the summary paragraph with them instead
    of rewriting either.
    Also fixes sim/harness/README.md's link to docs/environment-setup.md,
    which was missing a `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
2026-08-06 docs(dr): ratify DR-0008; hold DR-0007 on its evidence (#75)
    Operator ratification, issue #1:
    https://github.com/2AMLogic/gf180-ldo/issues/1#issuecomment-5199954200
    DR-0008 is ratified. DR-0001's PM/GM criterion now carries its own
    precondition — a Bode margin reading is only a stability claim when the
    loop gain has no right-half-plane poles — sim/amp-selfosc/ is the
    experiment that substantiates it, and
    sim/loop-stability/records/20260801-191742-84f67b8 may not be cited as a
    stability result at any load.
    It was ratified first because it makes the standard stricter rather than
    looser, and because it rests on its own measurement rather than on an
    argument. Deferring it would have meant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
2026-08-07 docs(dr): DR-0013 — the gain shelf must move, not widen, and moving it hits the same p2 ceiling (#77)
    * feat(error_amp): schedule Rz with the pass-gate sense so the shelf moves with load
    The Type-II gain shelf spans f_z = 1/(2*pi*Rz*Cc) to f_2 = 1/(2*pi*Rz*Cf).
    DR-0012 read the 1-50 mA gap as needing a ~9x WIDER shelf (Cc/Cf >~ 900) and
    showed both ends of that are blocked. But both shelf corners scale as 1/Rz
    and A_plat = gm(MIN)*Rz scales the crossover, so lowering Rz moves the shelf
    up and pulls f_c down at once: f_c/f_2 goes as Rz^2, and a factor k of Rz is
    worth k^2 of load range. The shelf does not have to get wider, it has to
    move.
    Rz cannot simply be smaller -- 0.1 mA / 4.7 uF th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
2026-08-08 feat(error_amp): land the adaptive shelf (Mrza/Rza), 1332/4536 -> 2930/4536, and add DR-0014/DR-0015 (#78)
    * feat(error_amp): make the gain shelf track the load with a triode replica across Rz
    The Type-II shelf's crossover f_c = beta*A_plat*gm_pass/(2*pi*C_eff) is
    proportional to gm_pass, which spans 63x across DR-0001's load axis while
    f_z, f_2 and the loop's -180 deg crossing stand still. Measured, the
    0.1 mA and 50 mA loop-gain curves are the SAME curve offset by 36 dB above
    30 kHz -- the loop is mis-placed at heavy load, not mis-shaped.
    Rz is the one component that moves A_plat, f_z and f_2 together, and
    scaling it by 1/sqrt(gm_pass) makes the phase margin load-invariant.
    Mrza is a pf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
    [20260807-103351-64249c6-matrix.csv, error_amp.sch, summary.csv]
2026-08-10 fix(loom): port judge-fallback-guard.sh to main, harden against missing guard (#80) (#81)
    PR #76 accumulated 93+ fallback-mode Judge comments over 3.5 days because
    main never had any dedup mechanism for the Judge's fallback queue —
    judge-fallback-guard.sh (bot exclusion, per-PR-lifetime cap, SHA dedup,
    velocity alert) exists only on the unmerged PR #76 branch. This ports the
    script and its wiring to main independently, so the fallback queue is
    bounded even though PR #76 itself hasn't merged yet.
    Also closes the gap PR #76's own version doesn't address: a missing or
    non-executable guard script is now explicitly checked for (`[ -x ... ]`)
    before invocation, rather than left to fall through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
2026-08-10 chore(repo-skills): update installed Repo Skills to 0.10.0
    Rolled straight to main rather than via a per-repo branch. The 0.8.1 rollout
    used branch-per-repo and seven of those branches were abandoned mid-flight,
    leaving their repos parked off trunk for days — and invisible, because
    compute-drift.sh's axis 3 compares a checkout against its OWN branch, so a
    repo current with a stale branch reports clean (2AMLogic/2am#209). An
    installed-tool refresh is mechanical, already-reviewed content, so a direct
    commit removes that abandonment failure mode entirely.
    This host's fleet spanned 0.6.1 to 0.8.1 before this pass, against a 0.10.0
    source — see 2AMLogic/2am#216.
2026-08-11 docs(spec): add DR-0016, the compensation Pareto front for cap x load range (#91)
    Maps the four candidate directions for the residual 1606/4536 loop-stability
    failures (narrow the cap spec, buffer bandwidth boost / Q-reduction, the 0 mA
    corner, and mode-switching) against coverage, area/Iq/PSRR cost, and required
    external-cap/ESR spec, each traced to a committed sim/ record or a named
    external reference. Recommends two zero-cost moves available today (narrow
    C_eff to 1 uF nominal with a 200 mOhm ESR floor; ratify DR-0007's 0 mA
    exclusion, now on DR-0008-satisfying evidence) and scopes the bandwidth-boost
    candidate as separate follow-up work rather than folding it in unverified.
    No design/ c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
2026-08-11 refactor(sim): dedup sweep.py's local git() helper against harness.report.git_provenance() (#93)
    sweep.py's local git() called git four times to reconstruct the same
    {commit, short, branch, dirty} tuple harness.report.git_provenance()
    already returns in one call, with no OSError guard of its own. Fetch
    provenance once in main() and thread it into render_record() instead.
    Closes #92
2026-08-16 refactor(sim): dedup loop-stability sweep.py's record_id allocation against harness.report.allocate_record_id() (#109)
    Replace the hand-rolled record-id minting + same-second-collision-abort
    block in sweep.py with the shared, tested allocate_record_id() /
    format_record_id() helpers from harness/report.py (already used by
    harness/cli.py and covered by sim/tests/test_harness.py). This also
    improves behavior: a same-second id collision now retries with an
    advanced timestamp instead of printing FATAL and aborting the whole
    sweep matrix.
2026-08-16 sim: refresh 1 mA PSRR evidence and add the 50 mA full-load sweep (#112)
    * sim: add psrr-vs-freq-50ma, the full-load half of the ratified PSRR row
    The PSRR row is specified at two load conditions (1 mA binding light load
    and 50 mA full load), but only the 1 mA condition was automated: the two DC
    bias points cannot share one deck because ngspice's per-.meas result vectors
    go out of scope as soon as a later analysis becomes the current plot, so an
    "alter"-and-re-.ac deck silently re-reports the first .ac's numbers.
    Add the 50 mA condition as its own experiment slug -- the pattern
    sim/dropout-vs-load/ already uses for its fixed full-load point. Same DUT,
    same AC stimulus and output network, s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
2026-08-16 sim: refresh current-limit + thermal corner sweep against post-Mrza/Rza netlist (#115)
    Mints a fresh sim/current-limit/records/20260816-080440-8e105a0.md whose
    DUT netlist sha256 matches current design/netlist/ldo_core.spice (the
    superseded 20260802-105338-c828e73 record's sha predated PR #78/DR-0015).
    Full 63-point PVT matrix, both verdicts still FAIL against the ratified
    bounds -- 36/63 corners outside the 65-80 mA current-limit window and
    12/63 exceeding the 290 mW thermal bound -- with zero corners changing
    classification relative to the stale record (a DC/quasi-static sweep is
    unaffected by the AC-domain Mrza/Rza compensation change).
    Closes #100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
    [summary.csv]
2026-08-16 refactor(sim): remove sweep.py's resolve_pdk() wrapper around harness.pdk.find_pdk (#116)
    The wrapper's justifying comment claimed it deferred an import that
    'needs sys.path', but sys.path.insert() already runs at module load
    time well before resolve_pdk was defined, and three other harness.*
    imports already happen at top level with no deferral. Hoist find_pdk
    to the top-level harness import block and call it directly at the one
    call site.
2026-08-16 sim(startup): mint fresh 81-point settling record against current DUT sha (#118)
    Adds sim/startup/records/20260816-100018-af4d1f9.md, superseding the stale
    20260802-105330-c828e73 record. That record was taken on a dirty tree at
    c828e73 with DUT netlist sha b47779a9..., which predates PR #78 (DR-0015,
    the Mrza/Rza adaptive-compensation shelf in design/error_amp.sch). The new
    record's DUT netlist sha256 3aeb2259... matches the current
    design/netlist/ldo_core.spice, and the run is clean-tree.
    Full 81-point PVT matrix (9 process corners x 3 temperatures x 3 supplies),
    81/81 completed, no subset.
    Verdict against the ratified <=3 ms startup settling bound (README.md
    'Startup' row / DR-0004 amen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
2026-08-16 sim: mint fresh dropout-vs-load record against post-Mrza/Rza netlist (#120)
    Re-runs the dropout-vs-load corner sweep (python3 sim/run_corners.py
    dropout-vs-load --corner-set full) against current main so the record's
    DUT netlist sha256 matches design/netlist/ldo_core.spice again -- the
    superseded 20260802-164148-de1161d record's sha predated PR #78/DR-0015's
    Mrza/Rza adaptive-compensation shelf.
    Expands the corner set from the prior mos-only 15-point grid to the full
    27-point grid (adds res_ff/res_ss/bjt_ff/bjt_ss). Still FAIL 27/27 against
    the ratified <300 mV @ Vin=2.10V bound, with the same sub-mV margin as
    before: worst corner is res_ff_125c_2.10v at 301.014 mV, 1.014 mV over.
    Zero corn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
2026-08-16 sim: add regeneratable characterization report (T1 checklist item 8) (#122)
    Adds sim/build_characterization_report.py, which reads every ratified
    README.md spec row, maps it to the sim/<slug>/records/ evidence that
    substantiates it, extracts each record's own stated verdict, and checks
    freshness by testing whether the record's frozen netlist snapshot still
    contains the current design/netlist/{ldo_core,error_amp}.spice content
    verbatim -- the same test #95's manual freshness audit applied by hand,
    now mechanical and regeneratable rather than a one-off comment. Output is
    committed at sim/CHARACTERIZATION.md; README.md links to it.
    Closes #104
2026-08-16 sim: refresh line/load regulation evidence against post-Mrza/Rza netlist (#121)
    * sim: refresh line- and load-regulation evidence at the full 9-corner PVT matrix
    PR #78 (DR-0015) landed the Mrza/Rza adaptive-compensation shelf in
    design/error_amp.sch, changing design/netlist/ldo_core.spice's hash. The
    prior line-regulation (20260801-114433-89f0528) and load-regulation
    (20260801-114250-89f0528) records were run against the pre-Mrza/Rza
    netlist and are stale per sim/README.md's append-only-evidence convention.
    Re-ran both against current main with --corner-set full (the 9-corner
    tt/ff/ss/fs/sf/res_ff/res_ss/bjt_ff/bjt_ss process axis, not just mos):
    - line-regulation: 27/27 points PASS, max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
2026-08-16 chore(devchar): remove dead dc_ngspice_version() helper (#124)
    dc_ngspice_version() in sim/devchar/lib/devchar.sh was defined but never
    called by any of the three devchar drivers (fets/caps/resistors run.sh)
    or anywhere else in the repo. Provenance is hand-typed in
    sim/devchar/README.md instead. Distinct from the used
    sim/harness/runner.py:ngspice_version(), which is untouched.
    Closes #119
2026-08-16 sim: guard sweep.py's record write against overwriting (#113) (#125)
    `sim/loop-stability/testbench/sweep.py` minted its record-id before the
    63-point ngspice sweep and spent it at the end with an unguarded
    `(records / f"{record_id}.md").write_text(md)`. `allocate_record_id()`
    only guarantees an id is free at allocation time, so two runs started
    around the same time on the same commit both saw the id as free and
    whichever finished second silently clobbered the first's append-only
    record.
    Extract `write_record()`'s existence-check tail in `sim/harness/report.py`
    into `reserve_record_path()` (mkdir + `path.exists()` -> `RecordExists`)
    and a `write_markdown_record(record_id, text, records_dir)`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
    [test_harness.py, test_loop_stability.py]
2026-08-16 sim: re-run Monte Carlo output-accuracy sweep against the current DUT netlist (#126)
    The mc-output-accuracy record 20260801-030232-969e423 was taken against
    `design/netlist/ldo_core.spice` sha256 0245314b..., which #95's T1/bronze
    re-read identified as the pre-#11 ldo_core -- five landings behind main:
    Cff (#42), Xilimit (#11), Xsoftstart (#38), and the Mrza/Rza adaptive
    shelf (DR-0015, #78). That made checklist item 6 ("statistical claims
    carry Monte Carlo evidence") a stale PASS, and left the "Output accuracy
    +/-2%" row of item 5's spec-row table pointing at it.
    Re-ran the sweep unchanged against current main -- same methodology, same
    sample count, same negative controls:
    python3 sim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
2026-08-18 chore(tooling): complete the stranded Loom resync, 0.16.0→0.18.13
    gf180-ldo was the only canary repo left behind: install-metadata recorded
    loom_version 0.16.0 with last_resync and installed_at both null, while the
    other fourteen sit at 0.18.13 resynced 2026-08-10.
    The cause was a partially-applied resync, not a missing one. resync-installed.sh
    is part of the payload it updates, so the copy that starts a run is the old one;
    going 0.16.0 -> 0.18.x the stale copy dies partway (`verb_past: unbound
    variable`) after it has already written the newer script to disk. That left 181
    modified files under .loom/ and an un-restamped metadata file — the repo looked
    untouched by version while being ha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
2026-08-18 chore(loom): refresh resync-installed.sh output to loom 0.18.96 (#76)
    Champion routed PR #76 (chore(loom): resync installed surfaces) back to
    Doctor because it was 17 commits stale and Loom's own tooling had since
    moved on further (0.18.0 -> 0.18.96). This regenerates the resync diff
    against the current source tree so the PR reflects up-to-date managed
    surfaces (.loom/hooks, .loom/scripts, .loom/roles, .loom/docs, .loom/bin,
    .claude/commands/loom, .github/CONFIGURATION.md, .gitignore).
    Guard hooks changed in this refresh (guard-destructive-generic.sh,
    guard-background-subagents.sh, guard-destructive.sh, guard-loom-workflow.sh,
    guard-worktree-paths.sh, new guard-codex-bridge.sh) are exactly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
2026-08-19 fix(loom): replace hand-rolled .gitignore parser in random-file.sh with git ls-files (#130)
    random-file.sh's custom .gitignore parser had two independent bugs: its
    directory-pattern regex branch (gitignore_to_regex, for patterns like
    "sim/.work/") never matched top-level paths, only nested ones, so gitignored
    scratch directories leaked into the sampler; and filter_by_gitignore silently
    skipped "!"-negation lines while DEFAULT_EXCLUDES hardcoded "*.log"
    unconditionally, hiding the ~4,990 sim/*/corners/**/*.log files this repo's
    .gitignore deliberately un-ignores as append-only simulation evidence.
    Replace both with `git ls-files --cached --others --exclude-standard` as the
    base candidate fil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
2026-08-20 fix(loom): restore git-native gitignore handling in random-file.sh (#135)
    A later 'resync installed Loom surfaces' commit (970a5c4) silently reverted
    PR #130's fix, reinstating the hand-rolled gitignore_to_regex()/
    filter_by_gitignore() parser and a hardcoded *.log default-exclude. Both
    original bugs were live again on main: sim/.work/ (gitignored scratch)
    could leak through as a sampled candidate, and !sim/*/corners/**/*.log
    (negated evidence logs) were silently dropped again.
    Reapply PR #130's fix verbatim (commit 395cb25): replace the hand-rolled
    parser with git_candidate_files(), using
    'git ls-files --cached --others --exclude-standard' (and drop fd's
    --no-ignore-vcs), so nested .gitign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
2026-08-21 layout: reuse harness.report's append-only write guard for --record (#143)
    layout/drclvs.py's write_record() wrote its rendered run record via a
    hand-rolled mkdir/write_text with no check that the target path already
    existed. Because record ids are allocated well before the write (after
    DRC, LVS, and both negative controls), a concurrent --record run could
    mint and spend the same id first, and this code would silently
    overwrite it -- violating the project's append-only evidence invariant.
    Switch to harness.report.write_markdown_record(), which re-checks for
    a collision immediately before writing and raises RecordExists instead
    of overwriting (the same guard sim/harness already uses). Surfac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
2026-08-21 docs(dr): DR-0017 -- Cc->BG + a Cf step is a wash once Mrza/Rza is already shipped (#145)
    Issue #51 was un-parked to execute DR-0014/DR-0015's named next increment
    (move Cc's return node from OUT to BG, then re-measure Cf's floor). Run
    against the *shipped* topology (Mrza/Rza already in the loop, not the
    fixed-Rz topology DR-0014 measured Cc->BG against in isolation), the move
    does not reproduce DR-0014's per-net improvement:
    - Cc->BG alone: 2821/4536 (was 2930/4536), worst PM -6.81 -> -4.37 deg.
    Every load column from 0.1 mA up loses points; the worst corner improves.
    - Cc->BG + a full Cf step (7x7um -> 6x6um MIM): 2843/4536, worst PM
    -4.33 deg -- a full step of Cf buys 22 points and f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
2026-08-21 docs(dr): DR-0018 -- propose closing #51's residual gap via DR-0016's spec-decision candidates, not a further circuit change (#148)
    DR-0017 (this issue) confirmed the compensation-network-tuning path is
    exhausted at the shipped operating point (Cc->BG, a Cf step, and an Rza
    re-tune are each a wash or worse once Mrza/Rza is already shipped). The
    only remaining in-silicon lever -- raising the buffer's standing current
    to buy f_hi -- needs a verification chain (81-point amp-openloop, 81-point
    psrr-dc, 45-point amp-selfosc, and a full 4536-point loop-stability
    matrix) this session's shared host cannot responsibly complete: a single
    72-point single-PVT --explore screen did not finish in 8 minutes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
2026-08-21 docs(dr): DR-0019 -- buffer standing-current lever is blocked by amp-openloop's own iq_ua allocation (#150)
    Issue #147 asked for the buffer-standing-current lever DR-0015 named ("buy
    f_hi") to actually be built and measured. Building it (Mbuf/Mbufb gate-width
    increases, two sizes tried) finds a tighter, previously-unchecked Iq
    constraint: sim/amp-openloop's own iq_ua <= 15 uA row (an internal amp-only
    allocation from spec/architecture-survey.md S5, distinct from the ratified
    whole-regulator 30 uA row DR-0015/DR-0016/DR-0018 quoted headroom against)
    already sits at 14.9784/15.0 uA in the shipped baseline -- 0.0216 uA of
    margin. Even the smallest step tried (+17-20% gate width) overruns that r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
2026-08-22 refactor: reuse harness.corners.CORNERS for corner_sections() in three testbench run.sh (#152)
    Removes the byte-for-byte duplicated corner_sections() case statement from
    sim/current-limit, sim/enable-shutdown, and sim/soft-start's testbench/run.sh
    scripts. Each now generates the function once, up front (a single python3
    subprocess importing harness.corners.CORNERS, mirroring the existing
    PDK_INFO discovery block), rather than shelling out per PVT point inside the
    parallel xargs fan-out. Function signature, call sites, and the
    FATAL-on-unknown-corner behavior are unchanged.
    Closes #151
2026-08-22 refactor: reuse tool_version() for xschem version probe in drclvs.py (#154)
    Remove the standalone xschem_version() helper in layout/drclvs.py and
    replace its 3 call sites with the generic tool_version('xschem',
    ['--version']) helper already used for klayout and klt in the same
    record table -- both produce byte-identical output.
2026-08-22 refactor: reuse harness.runner.ngspice_version() in 4 testbench run.sh scripts (#156)
    Removes the hand-rolled `ngspice -v | sed ...` version probe and the separate
    `command -v ngspice` guard from sim/current-limit, sim/enable-shutdown,
    sim/soft-start, and sim/op-point-sanity's run.sh, each of which duplicated
    the same sed pattern already implemented once in
    sim/harness/runner.py:ngspice_version(). The short "ngspice-NN" token each
    script prints is now derived from the existing PDK_INFO python heredoc
    (ngspice_version().split()[0]) rather than a separate shell-out, and each
    script now gets NgspiceMissing's actionable install-instructions message in
    place of the bare command-v guard.
    Co-autho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
2026-08-22 refactor: extract current-limit/enable-shutdown rollup heredocs into summarize.py (#159)
    Moves the ~70-line inline Python rollup heredoc out of each testbench's
    run.sh into a standalone summarize.py, mirroring the pattern already used
    by sim/soft-start/testbench/summarize.py. The rollup logic is unchanged
    (verified byte-identical summary.csv and stdout report against the prior
    inline heredoc for both benches), but it is now independently runnable
    against committed logs without re-invoking ngspice, and visible to
    ordinary Python tooling.
2026-08-22 refactor: consolidate PVT-log read/rep/flag helpers into sim/harness/pvt_log.py (#162)
    current-limit, enable-shutdown, and soft-start's summarize.py scripts each
    reimplemented the same per-corner ngspice log parse/rollup pipeline, and the
    three copies had already drifted: current-limit's parser raised an uncaught
    ValueError traceback on a malformed measurement instead of a FATAL: message,
    while enable-shutdown/soft-start silently swallowed the same error, and
    enable-shutdown's flag() lacked soft-start's >6-item truncation.
    Add sim/harness/pvt_log.py with one canonical read_measurements()
    (fail-loud, not swallowing), report_minmax() (soft-start's generalized
    rep(), parameterized so each test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
    [summarize.py, test_harness.py]
2026-08-24 fix(sim): measure dropout at the regulation knee, not regulation error (#140)
    * fix(sim): measure dropout at the regulation knee, not Vin-Vout at a pinned Vin
    The dropout-vs-load manifest solved one .op at Vin = 2.10 V and reported
    vdrop_mv = (v(vin) - v(vout))*1e3. The ratified binding test point is
    Vout_nom plus the ratified bound exactly (2.10 = 1.800 + 0.300), so while
    the loop is in regulation that expression is identically
    300 mV + (1.800 V - Vout)
    i.e. the DC regulation error offset by the bound, not dropout. It can read
    below 300 mV only if Vout sits above its own setpoint, which a negative
    feedback loop with finite DC gain cannot do -- hence 27/27 corners FAILing
    by 0.476-1.0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
    [test_harness.py]
2026-08-24 ratification: install the two-key reviewer variant (EE key + market key) (#136)
    Phase C2 of 2AMLogic/2am#372. Both keys are generated public variants —
    ee-key/ and market-key/ each produced by its owning repo's
    generate-canary-variant.py (lint clean; MANIFEST.md records the source
    commit) — scoped to this repo's block class (ldo). Identifier-scanned
    against the operator-populated pattern file before push (2am#386 / #391).
2026-08-27 ratification: fix inaccurate market-key MANIFEST.md comp-data list (#172)
    The section listed all 4 original COMP_CLASSES entries
    (ldo, pll, sar-adc, bandgap) instead of the single comp file this repo
    actually carries in ratification/market-key/comps/ — the installer
    committed generate-canary-variant.py's raw output instead of hand-scoping
    it per canary-variant.md's install procedure.
    Not a disclosure leak (every listed filename names another public
    canary's own block class); a documentation-accuracy fix only.
    Part of 2AMLogic/2am#589
2026-09-05 docs: add Chipalooza Challenge #5 proposal, 3.3V-only per DR-0002 (#175)
    Writes docs/chipalooza/challenge-5-proposal.md: block type, I/O mapped to
    the Challenge #5 slot budget, functional description, a target-spec table
    re-derived from sim/CHARACTERIZATION.md with every row's met/unmet status
    and citation, and a bench test plan. States the rail-scope decision
    explicitly (3.3V-only, per DR-0002's default -- no decision record scopes
    in the 5.0V analog rail) and discloses two open gaps found while writing
    the document: no GDS exists yet (layout split into a blocked follow-up,
    since it is gated on #15/#51's floorplan/stability chain), and VREF is an
    internal ideal source rather than a top-leve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
2026-09-05 feat(champion): standing authorization for design-evidence auto-merge (#6850)
    Operator ruling 2026-09-05: Judge-approved, green-CI PRs whose entire
    changed-file set lives in design/, sim/, layout/, measurements/,
    verification/, or docs/ auto-merge without the four-axis human hold.
    Rationale: canary design evidence is fully revertible with no fleet-infra
    blast radius, and the held-PR pattern (sky130-sar-adc#123 sat mergeable for
    days as the sole blocker of a layout chain) costs more than it protects
    here. spec/ and every tool surface fall outside the patterns, so the
    exact-subset rule keeps them on the four-axis judgment automatically.
    C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
2026-09-06 feat(design): promote VREF to a top-level ldo_core port, re-run PVT suite (DR-0021) (#179)
    * feat(design): promote VREF to a top-level ldo_core port (DR-0021)
    VREF was an internal net driven by Vref1, an ideal 1.2 V vsource
    instantiated inside the ldo_core subcircuit, so there was no top-level net
    for the Chipalooza Challenge #5 harness's bandgap-referenced bias-voltage
    slot to attach to. Append VREF as ldo_core's seventh port, delete the
    in-cell source, and move the identical ideal source into each of the 15
    testbench decks (43 instantiations).
    Appended rather than inserted, per the convention #11 used for error_amp's
    EN and #55 for its BG: the first six positions are unchanged, so a stal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
    [ldo_core.sch, summary.csv]
2026-09-06 sim(soft-start): bisect the DR-0015 shelf and mint fresh Startup evidence (#177) (#180)
    The last substantive characterization of this bench's inrush / overshoot /
    peak-supply / settled-ripple sub-clauses was 20260802-023437-5ea33e8
    (2026-08-02), which predates PR #78 / DR-0015 (1970aea, 2026-08-08) -- the
    Mrza/Rza adaptive-compensation shelf. That record attributes its own FAILs
    to a settled-state limit cycle, i.e. to exactly what DR-0015 was landed to
    remove, so it was very likely obsolete-FAIL. #174's re-run observed the
    improvement but deliberately did not attribute it.
    This does the controlled bisection #98 did for load-transient. Both arms are
    the same unchanged 163-point testbench, sa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
    [summary.csv]
2026-09-06 sim(vref-transfer): mint VREF-to-VOUT transfer evidence and derive the reference accuracy-class budget (#178) (#181)
    Adds the reference-referred characterization campaign DR-0021's contract
    table named as unresolved: a new .ac testbench pair (sim/vref-transfer/,
    sim/vref-transfer-50ma/) drives the VREF port directly and measures the
    small-signal transfer to VOUT at light (1 mA) and full (50 mA) load, across
    a compute-bounded PVT subset disclosed in each record's Justification field
    (this shared host was concurrently running another issue's sweep). The
    measured transfer (~1.5x at DC/tempco frequencies, matching DR-0003's
    1/beta estimate to <0.3%) is used in sim/vref-transfer/README.md to deri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
2026-09-06 sim(loop-stability): full 4536-point re-run against the seven-port ldo_core (post-#174/DR-0021) (#183)
    Mints record 20260906-071437-fff0bf0, the full ratified matrix against the
    current seven-port ldo_core.spice (VREF a top-level port per DR-0021),
    superseding the pre-#174 baseline (20260807-103351-64249c6). Overall verdict
    is unchanged (FAIL, tracked separately by #42): 2929/4536 pass vs 2930/4536
    previously, a net -1 that a point-by-point diff (record 20260906-072922-fff0bf0)
    traces entirely to a small cross-invocation numerical drift at 5 points
    already sitting within ~1.2 deg of the 45 deg phase-margin bar -- not to the
    VREF promotion. A control experiment (re-simulating the largest move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
    [20260906-071437-fff0bf0-matrix.csv, 20260906-072922-fff0bf0-delta.csv]
2026-09-06 sim(loop-stability): root-cause the cross-invocation PM/GM drift as a toolchain-identity gap (#182) (#185)
    Root cause: the self-reported `ngspice --version` banner is not a content
    fingerprint. On one host, two independently-built `ngspice-46` binaries
    were found coexisting with different sha256 hashes but the identical
    banner, and re-running the isolated control point 28 times (with and
    without thread pinning / heavy background load) against either local
    binary reproduced only the original pre-drift value, never the "moved"
    one another evidence-gathering pass reported for the same command the
    same day. The gf180mcu PDK content itself is verified unmoved since
    before the baseline, and the sw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
    [test_harness.py]
2026-09-06 fix: enforce ngspice toolchain identity in --check-env, not just presence (#184) (#186)
    Issue #182 found ngspice-46 resolving to genuinely different, uncoordinated
    binaries across hosts (and a self-built one silently shadowing the
    Homebrew install docs/environment-setup.md pins, ahead of it on PATH), with
    nothing catching the mismatch -- the sha256 fingerprint #182 landed makes
    drift detectable after the fact, but does not stop it. Harden
    `sim/run_corners.py --check-env` to verify the PATH-resolved ngspice
    actually lives under the pinned toolchain root (Homebrew's, via
    `brew --prefix ngspice`, or an explicit GF180_LDO_NGSPICE_ROOT override for
    hosts this doc's Homebrew rule doesn't cover) an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
    [test_harness.py]
2026-09-06 sim(soft-start): damp the clamp loop's acquisition transient with a nulling resistor (Rz_ss) (#43) (#188)
    * design(soft-start): damp the clamp loop with a nulling resistor (Rz_ss) (#43)
    The soft-start clamp on PASS_GATE is a feedback loop that closes through
    the output node, so its loop gain carries the output pole
    (1/(2*pi*Rload*C_eff) = 0.94 kHz at 4.7 uF into 36 ohm) as well as the
    pole Rl2_ss sets at CLG (~3.6 kHz with #38's bare 7.2 pF Miller cap).
    Two poles within a decade, plus a bare Miller cap's RHP zero, is a badly
    damped loop -- and it shows up as a large-signal overshoot the first time
    the loop has to acquire.
    Measured at ff/-40 C/2.97 V, 4.7 uF/500 mOhm, 50 mA: the clamp reach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
    [ldo_softstart.sch, summary.csv]
2026-09-06 spec(soft-start): DR-0022 — the current-limit-clearance clause narrows above 1 µF, not 4.7 µF (#190)
    Issue #187 found the Startup row's current-limit-clearance sub-clause
    still failing at the top of DR-0001's capacitor window (51.7-53.8 mA
    against a 52 mA ceiling, both ESR arms) even after #43's Rz_ss fix
    closed inrush everywhere else. This record shows the failure is
    arithmetic, not dynamics: a linear regression of the committed
    4.7 uF/500 mOhm group (R^2 ~= 0.95) shows isup_peak_ma tracks the
    ramp's own steady rate almost exactly, and no re-centring of the
    single global ramp rate can satisfy the clearance clause at 4.7 uF
    without pushing t_startup's worst corner past double DR-0006's o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
2026-09-06 sim(soft-start): FB injection replaces the clamp comparator; the 4.7 uF inrush clause closes (#189) (#192)
    * wip(soft-start): FB injection replaces the PASS_GATE clamp comparator (#189)
    * sim(soft-start): FB injection replaces the clamp comparator; 4.7 uF inrush closes (#189)
    Issue #43 closed the ratified 5 mA inrush clause everywhere in DR-0001's
    capacitor window except the two 4.7 uF groups, by damping the soft-start
    clamp loop's acquisition transient with a nulling resistor whose usable band
    had no headroom left. This rebuilds the cell around issue #189's premise: the
    acquisition transient is not a damping problem but an architecture one -- the
    clamp is a second feedback loop that has t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
    [ldo_softstart.sch, summary.csv]
2026-09-06 sim(harness): dedup run_point() across current-limit/enable-shutdown/soft-start (#194)
    * sim(harness): dedup run_point() across current-limit/enable-shutdown/soft-start
    The per-corner "substitute deck template, run ngspice, check for fatal
    log lines" body had drifted into three near-identical copies (current-
    limit and enable-shutdown were byte-identical apart from the template
    filename; soft-start's added a cap/ESR/Rload extension). Extract it into
    sim/harness/lib/run_point.sh's harness_run_point(), following
    sim/devchar/lib/devchar.sh's dc_run() KEY=VALUE substitution convention,
    and have each testbench's local run_point() wrapper (still exported for
    the xargs -P fan-out) compute its own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
2026-09-06 soft-start(#191): device-level FB transconductor replaces Binj_ss, but destabilizes the hold-release transient across most of the PVT matrix (#195)
    Replaces #189's ideal Binj_ss behavioural source with the device-level
    transconductor #189 already named as the intended implementation (two
    VIN-referenced, resistor-degenerated PMOS branches differenced in a
    diode-connected PMOS, mirrored into FB). Fixes two real bugs found in an
    interrupted prior session's working tree: Rgma_ss/Rgmb_ss at 145k instead
    of the required 200k (=Rtop||Rbot), and an abandoned, undocumented
    four-device extension to the topology. Also fixes a genuine bug in the
    simple topology itself: Mgma_ss/Mgmb_ss had body=VIN despi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
    [ldo_softstart.sch]
2026-09-10 sim: soft-start hand-over loop-gain characterization, and the compensation recommendation for #191 (#197)
    * sim: add the soft-start loop-gain testbench (issue #196)
    Stands up sim/soft-start-loop-gain/: the Tian dual-injection loop-gain deck
    from sim/loop-stability/, with design/ldo_softstart.sch's FB-injection element
    in the loop and the soft-start ramp node SSR pinned, so the hand-over states
    #191's regression is about can be measured in the frequency domain.
    - tb_ss_loop_gain.spice.in: the deck. Extraction idioms are loop-stability's
    character for character; new are the SSR pin, the two load models and the
    landed FB/SSR/supply-current reporting the ramp-state landing rule needs.
    - ne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
    [20260910-015601-2387ece-handover.csv, 20260910-015601-2387ece-matrix.csv, ldo_softstart.sch]
2026-09-13 Dedup op-point-sanity's run_point() onto harness_run_point() (#205)
    sim/op-point-sanity/testbench/run.sh inlined its own copy of the
    "substitute deck template, run ngspice, check the log for fatal lines"
    body that issue #193 / PR #194 extracted into
    sim/harness/lib/run_point.sh for the current-limit, enable-shutdown and
    soft-start testbenches. #193 scoped this script out because run_point()
    as a whole is a different shape (single hardcoded nominal point, exits
    rather than returns, parses measurements the others don't) -- but the
    substitute/run/fatal-check sub-body is not different at all, and
    harness_run_point() takes an arbitrary KEY=VALUE list, so the hardcoded
    typical/27C/3.3V tokens pass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
2026-09-13 sim(harness): dedup PDK-discovery and corner_sections() codegen (#207) (#208)
    The PDK/ngspice-discovery python heredoc + sed parsing, and the
    corner_sections() python-codegen heredoc, were each hand-copied
    byte-identically into enable-shutdown/current-limit/soft-start's
    run.sh (and op-point-sanity's run.sh for the PDK-discovery block),
    the same drift pattern issue #193 already fixed once for the
    substitute/run/fatal-check body (sim/harness/lib/run_point.sh).
    Extract both into sim/harness/lib/pdk_discover.sh
    (harness_discover_pdk()) and sim/harness/lib/corner_sections.sh
    (harness_load_corner_sections()), sourced and called from all four
    run.sh scripts in place of the inlined heredocs. op-poi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
2026-09-14 spec: propose ratifying DR-0006's 6 ms startup settling window (#127)
    Canary of the ratification-via-PR policy (2AMLogic/2am#357, 2026-08-19
    operator ruling): this PR drafts DR-0006's status flip from proposed to
    ratified on the evidence, and the operator's approval of this PR is the
    ratification act, not a separate comment.
    - DR-0006: cites the fresh, DUT-matching, 81-point record
    sim/startup/records/20260816-100018-af4d1f9.md (issue #101 / PR #118) as
    the settling-clause evidence of record, superseding the stale 163-point
    soft-start bracket it originally cited. Worst measured point moves from
    5.88 ms to 5.82788 ms (ss_-40c_3.63v) -- a ~1% change from corner-set/
    C_eff difference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
2026-09-14 refactor(sim): consolidate current-limit/enable-shutdown run_point() into harness_run_pvt_point (#213)
    sim/harness/lib/run_point.sh already held the shared low-level
    substitute/run/fatal-check body (issue #193). The per-experiment
    run_point() wrapper on top of it -- corner_sections lookup, corner_id/
    deck/log formatting, then the harness_run_point call -- was byte-
    identical between sim/current-limit/testbench/run.sh and
    sim/enable-shutdown/testbench/run.sh, differing only in the deck
    template path.
    Lift that wrapper into a new harness_run_pvt_point() in
    sim/harness/lib/run_point.sh, parameterized by the template path, and
    replace both run_point() bodies with a one-line call into it.
    sim/so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
2026-09-15 spec: propose DR-0023, cascode the soft-start injection mirror (#215)
    * spec: propose DR-0023, cascode the soft-start injection mirror
    Part of #191. Drafts a decision record recommending cascoding Mgmo_ss
    against Mgmr_ss to eliminate the measured 0.95-1.61 V drain-voltage
    mismatch that #196/PR #197's loop-gain record isolated as the root
    cause of #191's inrush/settled-accuracy regression, over restoring an
    output-side clamp. States the Iq/area cost against the ratified rows,
    citing sim/quiescent-current and sim/soft-start-loop-gain evidence.
    No schematic edit -- the device-level implementation is separate
    follow-on work gated on this record being ratified.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
2026-09-15 spec: propose ratifying DR-0018's narrowed Stability envelope + DR-0007 hold-condition note (#199)
    Drafts DR-0018's ratification as a pull request (ratification-via-PR
    policy, 2AMLogic/2am#357), the same mechanism used for DR-0005 (PR #137)
    and DR-0006 (PR #127) and the one issue #149's closing ruling names as
    the correct next step for this exact decision.
    Re-verifies DR-0018's cited counts against the current head
    loop-stability record (sim/loop-stability/records/20260906-071437-fff0bf0,
    which supersedes the 20260807-103351-64249c6 record DR-0018 originally
    cites, per issue #15's 2026-09-07 re-check): the narrowed 0.1-50 mA /
    C_eff = 1 uF / ESR >= 200 mOhm envelope reproduces exactly (630/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
2026-09-15 spec: propose ratifying DR-0005's 62-95 mA current-limit window (#137)
    Drafts DR-0005's ratification as a pull request (ratification-via-PR
    policy, 2AMLogic/2am#357), re-deriving the proposal against the fresh
    current-limit/thermal record (sim/current-limit/records/20260816-080440-8e105a0.md,
    issue #100/PR #115) instead of DR-0005's original stale citation.
    The verdict is unchanged (36/63 corners outside 65-80 mA, worst thermal
    345.215 mW at ff_125c_3.63v) but the fresh measurement corrects the
    proposed thermal ceiling: 95 mA x 3.63 V arithmetic gives ~345 mW, which
    undershoots the measured worst-case short-circuit dissipation
    (345.215 mW) by 0.2 mW. Corrects the proposed ceiling to 346 mW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
2026-09-15 sim: regenerate CHARACTERIZATION.md and add CI staleness check (#218)
    sim/CHARACTERIZATION.md had drifted from main's own design/netlist/
    (stale ldo_core.spice sha, missing recently-landed quiescent-current and
    soft-start records) since only the note-8/note-9 target text was
    re-pointed during PR #137's rebase, without a full regeneration.
    Regenerated via `python3 sim/build_characterization_report.py`:
    - ldo_core.spice sha updated to the current netlist
    - all rows now correctly flagged STALE against the new netlist sha until
    their records are re-run
    - Iq flips PASS -> FAIL and Startup/soft-start pick up newer records,
    reflecting evidence that landed after the last regeneration
    - Current-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
2026-09-15 spec: propose 1 uF startup-current budget + ~5x soft-start resize (DR-0024) (#223)
    * spec: propose restating the Startup row as a 1 uF startup-current budget, resize soft-start ramp ~5x (DR-0024)
    Issue #212 (operator-requested follow-up to PR #127's market-key
    escalation on DR-0006) finds the 60x startup-speed gap against TI's
    TLV774/TLV700 is a spec-anchor choice, not process or topology: this
    design bounds the soft-start ramp/inrush at DR-0001's 4.7 uF capacitor
    ceiling and a worst-case PVT corner, while TI bounds inrush loosely and
    quotes a typical figure at 1 uF.
    DR-0024 (proposed, not ratified -- ratification is a human PR merge per
    CLAUDE.md's spec-change policy) restates the ramp, i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
    [ldo_softstart.sch, summary.csv]
2026-09-15 spec: pin gf180mcu model-bin selection in the deck and root-cause it (DR-0025) (#222)
    * spec: root-cause gf180mcu model-bin selection and pin it in the deck (DR-0024)
    `design/netlist/ldo_core.spice`'s pass device (`pfet_03v3 W=2000u nf=40`)
    requests a width 20x above the widest declared `pfet_03v3` bin's `wmax`
    (100.001 um). Issue #214 asked what bin every committed `sim/` record
    actually simulated it against, and whether DR-0006's just-ratified 6 ms
    startup bound rests on the wrong device model.
    Measured, on this host (ngspice-46 KLU, pinned gf180mcuD):
    - With `wnflag=1`, `show` reports the instantiated device resolving to
    `pfet_03v3.12` -- a normally declared bin, not an extrapolation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
    [test_harness.py, test_ngspice_options_precedence.py]
2026-09-15 sim(soft-start): confirm DR-0024's resize is a no-op on Iq and loop-stability (#225)
    Issue #212's second increment. PR #223 (first increment) landed DR-0024
    (the 1 uF startup-current-budget decision) and the Css/Ch_ss/Cr_ss resize
    with a fresh 163-point soft-start record, but left two acceptance-criteria
    items unverified: sim/quiescent-current and sim/loop-stability re-runs
    confirming the resize doesn't move Iq or the main loop's compensation.
    - sim/quiescent-current/records/20260915-115046-60785b1.md: fresh 45-point
    PVT re-run against the resized netlist reproduces the pre-resize record's
    numbers exactly, corner for corner (Iq is unaffected, as DR-0024 argued
    by construction -- now m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
2026-09-15 ci: run a pass-device-bearing corner in pvt-smoke (issue #221) (#226)
    Verifies DR-0025's deck-level '.options wnflag=1' model-bin pin on
    ngspice-42 (apt) and ngspice-47 (self-built), not just the ngspice-46 its
    own evidence was gathered on -- both honour the pin identically (parses,
    resolves m.xdut_full.xmpass.m0 to pfet_03v3.12). Turns the one-off manual
    check into a standing CI regression by running one nominal-point
    'sim/startup' corner (has a pass-device-bearing dut_netlist, unlike
    sim/smoke-bias) in the pvt-smoke job, on the apt ngspice it already installs.
2026-09-15 spec: mark DR-0022's clearance-at-1uF pass-count as stale (issue #227) (#229)
    DR-0022's Status/Consequences sections cite 63/63 (main matrix) + 20/20
    (0 mA) as the pass-count for the current-limit-clearance sub-clause at
    C_eff = 1 uF, from sim/soft-start/records/20260906-125202-f1096c9.md. A
    fresher record of the same testbench,
    sim/soft-start/records/20260915-103035-18f664f.md (produced after issue
    #191's acquisition-transient/settled-leakage regression was
    characterized), shows that same sub-clause failing at 46/79 points at
    the same 1 uF anchor.
    DR-0024 (issue #212) is still an unratified proposal (PR #228 open, not
    merged), so this adds a Status note documenting the staleness -- mirrori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
2026-09-15 fix: guard unmatched grep -o in champion:hold-state staleness check (#230)
    _check_champion_hold_state_staleness() piped an unguarded `grep -o
    'champion:hold-state head=[0-9a-f]*'` into a var=$(...) assignment.
    Under this script's `set -euo pipefail`, a PR with comments but no
    champion:hold-state marker (the common case) makes grep exit 1, which
    pipefail propagates to the whole pipeline and set -e then aborts the
    entire script silently (exit 1, zero output) — breaking merge-pr.sh
    for essentially every normal merge.
    Wrap the grep in `{ ... || true; }`, matching the guard already used
    by every sibling grep -o pipeline in this file (_partial_increment_refs,
    _closing_refs_stdin, _closing_ref_s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
2026-09-16 fix(soft-start): revert device-level FB transconductor to Binj_ss (issue #231) (#233)
    * fix(soft-start): revert device-level FB transconductor to Binj_ss (issue #231)
    sim/startup's 81-point full PVT matrix regressed after #195 (dce8d73)
    replaced the ideal, hard-rectifying Binj_ss behavioural current source with
    a device-level transconductor: four corners (ff_27c_3.63v, ff_125c_3.63v,
    ff_125c_3.30v, sf_125c_3.63v) no longer reach the settling threshold at all
    within the 6 ms window, despite being the fastest-settling corners in the
    2026-08-16 baseline.
    Bisected by swapping each candidate commit's design/netlist/ldo_core.spice
    against the current testbench: d3cb117 (Binj_ss) passes ff_27c_3.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
    [ldo_softstart.sch]
2026-09-16 docs(sim/harness): document -j/--timeout override for Gear-integration benches (#236)
    Issue #231's re-run found the harness's default `-j min(8, cpu_count)` /
    `--timeout 300` causes mass false timeouts (27/81 points) from CPU
    contention when running Gear-integration-heavy corner sets (sim/startup,
    sim/amp-selfosc) in parallel on a multi-core host, not a real circuit
    regression. Document the recommended override (`-j 3 --timeout 900`,
    confirmed clean 81/81 in ~490s) in sim/harness/README.md, with a pointer
    comment in each affected testbench's header so an agent hitting mass
    timeouts on these benches reaches for the override instead of assuming a
    settling regression.
    Closes #232
    Co-authored-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
2026-09-16 sim(startup): re-run full PVT against current main's DUT, confirm DR-0006's 6 ms bound holds (#220) (#238)
    Issue #220 flagged that DR-0024/DR-0025's E7 comparison showed the
    tt_27c_3.30v corner settling 1.455x slower on the then-current DUT vs. the
    sha DR-0006's 6 ms bound was measured against, projecting the worst corner
    (ss_-40c_3.63v) to land near 8.5 ms -- above the ratified bound.
    Re-running sim/startup's full 81-point PVT matrix against current main's DUT
    (design/netlist/ldo_core.spice @ 85d4bd23..., which now includes #231's
    revert of the destabilizing device-level FB transconductor from #195) shows
    the worst corner (still ss_-40c_3.63v) settling in 1.26134 ms -- comfortably
    inside t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
2026-09-16 fix(sim/soft-start-loop-gain): drop dead acopen-fb-inj/acshort-gmsum attribution rows, guard against recurrence (#234) (#240)
    Both rows stopped measuring anything after #231/PR #233 reverted the FB
    injection element back to the ideal `Binj_ss` behavioural source:
    `acopen-fb-inj`'s series inductor is a structural no-op against an ideal
    current source (Binj_ss's expression has no dependence on V(FB) at all, so
    its admittance out of FB is already exactly zero), and `acshort-gmsum`
    targeted a node that no longer exists in `ldo_softstart`. Both ran without
    raising and reported a delta that was zero by construction, not by
    measurement -- exactly the silent-false-negative CLAUDE.md's "verification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
    [test_soft_start_loop_gain.py]
2026-09-16 fix: widen merge-pr.sh closing-keyword regex to match colon-adjacent form (#241)
    GitHub's closing-keyword parser honored a squash-commit message reading
    "...cascode fix: #191 stays open..." — keyword, colon, whitespace, #N — but
    merge-pr.sh's detector required whitespace immediately after the keyword and
    never matched it, silently skipping both the pre-merge conflict warning and
    the post-merge self-heal reopen (recurrence of #4569/#4595, observed on #191).
    Closes #235
2026-09-16 fix(sim/soft-start-loop-gain): rewrite device/binj narrative as a cap-resize A/B and retire has_gmsum (#243)
    Issue #234/PR #240 fixed the two dead ATTRIBUTIONS rows and the module
    docstring/VARIANT_BLURB, but left render_record()'s prose and
    render_handover_deck()'s has_gmsum path describing the pre-#231 premise
    (device as a distinct device-level transconductor). Since #231's revert,
    device and binj both inject through the identical Binj_ss source and
    differ only in the DR-0024 MIM-cap resize on SSR/HG/SD -- nodes outside
    both the margin sweep's loop break and the DC hand-over's KCL-at-FB
    derivation.
    An actual PDK run (tt/27C/3.3V, both variants, full ramp grid) confirmed:
    - the phase-margi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
    [test_soft_start_loop_gain.py]
2026-09-16 fix(sim/harness): catch undefined-vector .let/v(...) as fatal (#242) (#244)
    run_ngspice_deck() did not treat ngspice's "Error: RHS "v(...)" invalid"
    (a .let scalar built from a v(...) reference to a node absent from the
    netlist -- ngspice exits 0 and prints this to stdout/stderr) as fatal, so
    the affected field silently came out empty/None downstream instead of
    raising.
    The literal-substring fix the issue originally asked for (add "no such
    variable" to FATAL_LOG_PATTERNS) was rejected after re-running the
    curator's corpus check: that phrase collides with an unrelated, expected
    non-fatal outcome (a .meas find/when with no crossing in the swept band,
    e.g. loop-stability's f0r/f180/gmx), and w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
    [test_run_ngspice_deck.py]
2026-09-16 sim(startup): re-judge tb.json checks against DR-0006's ratified 6 ms bound (#245)
    DR-0006 (startup settling window amendment, 3 ms -> 6 ms) is ratified
    (2026-09-14, PR #127) and README.md's Startup target row already reflects
    the 6 ms window, but tb.json's tsettle_full_ms/tsettle_min_ms checks were
    still hardcoded at the superseded 3 ms bound.
    - sim/startup/testbench/tb.json: bump checks.tsettle_full_ms.max and
    checks.tsettle_min_ms.max from 3.0 to 6.0, update their description
    strings to say "within 6 ms".
    - Re-ran the full 81-point PVT matrix
    (sim/startup/records/20260916-112114-8b551ab.md), superseding
    20260916-020328-7de7f8b (the current chain head per
    build_characterization_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
2026-09-18 spec: propose ratifying DR-0023's cascoded soft-start injection mirror topology (#217)
    Flips DR-0023's Status line to ratified (pending this pull request's own
    merge, per the ratification-via-PR policy), and independently re-derives
    every number the record cites -- the four-corner |V_ds| mismatch table,
    the 63-corner I_inj / release-point / out-of-regulation / settled-residual
    consequence table, and the Iq-adder and area arithmetic -- against the
    current head sim/soft-start-loop-gain and sim/quiescent-current records.
    Corrects one citation drift in the area estimate. No design/ file changed.
    Part of #191
2026-09-18 spec: propose ratifying DR-0024's 1 uF startup-current budget + 1.8 ms settling window (#228)
    * spec: propose ratifying DR-0024's 1 uF startup-current budget + 1.8 ms settling window
    This is the fourth application of the ratification-via-PR policy
    (2AMLogic/2am#357), for the same reason PR #127/#137/#199 used it: the
    operator's review and approval of this pull request is the ratification
    act itself, not a separate comment. DR-0024's Status line, and README.md's
    Startup row / notes 5a and 8, only become true of main once this PR is
    approved and merged.
    Scoped narrowly to what sim/soft-start/records/20260915-103035-18f664f.md
    actually proves: the ramp-rate (<= 5 V/ms, 155/155) and settling (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
2026-09-18 soft-start: cascode the FB-injection mirror per DR-0023, with full PVT evidence (#246) (#250)
    * soft-start: cascode the FB-injection mirror per DR-0023 (issue #246)
    Replaces design/ldo_softstart.sch's ideal Binj_ss behavioural source with the
    device-level transconductor #191 built (dce8d73, reverted by #231/8fff168)
    PLUS the two cascode devices spec/decision-records/DR-0023-softstart-
    injection-mirror-topology.md ratifies (PR #217, merged 2026-09-18):
    Mgmrc_ss pfet_03v3 4u/1u reference leg's cascode, diode-connected at
    GMSUM, source GMRM, body = own source
    Mgmc_ss pfet_03v3 4u/1u output leg's cascode, gate GMSUM, source GMOD,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
    [ldo_softstart.sch, summary.csv, targets.csv, transfer.csv]
2026-09-18 fix: make the ngspice identity check pin-aware so it stops blaming the pinned binary (#252)
    `--check-env`'s toolchain-identity check resolved the expected root as
    `brew --prefix ngspice` and enforced containment only. Once homebrew-core's
    unversioned `ngspice` formula moved to ngspice-47, that inverted on every
    upgraded host: it reported the host's correctly-pinned ngspice-46 as the
    fault and named the unvalidated ngspice-47 Cellar as the root to "fix"
    towards -- advice that would move `sim/` evidence onto a major version
    DR-0025's `wnflag` model-bin pin was never validated against (issue #221).
    The check now enforces two things and says which side is at fault:
    - Version: the resolved `ngs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
    [test_harness.py]
2026-09-18 spec: flip DR-0025's Status from proposed to ratified (#255)
    DR-0025 ("gf180mcu model-bin selection binds on the per-finger width
    W/NF; this repo pins it in the deck rather than inheriting it from the
    host") landed on main via #222 carrying Status: proposed, with its
    ratification tracked in #219.
    Flip that Status line to ratified, and replace its now-stale "ratification
    is the operator's" clause with the two-key mechanism the operator put in
    force on 2026-09-18 (EE key + market key; no per-PR operator sign-off).
    Record the independent re-verification performed for the flip, on a second
    host running a different operating system from the one DR-0025's Evidence
    section was taken on (macOS, ng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
2026-09-18 fix: render every bold clause of a split Overall verdict in the rollup (#256)
    sim/build_characterization_report.py extracted a record's verdict with
    `\*\*Overall[^*]*\*\*` -- one bold run, terminated by the next `*`. A
    record that states one verdict as several bold runs separated by
    unbolded qualifying prose therefore rendered only the first run, so
    sim/CHARACTERIZATION.md's Startup row read materially more favourably
    than sim/soft-start/records/20260918-190207-8a59d23.md, the evidence it
    summarises: the record's "and FAIL on inrush and current-limit
    clearance", "FAIL on inrush, current-limit clearance, monotonicity and
    peak dV_out/dt" and "T1, T2, T3 and T4 FAIL" clauses were all dropped.
    T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
    [test_build_characterization_report.py]
2026-09-18 spec: propose DR-0026, close the soft-start injection accuracy gap with a local servo loop (#258)
    #246 shipped DR-0023's cascode and closed T5 (37/63 violated -> 0/63), but
    T1-T4 still fail at every corner: I_inj(0) is low by 3.2...16.9% at 63/63.
    design/softstart_injection_compensation.md section 3 (R4) names this as the
    trigger for a new decision record rather than another sizing iteration.
    Adds spec/decision-records/DR-0026-...md in PROPOSED status. No design/ file
    is touched, per #249's requirement that ratification precede design change.
    The record decomposes the residual into two terms, both re-derived from the
    committed 63-row handover rollup 20260918-190353-8a59d23-handover/targets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
2026-09-19 sim: waive grid-level spread checks on a grid too small to define a spread (#253) (#260)
    * sim: waive grid-level spread checks on a grid too small to define a spread
    `bash sim/selftest.sh --quick` could never pass. `--quick` collapses the
    PVT sweep to a single point (`--corners tt --temps 27 --supply-tol 0`),
    and a spread over one sample is 0 by construction -- so smoke-bias's
    `min_spread_pct` floors (`vbias` 5.0, `vbe` 20.0), whose whole purpose is
    to prove `.temp`/`.lib` actually move between points, were unsatisfiable
    and stage 3 FAILed permanently. Its `max_spread_pct` ceilings had the
    mirror-image problem: they "passed" vacuously.
    Root cause is a category error, not a threshold: `spre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
    [test_harness.py]
2026-09-19 sim: list soft-start-loop-gain in the rollup appendix and fail on any unmapped slug (#262)
    sim/soft-start-loop-gain/ carries committed evidence but reached neither
    ROWS nor SUPPORTING_SLUGS_NOTE, so sim/CHARACTERIZATION.md -- the one file
    tying every ratified row and supporting bench to its current evidence --
    did not mention the experiment at all. The generator did notice, but only
    as a stderr warning followed by an unconditional exit 0, and CI's "Verify
    sim/CHARACTERIZATION.md is up to date" step diffs stdout, so nothing read
    it.
    It is listed in the appendix rather than mapped as a Source under the
    Stability row: its own README is explicit that a pinned mid-ramp state is
    not in DR-0001's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
    [test_build_characterization_report.py]
2026-09-19 spec: DR-0025's wnflag facts reproduce on ngspice-42/47 (DR-0027) (#263)
    * sim: add a toolchain-portability slug that re-measures DR-0025's wnflag facts on any ngspice
    Issue #221 scoped re-validating DR-0025's deck-level `.options wnflag=1`
    model-bin pin on ngspice majors other than the 46 it was established on, and
    that was never performed -- while #247/PR #252 made the missing validation the
    documented prerequisite for ever moving the pin.
    This lands the re-runnable measurement, ahead of the evidence records it
    produces:
    - `wnflag_facts.py` re-derives DR-0025's three simulator-level facts (bin
    resolution at wnflag=1, hard parse failure at wnflag=0 with no clamp path,
    first-card-wins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
    [ab-margins.csv]
2026-09-19 spec: propose DR-0027, a negative/partial result for gating soft-start's injection degeneration branches (#264)
    Issue #259 asks for the ~7.18 uA the FB-injection transconductor's two
    degeneration branches burn after hand-over to be recovered, since the
    ratified Iq row now binds at 1.29 uA (full-load clause) rather than the
    1.96 uA (no-load clause) the schematic's own note previously quoted.
    A prototype mechanism -- gate both branches' VIN feed through one PMOS
    switch whose gate is the mirror's own GMRM node, so it throttles off as
    a side effect of DR-0023's existing rectification-by-cutoff event rather
    than a new threshold -- recovers 1.8-7.0 uA at three of four sampled PVT
    corners with at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
    [ldo_softstart.sch]
2026-09-19 soft-start: gate the FB-injection degeneration branches off at release (DR-0027, issue #259)
    design/ldo_softstart.sch's two degeneration branches (Rgma_ss/Mgma_ss,
    Rgmb_ss/Mgmb_ss) carried standing DC current forever after hand-over --
    only the mirror (Mgmr_ss/Mgmrc_ss/Mgmo_ss/Mgmc_ss) rectified at release,
    per DR-0023. Measured cost: sim/quiescent-current/records/
    20260918-190801-8a59d23.md, +0.004...+7.18 uA of settled-state Iq, worst
    at ff_125c_3.63v, dominated by the branches (~2x Ia) rather than the
    cascode (~+2.7 uA). The ratified Iq row (< 30 uA, DR-0004 A6) binds at
    both no load and full load; at the binding corner iq_full_ua is 28.71 uA
    against the ceiling -- 1.29 uA of headroom, no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
    [ldo_softstart.sch]
2026-09-19 spec: renumber the soft-start branch-gating negative result DR-0027 -> DR-0029 (#269)
    Two decision records both landed on main as DR-0027 six minutes apart:
    PR #263's wnflag-facts record (04:06:50Z) and PR #264's soft-start
    injection-branch-gating negative result (04:12:55Z). Two sessions each
    computed "next free DR number" against origin/main inside the same window,
    before either PR merged.
    Renumber the second one. It merged later and had no inbound cross-references
    by path, so it is the smaller blast radius; DR-0027 stays with the
    wnflag-facts record, which docs/environment-setup.md, sim/CHARACTERIZATION.md
    and four sim/toolchain-portability records already cite by full path.
    DR-0028 was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
    [ldo_softstart.sch]
2026-09-20 signoff: grade this block's T1 state from a klt manifest instead of hand-reading it (#271)
    This repo's gap to T1 has been hand-written prose in issue #79 since
    2026-08-09 -- an 88 KB living checklist re-derived by hand at least five
    times. Prose goes stale the moment either the evidence or the checklist
    moves, and both moved: the checklist grew an eleventh item, "Power delivery
    (structural)", on 2026-09-17 (klayout-tools#2025), invalidating every
    hand-read that predates it.
    Commit the machine-readable statement instead. `klt signoff --manifest`
    renders the whole T1 table mechanically, per item, with a reason for every
    unmet row; nothing in this repo fed it.
    - signoff/block-manifest.json --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
2026-09-22 sim: re-verify DR-0018's ratified stability envelope on the current design (630/630) (#277)
    * sim: re-verify DR-0018's ratified stability envelope on the current design
    Issue #51's remaining work after the operator ratified DR-0018 on 2026-09-15
    (PR #199, 909a060) is not a further circuit change -- the ruling states
    "Candidate-2 bias redesign is not a precondition" -- it is evidence: every
    committed statement of the ratified Stability envelope was measured on the
    2026-09-06 netlist (20260906-071437-fff0bf0), which predates the #189/#191
    soft-start FB-injection replacement, DR-0023's cascoded injection mirror
    (#250) and DR-0024's ramp-capacitor resize (#223). No clean full-matrix
    loop-stabil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
    [20260922-012628-ac57c94-matrix.csv, 20260922-022122-ac57c94-delta.csv]
2026-09-22 layout: add the floorplan, matching plan and a re-derivable core-area estimate (#280)
    There is still no GDS, but the physical commitments that are expensive to
    revisit once drawing starts can be fixed now that the compensation topology
    and stability envelope are settled (DR-0018, #51).
    layout/floorplan.md states them: the pass array as N identical
    `pfet_03v3 L=0.28u W=50u nf=1` unit cells with `Msense` drawn as M of the
    same cell inside the array (so the 1/40 replica ratio is geometry, not two
    independently edited W= strings); a 50 mA metal strategy checked against the
    tech LEFs' published DCCURRENTDENSITY (binding level M1 at 2.4x, and two rows
    that only pass because they are tapped/stitch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
2026-09-22 spec: derive the tech LEF EM unit convention and book the CON gap as DR-0030 (#282)
    The open gf180mcu PDK's only machine-readable EM data is the
    DCCURRENTDENSITY / ACCURRENTDENSITY entries in the six standard-cell
    tech LEFs. Those entries carry no unit statement beyond
    `UNITS ... CURRENT MILLIAMPS 1 ;`, so layout/floorplan.md was citing
    0.67 mA/um of drawn width without showing why that reading, rather than
    mA/um^2 of cross-section, is the right one -- a factor-of-thickness
    difference (1.85x on Metal1-Metal4, 1.19x on Metal5) and permissive in
    the wrong direction on Metal5.
    New §8.1 settles it from the file against itself, re-derivable from the
    pinned checkout c6d73a35f524070e85faff4a6a9ee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
2026-09-22 fix: grade Stability against DR-0018's ratified envelope, not DR-0001's original matrix (#281)
    * fix: grade Stability against DR-0018's ratified envelope, not DR-0001's original matrix
    sim/build_characterization_report.py graded the Stability row by parsing
    the head loop-stability record's own top-level Overall prose verdict,
    which states DR-0001's ORIGINAL, wider 4536-point matrix. README.md's
    Stability row has claimed only the narrower DR-0018 envelope (0.1-50 mA,
    C_eff = 1 uF nominal, ESR >= 200 mOhm) since 2026-09-15, so the rollup
    was grading a ratified row against a matrix wider than what it actually
    claims -- reporting FAIL on a design that meets its own ratified target.
    Add an Enve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
    [test_build_characterization_report.py]
2026-09-22 layout: make the DRC/LVS flow drive any registered cell, on any host (#283)
    * layout: make the DRC/LVS flow drive any registered cell, on any host
    Two prerequisites for laying `ldo_core` out, both of which had to land
    before a real block could be pushed through `layout/drclvs.py` at all.
    **A cell registry instead of test-cell constants.** The seven stages now
    take a `CellSpec` -- generator, LVS reference schematic, substrate net,
    where the exported netlist is committed, and the xschem library path a
    cell that instantiates `design/` symbols will need -- rather than the
    module-level `CELL`/`TOP_CELL`/`SUBSTRATE_NET` the bring-up cell baked
    in. `CELLS` is the registry a block's layout plugs i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
2026-09-23 layout: draw the feedback divider, and make an inapplicable LVS control a hard error
    Two coupled pieces, coupled because the second is what makes the first
    count as evidence.
    **The divider.** `layout/divider/` draws floorplan.md §4.1's array from the
    PDK's own `ppolyf_u_high_Rs_resistor` PCell: 18 `ppolyf_u_3k` units
    (W = 2 um, L = 31.8 um) at a 2.4 um pitch, 6 up / 12 down interdigitated
    `B T B B T B B T B B T B B T B B T B`, one dummy strip at each end, inside
    its own substrate-tap ring. Both legs' centroids land on position 9.5 --
    §4.1's stated target -- and `plan.py` holds that arrangement as numbers so
    the generator and `layout/tests/test_divider_layout.py` read the same
    constants ra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
    [fb_divider.sch]
2026-09-23 spec: keep the pass device at 2 mm — widening it far enough for the 200 mV dropout stretch breaks DR-0018's ratified gain margin (#295)
    Issue #139 asked for a pass-device width decision: the shipped 2 mm device
    misses the < 200 mV dropout stretch at 9 of 27 PVT corners, and
    sim/devchar/CONCLUSIONS.md §1 recommends ~4 mm. Measured out, the width is
    bounded from both sides and the two bounds do not overlap:
    - dropout scales as 1/W from 267.383 mV at 2 mm, so the stretch needs
    W >~ 2.7 mm (measured: 2.53 mm -> 212.592 mV, misses; 3.00 mm ->
    180.656 mV, clears 27/27);
    - widening raises Cgg, drops the pass-gate pole and spends gain margin at
    the top of DR-0018's ratified ESR range. At 5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
    [summary.csv]
2026-09-23 sim: the ratified PSRR row fails on main -- bisected to the soft-start injection element's settled residual, and why no sizing lever closes it (DR-0031) (#305)
    * sim: the PSRR row fails on main, bisected to the soft-start injection element (DR-0031)
    `sim/psrr-vs-freq`'s committed PASS record was stale, not wrong: it was taken
    on 2026-09-05 against `2a7caecb`'s netlist. Re-run against `main`, the
    ratified `README.md` PSRR row (`> 50 dB @ 1 kHz`) FAILS at 3 of 45 corners,
    worst 29.4268 dB at `ff_125c_3.63v`, and the 50 mA sibling fails identically
    (to 0.004 dB), so the defect is not load-dependent.
    Evidence minted, both superseding the stale pair:
    sim/psrr-vs-freq/records/20260923-084323-a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
2026-09-23 design: a poly resistor's flavour follows its DC-current duty (DR-0033) — Rz/Rza/Rbufb go ppolyf_u_3k, Rbias cannot, and 17% of the core-area budget comes back (#306)
    * design: redraw Rz/Rbufb/Rza in ppolyf_u_3k, hold Rbias at 1k (DR-0031, #279)
    The poly-resistor field was 48.9% of the ratified < 0.1 mm^2 core budget --
    four times the pass device. error_amp's four ppolyf_u_1k serpentines are the
    largest single contributors, and ppolyf_u_3k offers 3.04x the sheet resistance
    for the same drawn width.
    Three of the four take the swap; the fourth cannot, and it is not the one the
    issue expected. Rz, Rza and Rbufb sit in branches that carry no DC current
    (the Rz/Cc Miller branch measures V(N1)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
    [20260923-000113-a406143-matrix.csv, error_amp.sch]
2026-09-23 sim(harness): record which DC continuation rung each PVT corner's op solved on (#314)
    * fix: seed quiescent-current's DC solve onto the regulating branch
    At ss/-40C/2.97V the deck exhausted ngspice's whole continuation ladder
    (Newton -> dynamic gmin -> true gmin -> source stepping) and fell through
    to the last-resort pseudo-transient op, which reports an unsettled
    transient snapshot rather than a DC solution: the soft-start hold gate
    sat at 1.0809 V when its only DC-legal value is EN (= VIN), and all three
    instances reported negative supply currents, i.e. capacitor displacement
    current. Add a .nodeset DC seed to tb.json that starts the two enabled
    instances' first Newton pass on the regulat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
    [test_harness.py]
2026-09-23 design(error_amp): fix §6.14's phase-margin cell to the shipped variant's own head record (#315)
    The "now" column of §6.14's cost/benefit table printed 55.58° — the worst
    phase margin of the *rejected* all-four-resistors-to-3k variant DR-0033
    evaluated and discarded, not the shipped Rz+Rza+Rbufb-only variant. The
    shipped variant's own head record, sim/loop-stability/records/
    20260923-000113-a406143.md, computes 55.45° (also what README.md and
    sim/CHARACTERIZATION.md already cite). Correct the cell and cite the record
    id inline so it can't drift from evidence again.
    quiescent-current's 45-vs-81-point corner-set gap this issue also reported
    was independently closed by #314 (issue #301)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
2026-09-23 spec: the < 200 mV dropout stretch unlocks on margin DR-0033 already delivered — pass device to 2.8 mm (DR-0034) (#316)
    * design: widen Mpass to 2.8 mm and Msense to 70 um (DR-0034)
    DR-0032 capped the pass device at ~2.5 mm on DR-0018's ratified GM >= 10 dB
    and measured the < 200 mV dropout stretch to need W >~ 2.7 mm, leaving a
    ~1.9 dB gain-margin gap. DR-0033's poly-resistor re-flavour (merged the next
    day, for core area) returned 2.09 dB at the binding 50 mA / 1 uF / 500 mOhm
    point, so the two intervals now overlap.
    Mpass: pfet_03v3 L=0.28u W=2800u nf=40 (40 unit cells of W=70u nf=1).
    Msense: pfet_03v3 L=0.28u W=70u nf=1 -- exactly one more of the same unit
    cell, keeping DR-0005's 1/4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
    [20260923-132038-a992b52-matrix.csv, ldo_core.sch, ldo_ilimit.sch, summary.csv]
2026-09-23 sim(harness): make the pseudo-transient op rung fatal for DC benches (#318)
    ngspice's last continuation rung exits 0 and prints every requested
    measurement while reporting a snapshot of an unsettled synthetic
    transient as the operating point (#310). Gate both harness code paths
    -- run_ngspice_deck() (check 4, loop-stability/soft-start-loop-gain/
    soft-start) and run_point() (quiescent-current and every tb.json bench,
    which had no fatal-log check of any kind) -- on the ladder-exhaustion
    phrases ('transient op', 'source stepping failed'), sharing one pattern
    and helpers. The gate is analysis-kind gated: a deck that declares a
    .tran analysis is exempt, because its initial-time-point solve walks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
    [test_harness.py]
2026-09-23 report: pick the newest record matching the current DUT, not just the newest (#319)
    `latest_substantive_record()` selected the lexicographically-latest record
    that owned a netlist snapshot, without asking whether that snapshot matched
    the *current* DUT. Record ids are minted when a branch runs its bench, not
    when it merges, so a branch that measures against the DUT it started from
    can land a record that is simultaneously the newest by id and a measurement
    of a netlist `main` has since replaced. Selected on recency alone, that
    record downgrades its row from fresh to stale even though a record matching
    the current DUT is sitting in the same directory -- what #308's
    `20260923-093349-7674ddf` (p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
    [test_build_characterization_report.py]
2026-09-23 fix: render the PDK's lvs_format-less passives as primitive R/C so LVS can read them (#321)
    * layout: render PDK passives as primitive R/C so LVS can read them
    The gf180mcu PDK's xschem symbols carry an `lvs_format` attribute only on
    the FETs. With `lvs_netlist 1` the transistors render as primitive `M`
    elements but every resistor and MIM cap stays in xschem's simulation form
    (an X-prefixed subcircuit call), which KLayout's SPICE reader turns into a
    call to an undefined subcircuit instead of a device -- so drclvs.py stage 2
    hard-failed on any cell containing a passive, i.e. on every real block.
    - layout/lvs_form.py: translate the two passive families to primitive R/C
    elements, keyed on t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
    [drclvs_passives.sch]
2026-09-23 sim(standalone benches): propagate #310's pseudo-transient op gate to run_point.sh (#322)
    sim/harness/runner.py's run_point()/run_ngspice_deck() fail a DC-solve
    corner whose log shows the DC continuation ladder exhausted -- the
    pseudo-transient `op` rung (#310) -- but the standalone benches that drive
    ngspice through their own run.sh (current-limit, enable-shutdown,
    soft-start, op-point-sanity) share a different driver,
    sim/harness/lib/run_point.sh's harness_run_point(), which never gained
    #310's gate. sim/devchar/lib/devchar.sh's dc_run() independently
    reimplements the same fatal-check body and has the identical gap.
    Both now shell out to runner.py's own _ladder_exhaustion_lines() /
    _runs_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
2026-09-23 spec: propose DR-0035 -- a VIN-referenced soft-start ramp ceiling (#323)
    Move Mtop_ss's gate off VREF onto a new VCEIL held a fixed resistor-ratio
    drop below VIN (Rceil_ss off the cell's own Iref_ss). The settled forward
    bias across the mirror's reference stack stops containing VIN, so the
    element's supply-referenced residual (DR-0031's defect, T8) is removed by
    construction rather than by margin: measured on the 45-corner prototype,
    T8 goes 109.9004 -> 0.0328 nA/V and the ratified PSRR row goes FAIL ->
    PASS 45/45 with 9.597 dB margin at 1 mA (9.551 dB at 50 mA), while the
    Iq row's binding headroom goes 1.285 -> 6.554 uA. Delta's window is swept
    to both edges (-34%/+49% around 1.4496 V), the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
2026-09-24 sim(#304): the compliance sink never had a root to delete at fs_125c_3.63v -- it is a false convergence, and the claims now say so (#326)
    * sim(harness): scope the compliance-sink guarantee to the root it can delete (#304)
    sim/psrr-vs-freq at fs_125c_3.63v landed on a sub-ground DC state in record
    20260923-084323-a6c95f8 -- the failure mode the compliance-limited load sink
    was built to delete -- while reporting dc_iload_ma = 0. Measured against that
    record's DUT netlist, the sink was never in a position to delete it:
    - Below the knee the sink is exactly 0 A and 0 S (f(VOUT) underflows to 0.0
    in IEEE double for every VOUT <= -0.7530773732699249 V), so the load
    network is absent from the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
2026-09-24 sim: scope the compliance-sink guarantee in five sibling decks and gate the missing vout half (#328)
    * sim: scope the compliance-sink guarantee in the five sibling decks (#325)
    PR #326 scoped sim/psrr-vs-freq's claim and header comment to say the
    compliance-limited load sink deletes the SINK-SUSTAINED sub-ground root
    (#40/#46) and nothing else. Five sibling decks still asserted the
    unscoped version verbatim:
    line-regulation, load-regulation, load-transient, psrr-vs-freq-50ma
    ("unphysical sub-ground DC solution #40 found" variant), quiescent-current
    Each deck's claim field and tb_*.spice header now carry the qualifier and
    a "What the bound does NOT delete (#304)" paragraph that points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
2026-09-24 layout(#285): the pass array and its Msense replica, as one DRC/LVS-clean cell (#329)
    `layout/pass_array/` draws the LDO's power path: N = 40 `pfet_03v3` unit
    cells (L = 0.28 um, W = 70 um, nf = 1) with M = 1 `Msense` replica of the
    *same* unit cell at the array centroid, so the 1/40 replica ratio is
    geometry -- how many copies were placed -- rather than two independently
    edited `W=` strings. `layout/floorplan.md` §3.2's placement rules are
    implemented literally: the pass fingers split into two equal halves either
    side of the replica, a diffusion break keeps `ISNS` out of the `VOUT` drain
    comb, the cells either side of the break present `VIN` source regions, and
    every gate sits on one `PASS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
    [pass_array.sch]
2026-09-24 layout(#330): floorplan §3 re-keyed to the shipped 70 µm unit, and its IR split replaced by the measured one (#331)
    §1 has recorded DR-0034's W = 2.8 mm (N = 40 unit cells of `W=70u nf=1`)
    since #294, but §3 was still written against the superseded 50 µm unit and
    the 2 mm device, and §3.4's array IR was an estimate that the first real
    pass-array layout (#285) has now measured and falsified by 3.3 mΩ.
    - §3.1 restates the unit cell as `W = 70 µm, nf = 1` and re-derives its table
    at N = 40: active area 2265 µm², 140 contacts and 134 via1 cuts per drain
    region against 100 / 96 at the 50 µm unit. The stack dimension (32.4 µm) is
    a function of N alone and does not move.
    - §3.2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
2026-09-25 docs: restate DR-0030's contact EM margin at the shipped 2.8 mm pass device (#334)
    DR-0030 (Status: proposed) quoted its survivability margin against the
    superseded W = 2 mm pass device (25.0 µA/cut, 5.2x). The shipped device is
    W = 2.8 mm on a 70 µm unit (DR-0034 / #294), which puts 140 contacts under
    each 2.50 mA drain region -> 17.9 µA/cut, 7.2x margin, measured as-drawn in
    layout/records/20260924-213542-3ec8f89.md.
    Three passages refreshed, with the 2 mm figures preserved as history:
    - the "margin that makes the placeholder survivable" paragraph;
    - revisit trigger 3's "At 2 mm today ..." clause (its 43 µA threshold is
    unchanged);
    - the Consequences "must be written that way" sente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
2026-09-25 layout(#333): dedupe _fail/_rd/_load_pdk_pcells/_label into gen_gds_common.py (#336)
    layout/passives/gen_gds.py and layout/pass_array/gen_gds.py carried
    byte-identical copies of _fail, _rd, _load_pdk_pcells, _label, and the
    PDK_OPTION = "D" constant. Consolidated the four helpers into a new
    layout/gen_gds_common.py, imported via the same sys.path.insert + from
    X import Y idiom sim/harness/pvt_log.py's callers and layout/drclvs.py
    already use.
    _load_pdk_pcells now takes an explicit pdk_option argument instead of
    reading a module-level PDK_OPTION constant, since each caller keeps its
    own. _rd reads the caller's frame globals rather than its own module's
    globals(), because KLayout injects -rd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
2026-09-25 layout(#335): align floorplan.md §8.3 prose to DR-0030's updated 2.8 mm margin (#337)
    Now that PR #334 has updated DR-0030 to record the shipped 2.8 mm device's
    actual 17.9 µA / 7.2× margin (with 2 mm figures preserved as history only),
    two passages in layout/floorplan.md §8.3 that quoted the old frozen wording
    needed alignment:
    1. Replaced the discrepancy claim ("DR-0030's own text still quotes 25.0 µA /
    5.2×") with a plain statement that DR-0030 now records the 2.8 mm device's
    current 17.9 µA / 7.2× margin.
    2. Made the downstream EM caveat device-relative: changed from quoting the
    frozen "5.2× margin" to "with *N*× margin — at this device", consistent
    with DR-0030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
2026-09-30 chore: drop superseded unbled branch-gating prototype (issue #259)
    The prior Builder session's single commit on this branch (45df355a,
    pre-rebase) shipped an unbled Mgmk_ss-only prototype into design/ plus a
    duplicate DR-0027 file. That exact mechanism was independently prototyped,
    measured (non-convergent at ss_-40c_2.97v) and filed as a negative result
    by a later session, which landed on main as DR-0029
    (spec/decision-records/DR-0029-softstart-injection-branch-gating-negative-result.md,
    PR #264/#269). This branch was 94 commits behind main and had never picked
    that up.
    Sync via merge (not reset --hard, to keep full provenance and avoid the
    protected-branch force-op guard) then revert the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
    [ldo_softstart.sch]
2026-09-30 soft-start: gate the FB-injection degeneration branches' supply, bled (issue #259)
    design/ldo_softstart.sch's two VIN-referenced degeneration branches
    (Rgma_ss/Mgma_ss, Rgmb_ss/Mgmb_ss) carry standing DC current forever after
    hand-over -- only the cascoded mirror rectifies (DR-0023), one node
    downstream of the branches themselves. Measured cost:
    sim/quiescent-current/records/20260918-190801-8a59d23.md, +0.004...+7.18 uA
    of settled-state Iq, worst at ff_125c_3.63v, dominated by the branches.
    Re-attempts the mechanism DR-0029 filed as a negative/partial result and
    PR #267 (DR-0028, closed unmerged 2026-09-30 by operator direction) tried
    to land: one PMOS switch, Mgmg_ss (pfet_03v3, 10 um / 0.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
    [ldo_softstart.sch]
2026-09-30 Revert the branch-supply gating topology; design/ back to main (issue #259)
    Commit 1b256142 on this branch re-landed the exact mechanism PR #267 /
    DR-0028 proposed (Mgmg_ss + Rgmg_ss between VIN and a new VING node, both
    degeneration resistors re-terminated onto it), with identical device values.
    The operator closed PR #267 unmerged 29 minutes before that commit was made
    (2026-09-30T19:14:27Z): "DR-0029 stands; DR-0028 is not adopted."
    Re-landing it is not this builder's call to make, and issue #303 -- the
    constraint issue that records the mechanism's 5-7 dB PSRR cost at the two
    corners the ratified row already fails -- is labelled loom:operator-only /
    loom:operator-decision precisely becau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
    [ldo_softstart.sch]
2026-09-30 spec: the soft-start branch standing current comes back at the ramp ceiling, not at the branches (DR-0036)
    Issue #259 asks for the ~5 uA of settled-state Iq the FB-injection
    transconductor's two degeneration branches burn after hand-over. Three
    attempts have now been made at the branches themselves (DR-0029's unbled
    switch, DR-0028/PR #267's bled switch, and this branch's own reverted
    re-attempt). DR-0036 measures the surviving one head to head, on ONE tree
    and one host, against the mechanism DR-0035 already proposes for the PSRR
    row's sake -- which had never been done: PR #267's numbers are against main
    at 8a59d23 and DR-0035's against a6c95f8, and main has since taken #306's
    resistor flavo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
    [ldo_softstart.sch]
2026-09-30 feat: let handover_t15.py grade an arbitrary --dut-netlist, gated on --no-write
    The T1-T5 hand-over driver's only netlist knob was `--variant
    {device,binj}`, and both variants build from the committed
    `design/netlist/ldo_core.spice`. So A/B-ing a candidate FB-injection
    element through T1-T5 meant committing the prototype into `design/` --
    the false choice DR-0035 (no T1-T5 column at all) and DR-0036 §4 (a
    column for the one candidate that happened to be committed) each landed
    on a different side of.
    `--dut-netlist PATH` now points the transfer at an arbitrary
    `ldo_core.spice`-shaped netlist, applying the same `nv.instrument_core`
    SSR promotion `--variant device` applies to the committed ex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
2026-10-01 chore: resync installed Loom surfaces
    resynced_by: fleet-resync
    invocation: fleet-resync.sh --fleet-only --push
    <!-- loom:provenance v1 build=unknown 19f4e67fd0a0afbd3d8b6606ca91ceac911377a3 clean prompts=none sweep=none story=none trace=78a5dfbdfd8c530aecd1bb436fd096df host=loom-worker-2 base=579f3d003e5ff0cc9884c9fbc3bc1deba678d923 run=loom-run/v1:timer:loom-worker-2/fleet-resync:67c759f7ef3c43e38d3fa8d5f19a2dd1 installs=0.19.593 658650a4f0eff932ac66a8f690eaedf8123fc83b -->
    Loom-Story: none
    Loom-Trace-Id: 78a5dfbdfd8c530aecd1bb436fd096df
    Loom-Build: unknown 19f4e67fd0a0afbd3d8b6606ca91ceac911377a3 clean
2026-10-01 chore: resync installed Loom surfaces
    <!-- loom:provenance v1 build=unknown 56435bf476452911283e43940ecfd9a30f804af9 clean prompts=none sweep=none story=none trace=342405c5ebc99bdbf17afbd983c0c41c host=loom-worker-2 base=bbc3203b48e99d8a0e00376b06c7ed8313cc34ba run=loom-run/v1:timer:loom-worker-2/fleet-resync:20c09f231d424cd5b57ca7991848dd8a installs=0.19.603 8c39bf7cde8a8c03d1aaee441f397c017b6a3a9e -->
    Loom-Trace-Id: 342405c5ebc99bdbf17afbd983c0c41c
    Loom-Build: unknown 56435bf476452911283e43940ecfd9a30f804af9 clean
    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
2026-10-01 chore: resync installed Loom surfaces
    <!-- loom:provenance v1 build=unknown f2868e6b4d60d11a8ab47d25cad9e248229d2f66 clean prompts=none sweep=none story=none trace=4e2766ed5160781df891476246a9be2e host=robb-studio base=9c0cd7ce19923e0b91233a30dde820ea40ae233d run=loom-run/v1:timer:robb-studio/fleet-resync:2d3851d5-1673-43ae-bcc6-e5c971b37f33 installs=0.19.603 74778a6aeea5d9e06b489400942b35f33c8bb766 -->
    Loom-Trace-Id: 4e2766ed5160781df891476246a9be2e
    Loom-Build: unknown f2868e6b4d60d11a8ab47d25cad9e248229d2f66 clean
    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
2026-10-01 chore: resync installed Loom surfaces
    <!-- loom:provenance v1 build=unknown d6714830391f7596338b8de40ee2d0f45dcd12f5 clean prompts=none sweep=none story=none trace=af273f717e759e690d07f372734e9278 host=robb-pro base=539047b425003b1f6a277c8a7b84b4a0ac6b13d6 run=loom-run/v1:timer:robb-pro/fleet-resync:92e2f9ba-d083-411b-833b-ae52d169ef04 installs=0.19.605 6eb2b65a4496b7becb84ef1f944493a541fd01cd -->
    Loom-Trace-Id: af273f717e759e690d07f372734e9278
    Loom-Build: unknown d6714830391f7596338b8de40ee2d0f45dcd12f5 clean
    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
2026-10-01 chore: resync installed Loom surfaces
    <!-- loom:provenance v1 build=unknown 617257919edc1b9b9ee27532c5ec1b8a64523388 clean prompts=none sweep=none story=none trace=cb047565635d880cd4ae328b5cfaaf68 host=loom-worker-1 base=11952230ee880d7a060e224c548b34e958775812 run=loom-run/v1:script:loom-worker-1/fleet-resync:9973280a-d0de-4196-8cdb-f221825edc41 installs=0.19.609 ff30576dacc8c2734b1c7434bedd29c47122caeb -->
    Loom-Trace-Id: cb047565635d880cd4ae328b5cfaaf68
    Loom-Build: unknown 617257919edc1b9b9ee27532c5ec1b8a64523388 clean
    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
2026-10-01 chore: resync installed Loom surfaces
    <!-- loom:provenance v1 build=unknown 617257919edc1b9b9ee27532c5ec1b8a64523388 clean prompts=none sweep=none story=none trace=dbafe4f8526617aa07c890721298a080 host=robb-studio base=3c93dbbb2e8463e16c40432a13d2eaa46c24216d run=loom-run/v1:timer:robb-studio/fleet-resync:1817df66-02cc-4b27-927d-a38485da550a installs=0.19.610 c94891dd526cf6db5ee02045424c6913be522048 -->
    Loom-Trace-Id: dbafe4f8526617aa07c890721298a080
    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
2026-10-01 chore: resync installed Loom surfaces
    <!-- loom:provenance v1 build=unknown a2a39ac2736eb2686e2c65412d939e67c0438a7d clean prompts=none sweep=none story=none trace=fc1a121767151aae5bd7427c683b7db6 host=robb-pro base=7eb9501f874122e409d06583241dd7fbf639e9cd run=loom-run/v1:timer:robb-pro/fleet-resync:708eb7c8-469d-4783-80b7-bafe142df3c4 installs=0.19.612 d25614656adcf70162da95c5e1035e99a0639a1a -->
    Loom-Trace-Id: fc1a121767151aae5bd7427c683b7db6
    Loom-Build: unknown a2a39ac2736eb2686e2c65412d939e67c0438a7d clean
    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
2026-10-01 chore(tooling): update repo-skills to v0.19.5
    Fleet-wide Repo Skills rollout (2026-10-01). compute-drift's axis 6
    reported repo-skills at 11 different versions across the fleet's
    checkouts; this brings gf180-ldo from v0.10.0 to v0.19.5 (rjwalters/repo
    @ ff282cd), staging only the installer's own surface.
    Loom-Trace-Id: 038dce5d677bceeeca3c111787ac5b68
    Loom-Build: unknown unknown unknown
    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
2026-10-01 chore: resync installed Loom surfaces
    <!-- loom:provenance v1 build=unknown 126c80914e42f913c4fc778d3ddce96daa2c7a77 clean prompts=none sweep=none story=none trace=15a20fbea7a00d0922b943088c80e19d host=loom-worker-1 base=af34788b6d7ab5c9eab9de10fc3d21cb0a7bc7af run=loom-run/v1:script:loom-worker-1/fleet-resync:ecc423da-4625-49de-b25a-692fd669a029 installs=0.19.612 d47e0c57a6bea6f7b61ef9ce62632d70c39ef5d5 -->
    Loom-Trace-Id: 15a20fbea7a00d0922b943088c80e19d
    Loom-Build: unknown 126c80914e42f913c4fc778d3ddce96daa2c7a77 clean
    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
2026-10-01 chore: resync installed Loom surfaces
    <!-- loom:provenance v1 build=unknown 126c80914e42f913c4fc778d3ddce96daa2c7a77 clean prompts=none sweep=none story=none trace=a0a42bd10fcfa6d7cbcc9c021c406848 host=loom-worker-2 base=82568b4c8a0b0097051532da36c19b8e21911897 run=loom-run/v1:timer:loom-worker-2/fleet-resync:9e174e6bb0fa41d786e4a86e45632b6f installs=0.19.612 6f0871dc66e62b36d8382ced980d2805bfd97e50 -->
    Loom-Trace-Id: a0a42bd10fcfa6d7cbcc9c021c406848
    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
2026-10-01 chore: resync installed Loom surfaces
    <!-- loom:provenance v1 build=unknown 6f3411c8a63e68097dde01bce8a8422230f54218 clean prompts=none sweep=none story=none trace=9aa0a46bb352b9665fdaa5f5b3b85dd7 host=robb-pro base=f41ba1c70aa399bca103754e201a1796e1250bbd run=loom-run/v1:timer:robb-pro/fleet-resync:ca419e1d-6646-4678-ac7a-b263e4b5119e installs=0.19.612 7731400b3e3e1df39074564166edf656feb0999c -->
    Loom-Trace-Id: 9aa0a46bb352b9665fdaa5f5b3b85dd7
    Loom-Build: unknown 6f3411c8a63e68097dde01bce8a8422230f54218 clean
    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
2026-10-02 chore: resync installed Loom surfaces
    <!-- loom:provenance v1 build=unknown 13c0a3ef467a888520a6529ab34486ab8be826be clean prompts=none sweep=none story=none trace=41356080f367e491d5ff03f17bb98c27 host=loom-worker-2 base=d806805b2af1cf18da5f86513f44661a2a555eaf run=loom-run/v1:timer:loom-worker-2/fleet-resync:44455fbcbab745abb92cea192fafbb1d installs=0.19.614 3c79f7b1d0cc14723e049cff4250ff7330804326 -->
    Loom-Trace-Id: 41356080f367e491d5ff03f17bb98c27
    Loom-Build: unknown 13c0a3ef467a888520a6529ab34486ab8be826be clean
    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
2026-10-02 spec: ratify DR-0026 per operator review (#261), correct ratification header
    Loom-Story: 2AMLogic/gf180-ldo#261
    Loom-Trace-Id: 91766aa48e60cef87d34a6375bc084dc
    Loom-Build: 0.19.606 e922817979378fce79257750fc4b6fc70cf717be clean
2026-10-02 chore: resync installed Loom surfaces
    <!-- loom:provenance v1 build=unknown 6f3411c8a63e68097dde01bce8a8422230f54218 clean prompts=none sweep=none story=none trace=acb28d0049e0cc75536f96d503f6e814 host=robb-studio base=68029d9b858f2c2a45bbe2392c5fdf0e7c412ce6 run=loom-run/v1:timer:robb-studio/fleet-resync:85d2b1b5-e81d-40c3-ab6a-9a00efbc4ee2 installs=0.19.616 d86523eeadb32b95777f3cd3a76dd2f72f0bf792 -->
    Loom-Trace-Id: acb28d0049e0cc75536f96d503f6e814
    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
2026-10-02 chore: resync installed Loom surfaces
    <!-- loom:provenance v1 build=unknown 2b50bd69eddd038dd738465aa58a9ebca11410ac clean prompts=none sweep=none story=none trace=324e4f607054d0396cfdf8fdc01e93ae host=robb-pro base=3c3bf3fa4ec7270f1847d0dd7c4aa7c996e1cb10 run=loom-run/v1:timer:robb-pro/fleet-resync:a63799f1-2ad7-4946-b81d-2ec231bc2d2f installs=0.19.617 81cb2ad7e091b19d6a2b95d1add6938c2100d46b -->
    Loom-Trace-Id: 324e4f607054d0396cfdf8fdc01e93ae
    Loom-Build: unknown 2b50bd69eddd038dd738465aa58a9ebca11410ac clean
    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
2026-10-02 chore: resync installed Loom surfaces
    <!-- loom:provenance v1 build=unknown 00d92b326aed50280cd90dc116b7caec27668251 clean prompts=none sweep=none story=none trace=9a5d23cc82b6d3a1c83bfee47bd04970 host=loom-worker-2 base=eecb358130b380ef16f90035c3dc7cac098f149f run=loom-run/v1:timer:loom-worker-2/fleet-resync:12136a7a025d49f3a60b5edb04a3ff81 installs=0.19.619 4c0f505e4f0b76f8ccec07bda6d8b839030c077b -->
    Loom-Trace-Id: 9a5d23cc82b6d3a1c83bfee47bd04970
    Loom-Build: unknown 00d92b326aed50280cd90dc116b7caec27668251 clean
    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
2026-10-02 chore: resync installed Loom surfaces
    <!-- loom:provenance v1 build=unknown 456dad6d90259846313dc3bb80bf4e5471ef2d76 clean prompts=none sweep=none story=none trace=bb9688c03fb5211d06f48c8838a5505c host=robb-studio base=371138e9cd278346151cd99b3e6f5383c658b83f run=loom-run/v1:timer:robb-studio/fleet-resync:e965c017-8ec7-485d-b46e-aeb399b81fb4 installs=0.19.620 0d28ba49f5a88fdb37271de9cb0144eb3442c6e3 -->
    Loom-Trace-Id: bb9688c03fb5211d06f48c8838a5505c
    Loom-Build: unknown 456dad6d90259846313dc3bb80bf4e5471ef2d76 clean
    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
2026-10-02 chore: resync installed Loom surfaces
    <!-- loom:provenance v1 build=unknown 6c6d2b6565dc13eff4c6811b9c670f452106516b clean prompts=none sweep=none story=none trace=539be979ae694d66ede516a7b5d17e41 host=robb-pro base=77ec3a05d45dffb79077b0d48307de4350c6998d run=loom-run/v1:timer:robb-pro/fleet-resync:9444d216-de08-442f-8352-ba59f6e81bb3 installs=0.19.621 a90dc1d794eb9ff70aaf939ebf495abe716f3bdd -->
    Loom-Trace-Id: 539be979ae694d66ede516a7b5d17e41
    Loom-Build: unknown 6c6d2b6565dc13eff4c6811b9c670f452106516b clean
    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
2026-10-02 chore: resync installed Loom surfaces
    <!-- loom:provenance v1 build=unknown f6d28134bfe476967e005d97424073085f55e8a3 clean prompts=none sweep=none story=none trace=27eb90670d441065f593e941066ee005 host=loom-worker-2 base=126151a51607949ac76eca4322508878551f925b run=loom-run/v1:timer:loom-worker-2/fleet-resync:04001bba930241cf9e325bf304a9270a installs=0.19.623 ccc19c2bbe2aa65328427730fa53f70eb56128c6 -->
    Loom-Trace-Id: 27eb90670d441065f593e941066ee005
    Loom-Build: unknown f6d28134bfe476967e005d97424073085f55e8a3 clean
    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
2026-10-02 chore: resync installed Loom surfaces
    <!-- loom:provenance v1 build=unknown bc461736314499b6c2c4c0ad51fb2294f60336f5 clean prompts=none sweep=none story=none trace=c3ea68717dd3a908dbbd60a35bc8b5d6 host=robb-studio base=71d8a5cff5f6c72ff978d6683305eb7ab17d1f4b run=loom-run/v1:timer:robb-studio/fleet-resync:8d4c49e2-3258-4080-b0c8-082499053654 installs=0.19.623 a50aaf70069f8897c41a64b7d90783c5ab8294e0 -->
    Loom-Trace-Id: c3ea68717dd3a908dbbd60a35bc8b5d6
    Loom-Build: unknown bc461736314499b6c2c4c0ad51fb2294f60336f5 clean
    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
2026-10-02 chore: resync installed Loom surfaces
    <!-- loom:provenance v1 build=unknown bc461736314499b6c2c4c0ad51fb2294f60336f5 clean prompts=none sweep=none story=none trace=8bee8a664bfc89e0bbfbb3c2de7342ba host=loom-worker-2 base=2a46c76080b4c046864de893cd822c18eb272b38 run=loom-run/v1:timer:loom-worker-2/fleet-resync:de2ceceb48ea4927a1334d08dc0082fe installs=0.19.624 5f49564fa78ae06f8c48d5224dae9ded04200bb7 -->
    Loom-Trace-Id: 8bee8a664bfc89e0bbfbb3c2de7342ba
    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
2026-10-03 chore: resync installed Loom surfaces
    <!-- loom:provenance v1 build=unknown 752d316233ed1a3da9e4f69ad760eb99bb477747 clean prompts=none sweep=none story=none trace=7851839b67c00a023e97cbdea1f580e1 host=robb-pro base=54f8a03639d881f0feb4415f5a52f84f68786edd run=loom-run/v1:timer:robb-pro/fleet-resync:ae492b66-dca0-4da4-acab-8d26778f2d5c installs=0.19.624 121fac45f5006879bf58a18c951b9243d9099a18 -->
    Loom-Trace-Id: 7851839b67c00a023e97cbdea1f580e1
    Loom-Build: unknown 752d316233ed1a3da9e4f69ad760eb99bb477747 clean
    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
2026-10-03 chore: resync installed Loom surfaces
    <!-- loom:provenance v1 build=unknown b34a08286a42f47f917ec46647d4d167c1f5207c clean prompts=none sweep=none story=none trace=a8e453124b899b440f42c9d83837c7b6 host=loom-worker-2 base=19ce4bd5742125618e263fce824124ea4cc2013e run=loom-run/v1:timer:loom-worker-2/fleet-resync:f02dd5df715347fe90fe14b9353a1b66 installs=0.19.624 98c193cf0d12d68d3770edc1baad808c40bb5fd4 -->
    Loom-Trace-Id: a8e453124b899b440f42c9d83837c7b6
    Loom-Build: unknown b34a08286a42f47f917ec46647d4d167c1f5207c clean
    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
2026-10-03 chore: resync installed Loom surfaces
    <!-- loom:provenance v1 build=unknown 3437cece5ab759f772122f8d18a6d2f05d246cde clean prompts=none sweep=none story=none trace=1bd6b75d1c0daff2b433adf5999546a3 host=loom-worker-1 base=d74c7511a05819362b6e639901052ec5f17d43fb run=loom-run/v1:timer:loom-worker-1/fleet-resync:4c0abac1c29646eaa8502afa223bdd2b installs=0.19.624 0162badc662fb30c070e70611aa8ff74a8486d54 -->
    Loom-Trace-Id: 1bd6b75d1c0daff2b433adf5999546a3
    Loom-Build: unknown 3437cece5ab759f772122f8d18a6d2f05d246cde clean
    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
2026-10-03 chore: resync installed Loom surfaces
    <!-- loom:provenance v1 build=unknown 4a837731e7c550b7c0a339f295dc627ada67dbc0 clean prompts=none sweep=none story=none trace=fe84c9b169d979d00d78d11178a426a1 host=robb-pro base=2ac8f3c7a92afe3621e3f630bfd527ade218b751 run=loom-run/v1:timer:robb-pro/fleet-resync:a057372b-b02f-45ac-b297-ca847c70b0fc installs=0.19.634 e54b8a76ee0a907fb3c7fec91e10b0d6fccfbcc7 -->
    Loom-Trace-Id: fe84c9b169d979d00d78d11178a426a1
    Loom-Build: unknown 4a837731e7c550b7c0a339f295dc627ada67dbc0 clean
    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
2026-10-03 chore: resync installed Loom surfaces
    <!-- loom:provenance v1 build=unknown 8c947aea0026cdb7cda97ea20eea706c4daaf058 clean prompts=none sweep=none story=none trace=92f6c0e06b16dbd125642521ab3357c8 host=loom-worker-2 base=d14448a258457dbcce7387b366c8abac993d2f89 run=loom-run/v1:timer:loom-worker-2/fleet-resync:8b9c88fa9d4c443197e74a90600bb0c7 installs=0.19.636 e41edfbb52c13982f7d8b0577f42957427a6514c -->
    Loom-Trace-Id: 92f6c0e06b16dbd125642521ab3357c8
    Loom-Build: unknown 8c947aea0026cdb7cda97ea20eea706c4daaf058 clean
    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
2026-10-03 chore: resync installed Loom surfaces
    <!-- loom:provenance v1 build=unknown 28040ed11a4369e20f3b7b0154a3fb2a2c35d38c clean prompts=none sweep=none story=none trace=0cd87d01c45d97a2ee57a99363fc0db2 host=robb-studio base=925da1bab59236c746f52d9393cb1ef74bf4e1a0 run=loom-run/v1:timer:robb-studio/fleet-resync:74b93657-6b04-4ac5-bc77-e0a1682b0595 installs=0.19.636 e41edfbb52c13982f7d8b0577f42957427a6514c -->
    Loom-Trace-Id: 0cd87d01c45d97a2ee57a99363fc0db2
    Loom-Build: unknown 28040ed11a4369e20f3b7b0154a3fb2a2c35d38c clean
    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
2026-10-03 chore: resync installed Loom surfaces
    <!-- loom:provenance v1 build=unknown 388c7fe0cad997f7a887f70c9f2cfe8781a2d512 clean prompts=none sweep=none story=none trace=2046ffd42f138a06b914f34851de3440 host=loom-worker-2 base=4445dd8eb9b34ee3f102f5c8c1ff7084003421e5 run=loom-run/v1:timer:loom-worker-2/fleet-resync:17c9456bb1934c70a545b12081496cce installs=0.19.647 d1fe5dead4202be12a964ab891fd5980e7836170 -->
    Loom-Trace-Id: 2046ffd42f138a06b914f34851de3440
    Loom-Build: unknown 388c7fe0cad997f7a887f70c9f2cfe8781a2d512 clean
    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
2026-10-03 chore: resync installed Loom surfaces
    <!-- loom:provenance v1 build=unknown 8078c29e691123d91cd761a786f99cfd25f1809d clean prompts=none sweep=none story=none trace=45869a6374635c036a11a6f379fe31a4 host=robb-pro base=ed12e2383d6700b5e9d7784c61ccf0104f2cd83f run=loom-run/v1:timer:robb-pro/fleet-resync:b0a94991-052d-4e7d-ba2b-78b971096849 installs=0.19.647 709ca4396e074e5a4d1c5e19721f6ddac7154ca2 -->
    Loom-Trace-Id: 45869a6374635c036a11a6f379fe31a4
    Loom-Build: unknown 8078c29e691123d91cd761a786f99cfd25f1809d clean
    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
2026-10-03 chore: resync installed Loom surfaces
    <!-- loom:provenance v1 build=unknown f9cba29b0602624a23daa17ae04d31d82e10fa91 clean prompts=none sweep=none story=none trace=754b3688f97b6c34894d8cfbf272b81a host=loom-worker-1 base=0e45406e035e865dc7c0e938f6ae677e288c936c run=loom-run/v1:script:loom-worker-1/fleet-resync:11eb117a-9ff3-4411-88d4-fdd7d6748639 installs=0.19.649 6f2f13b1c31ce420e2250ae040d8e1050c0e761b -->
    Loom-Trace-Id: 754b3688f97b6c34894d8cfbf272b81a
    Loom-Build: unknown f9cba29b0602624a23daa17ae04d31d82e10fa91 clean
    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
2026-10-03 chore: resync installed Loom surfaces
    <!-- loom:provenance v1 build=unknown f9cba29b0602624a23daa17ae04d31d82e10fa91 clean prompts=none sweep=none story=none trace=544a028e3829d4020b8aaa144e5fa628 host=robb-studio base=5995794136e8f19fae891b152aa30df3cfe95075 run=loom-run/v1:script:robb-studio/fleet-resync:5b5b8b83-7139-447d-88bd-417dcf375aa6 installs=0.19.649 6f2f13b1c31ce420e2250ae040d8e1050c0e761b -->
    Loom-Trace-Id: 544a028e3829d4020b8aaa144e5fa628
    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
2026-10-03 chore: resync installed Loom surfaces
    <!-- loom:provenance v1 build=unknown f9cba29b0602624a23daa17ae04d31d82e10fa91 clean prompts=none sweep=none story=none trace=1057aaaf811f6dd2d64a3bb6d4b3ac49 host=robb-pro base=61c15882662a994436b7bbd8459d3fa60639f73e run=loom-run/v1:timer:robb-pro/fleet-resync:785c1ea0-d7f2-4810-99e9-cd9368aebe0c installs=0.19.649 2118aabb5a925f1ec4669b4d3d31176a46d8f2a6 -->
    Loom-Trace-Id: 1057aaaf811f6dd2d64a3bb6d4b3ac49
    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
2026-10-03 chore: resync installed Loom surfaces
    <!-- loom:provenance v1 build=unknown 72f61d9aa0fe08f1ef59f1a97a314e474455801e clean prompts=none sweep=none story=none trace=577d2185973ec59f059fa15bf5b5e514 host=loom-worker-1 base=b4cd896cf2fd7580e85b03c413f95305da07968d run=loom-run/v1:script:loom-worker-1/fleet-resync:5728a930-137f-4d2f-a962-1cdd7a6a1d46 installs=0.19.652 235a64727b907d65529151af0a962b14f16462a0 -->
    Loom-Trace-Id: 577d2185973ec59f059fa15bf5b5e514
    Loom-Build: unknown 72f61d9aa0fe08f1ef59f1a97a314e474455801e clean
    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
2026-10-03 chore: resync installed Loom surfaces
    <!-- loom:provenance v1 build=unknown 72f61d9aa0fe08f1ef59f1a97a314e474455801e clean prompts=none sweep=none story=none trace=845aaa0eb340f80f12095e2e8b421ed1 host=robb-pro base=ed2361c0b86bb4fe0681d07d1a5e4ae8e581647b run=loom-run/v1:script:robb-pro/fleet-resync:344add4b-df8a-49e8-8563-2765673acc76 installs=0.19.652 235a64727b907d65529151af0a962b14f16462a0 -->
    Loom-Trace-Id: 845aaa0eb340f80f12095e2e8b421ed1
    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
2026-10-03 chore: resync installed Loom surfaces
    <!-- loom:provenance v1 build=unknown 61870b40779d205c1555e801c6e1d95df083cdea clean prompts=none sweep=none story=none trace=cfd2c16d2cd3651ad0d068a28bbf62b8 host=loom-worker-1 base=db149d9c329211a7b319e28f0d3b1f3630adb3cf run=loom-run/v1:timer:loom-worker-1/fleet-resync:fd27683751ca428cb28a8d58a04fc51a installs=0.19.652 235a64727b907d65529151af0a962b14f16462a0 -->
    Loom-Trace-Id: cfd2c16d2cd3651ad0d068a28bbf62b8
    Loom-Build: unknown 61870b40779d205c1555e801c6e1d95df083cdea clean
    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
2026-10-03 chore: resync installed Loom surfaces
    <!-- loom:provenance v1 build=unknown 61870b40779d205c1555e801c6e1d95df083cdea clean prompts=none sweep=none story=none trace=f8c6a615535e3729d749bc44ac28436c host=robb-studio base=047576f47d94191326023fa95fde319ca3e7d18e run=loom-run/v1:script:robb-studio/fleet-resync:66678e69-bbef-41df-8a24-1d1ac846c831 installs=0.19.652 235a64727b907d65529151af0a962b14f16462a0 -->
    Loom-Trace-Id: f8c6a615535e3729d749bc44ac28436c
    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
2026-10-03 chore: resync installed Loom surfaces
    <!-- loom:provenance v1 build=unknown 21130104346fe9c464ce8a3fdf82c1d3e9667639 clean prompts=none sweep=none story=none trace=36308fff5a3c323c3d1bf6fffb6cd122 host=robb-studio base=9088d62be92f48f62fecd0e62e67738c7bc9a733 run=loom-run/v1:timer:robb-studio/fleet-resync:89972fbd-0774-4402-bbb7-26c33a851735 installs=0.19.652 fb69233bd8f1dfc2bdee37d8b934f99274dc0193 -->
    Loom-Trace-Id: 36308fff5a3c323c3d1bf6fffb6cd122
    Loom-Build: unknown 21130104346fe9c464ce8a3fdf82c1d3e9667639 clean
    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
2026-10-03 layout: make testcell gen_gds.py assertions audible via _fail()
    klayout -b -r swallows SystemExit (no message, exit 0), so the test cell
    generator's five PCell assertions were invisible; drclvs.py only reported
    the symptom ("layout build produced no ..."). Port the divider's _fail()
    helper, which writes to stderr (captured into build-gds.log) before
    exiting 1, and route all five sites through it.
    Diagnostics only: no change to geometry, schematic, or DRC/LVS verdicts.
    Adds layout/tests/test_testcell_gen_gds.py (stub-pya execution of the
    pre-geometry assertions plus a static no-bare-SystemExit check) and updates
    the README and gen_gds_common.py notes.
    Closes #296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
2026-10-04 chore: resync installed Loom surfaces
    <!-- loom:provenance v1 build=unknown 61870b40779d205c1555e801c6e1d95df083cdea clean prompts=none sweep=none story=none trace=fb9213e215442932d2af05f3b14977de host=robb-pro base=971b93b4a0c86afd1752a8784bc561408032f8e9 run=loom-run/v1:timer:robb-pro/fleet-resync:4c70cd1d-08cd-4add-8e2a-9a75160d163f installs=0.19.655 36c39e3c6f56e1979647ec235b4bd19c77db22f3 -->
    Loom-Trace-Id: fb9213e215442932d2af05f3b14977de
    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
2026-10-04 chore: resync installed Loom surfaces
    <!-- loom:provenance v1 build=unknown 61870b40779d205c1555e801c6e1d95df083cdea clean prompts=none sweep=none story=none trace=baa6c2cfcae1a320917c00ff2eb8b630 host=loom-worker-2 base=1ea312c84eaf092889e24fcf82b0b24c1649da48 run=loom-run/v1:timer:loom-worker-2/fleet-resync:741a7f0f16df4fb1be4e657aeacd1244 installs=0.19.655 fc667a4faae1227f8a6837431f8a0c2d0aeaa7dd -->
    Loom-Trace-Id: baa6c2cfcae1a320917c00ff2eb8b630
    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
2026-10-04 chore: resync installed Loom surfaces
    <!-- loom:provenance v1 build=unknown b922acb2ac655cbccd71daa9e3f05a325a094ca5 clean prompts=none sweep=none story=none trace=833eeb34d4ca65c3f8c6f7824ddca3a3 host=robb-studio base=8c90ab1274b9f069611494df3a6756d7d5a73258 run=loom-run/v1:timer:robb-studio/fleet-resync:0d44f6dc-6a62-4d43-b49d-7cfdd7dbd823 installs=0.19.663 0a51e373e7fe1be156c5774b2c827d4b745368a3 -->
    Loom-Trace-Id: 833eeb34d4ca65c3f8c6f7824ddca3a3
    Loom-Build: unknown b922acb2ac655cbccd71daa9e3f05a325a094ca5 clean
    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
2026-10-04 chore: resync installed Loom surfaces
    <!-- loom:provenance v1 build=unknown 746ecb5f9d7e64ba1d2526f1e997530ad4f3dd43 clean prompts=none sweep=none story=none trace=f09501431241df2ec5688e334ba43dfe host=loom-worker-2 base=42d62fe2d1b1a7b0f7e0428a788323950a12270c run=loom-run/v1:timer:loom-worker-2/fleet-resync:70797dad61fb4e21806716d54f1ce910 installs=0.19.669 59a1f84e3742827a8033bb153ebbedc1759bee72 -->
    Loom-Trace-Id: f09501431241df2ec5688e334ba43dfe
    Loom-Build: unknown 746ecb5f9d7e64ba1d2526f1e997530ad4f3dd43 clean
    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
2026-10-04 chore: resync installed Loom surfaces
    <!-- loom:provenance v1 build=unknown 8080d0485cc1312129ee642b084944c56d1be074 clean prompts=none sweep=none story=none trace=ed180bcab6828041123ad54d8ddb4037 host=robb-pro base=333b4b35ed296faa3197ffd20ea27d92dc195f27 run=loom-run/v1:timer:robb-pro/fleet-resync:e97b2f08-4ad9-4b66-a166-5b19820e2d1f installs=0.19.669 59a1f84e3742827a8033bb153ebbedc1759bee72 -->
    Loom-Trace-Id: ed180bcab6828041123ad54d8ddb4037
    Loom-Build: unknown 8080d0485cc1312129ee642b084944c56d1be074 clean
    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
2026-10-04 chore: resync installed Loom surfaces
    <!-- loom:provenance v1 build=unknown 83cb6647167ffc000d2c2f479b4e816b68f863f4 clean prompts=none sweep=none story=none trace=ccabffa1e1ba495895b262086030816c host=robb-studio base=8b0be172897825c8b1d4886f47ee4b022c30b463 run=loom-run/v1:timer:robb-studio/fleet-resync:88a78f1f-d978-47b5-99c3-2aabde811d17 installs=0.19.676 cd4f30bd892ea2595d8218b08150633504b0dd14 -->
    Loom-Trace-Id: ccabffa1e1ba495895b262086030816c
    Loom-Build: unknown 83cb6647167ffc000d2c2f479b4e816b68f863f4 clean
    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
2026-10-04 chore: resync installed Loom surfaces
    <!-- loom:provenance v1 build=unknown 32174d0f7e80508fa66c1a11a2c0fb28c515607e clean prompts=none sweep=none story=none trace=436d7c19b10cd5807625a7ce7190a82f host=loom-worker-2 base=7906b01e519b6ae549cc0aecddb440ff2841df6e run=loom-run/v1:timer:loom-worker-2/fleet-resync:19ae50771cc04d8db7b1403c1e66bbea installs=0.19.682 9eccfa110fa294fa32a62ffe8eff669cfcf1a3a6 -->
    Loom-Trace-Id: 436d7c19b10cd5807625a7ce7190a82f
    Loom-Build: unknown 32174d0f7e80508fa66c1a11a2c0fb28c515607e clean
    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
2026-10-04 chore: resync installed Loom surfaces
    <!-- loom:provenance v1 build=unknown 72290fa960e0773b2c50d74042e24914c7327637 clean prompts=none sweep=none story=none trace=f7b6952a649a174398a48b90b6ab4793 host=robb-pro base=2bffecaeaeaaa32595c24f850771fd281df16fb1 run=loom-run/v1:timer:robb-pro/fleet-resync:72f32482-5cc4-4b38-ab9e-4d2ef0b64e94 installs=0.19.684 bdb8fb331eb51c7def4cdd2c38b611af06f25f6d -->
    Loom-Trace-Id: f7b6952a649a174398a48b90b6ab4793
    Loom-Build: unknown 72290fa960e0773b2c50d74042e24914c7327637 clean
    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
2026-10-04 chore: resync installed Loom surfaces
    <!-- loom:provenance v1 build=unknown 76cda58637be0e74c4cb5b4c8dbc2000e2a9c3d4 clean prompts=none sweep=none story=none trace=614cbada5ce873c2b34a511816309cfc host=robb-studio base=2b9f0eeb774a8a3ab35c6d7c8d851cadbe2da287 run=loom-run/v1:timer:robb-studio/fleet-resync:7e559a3b-ffdd-409b-8dd2-ae906a273b0a installs=0.19.692 d4974b9f5ff7843a3cfc06378ea2a69bc120e0f4 -->
    Loom-Trace-Id: 614cbada5ce873c2b34a511816309cfc
    Loom-Build: unknown 76cda58637be0e74c4cb5b4c8dbc2000e2a9c3d4 clean
    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
2026-10-04 chore: resync installed Loom surfaces
    <!-- loom:provenance v1 build=unknown f84bac5c232c093f83c1adc2533d8c75b021cda2 clean prompts=none sweep=none story=none trace=e687830614e4bd1c551ab6cf6186f8f3 host=loom-worker-2 base=1676d2777809ab2f81fdd317e190ebb36f5c79a5 run=loom-run/v1:timer:loom-worker-2/fleet-resync:2db2c4373ac24de1b7a364e69eaea1ca installs=0.19.695 b0d5b09f207fda439390ea1dd249ad10e7009dfc -->
    Loom-Trace-Id: e687830614e4bd1c551ab6cf6186f8f3
    Loom-Build: unknown f84bac5c232c093f83c1adc2533d8c75b021cda2 clean
    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
2026-10-04 chore: resync installed Loom surfaces
    <!-- loom:provenance v1 build=unknown ac5c275d1c616a9723e747f5a66de93dc80d3512 clean prompts=none sweep=none story=none trace=c777c3912bd31972e9aa3ccab712ae01 host=loom-worker-1 base=0ca8d3f0656dd5a4de2775cc9f0804da37c01f90 run=loom-run/v1:script:loom-worker-1/fleet-resync:b51a1b33-4958-4408-be36-166e12e8360b installs=0.19.697 ada83a5c7ff66b56b0060ef0be368c9fe56eb3c6 -->
    Loom-Trace-Id: c777c3912bd31972e9aa3ccab712ae01
    Loom-Build: unknown ac5c275d1c616a9723e747f5a66de93dc80d3512 clean
    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
2026-10-04 chore: resync installed Loom surfaces
    <!-- loom:provenance v1 build=unknown a19f642f5c09599c4c64827d81d228eb031be73e clean prompts=none sweep=none story=none trace=34a80e22764eb5055e37faec0eaf65fb host=robb-pro base=f8ec5a23941e03128990ac31c6cb4bd9c66e208a run=loom-run/v1:script:robb-pro/fleet-resync:689be620-3ff2-4ff5-a2ce-f6825f6379e2 installs=0.19.697 ada83a5c7ff66b56b0060ef0be368c9fe56eb3c6 -->
    Loom-Trace-Id: 34a80e22764eb5055e37faec0eaf65fb
    Loom-Build: unknown a19f642f5c09599c4c64827d81d228eb031be73e clean
    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
2026-10-04 chore: resync installed Loom surfaces
    <!-- loom:provenance v1 build=unknown 693bdd794cb34afdefd7f0c4596824cd53078a61 clean prompts=none sweep=none story=none trace=7e7be58c80b40f1ac882b00139fb0ca0 host=robb-pro base=1f680b321530ee3a517ffdf627d921160eaaffba run=loom-run/v1:timer:robb-pro/fleet-resync:d64fbd6b-5d9b-491d-9e17-742b375bfba7 installs=0.19.698 aa619a1d07e36e8d90ac01fea63dc39285c93567 -->
    Loom-Trace-Id: 7e7be58c80b40f1ac882b00139fb0ca0
    Loom-Build: unknown 693bdd794cb34afdefd7f0c4596824cd53078a61 clean
    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
2026-10-04 chore: resync installed Loom surfaces
    <!-- loom:provenance v1 build=unknown 693bdd794cb34afdefd7f0c4596824cd53078a61 clean prompts=none sweep=none story=none trace=aa18f1ec102a98d77ffc51c9be6ffbb3 host=robb-studio base=d7d884519c0d6c4c87a0de19b38eba811aa5f86a run=loom-run/v1:script:robb-studio/fleet-resync:3cb89ca8-62c2-4a69-8434-c4aaa3b64eaf installs=0.19.698 a58f00e0681c50d6bfc5089d0af4b3715198319f -->
    Loom-Trace-Id: aa18f1ec102a98d77ffc51c9be6ffbb3
    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
2026-10-04 chore: resync installed Loom surfaces
    <!-- loom:provenance v1 build=unknown 7a41c2e69ef89d60ed3bd190b94838021bf18d0f clean prompts=none sweep=none story=none trace=d0f04f38b507d85402723643fcf47197 host=loom-worker-1 base=366f0e76519f6339b94ad11f37c64ca71bded771 run=loom-run/v1:script:loom-worker-1/fleet-resync:8fdc8c1c-f844-4c33-bc80-b424e5b4cf3d installs=0.19.703 89d5a428c652f957d7fad8a546589042d39911bc -->
    Loom-Trace-Id: d0f04f38b507d85402723643fcf47197
    Loom-Build: unknown 7a41c2e69ef89d60ed3bd190b94838021bf18d0f clean
    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
2026-10-05 chore: resync installed Loom surfaces
    <!-- loom:provenance v1 build=unknown ebb37db560de172930e261675a35bd52e429f650 clean prompts=none sweep=none story=none trace=a40e86a64366c7a1e36aea026901334f host=loom-worker-2 base=3c1895c79dfc38e27bbc0308e5f9167bad0b2398 run=loom-run/v1:script:loom-worker-2/fleet-resync:90b6cd74-6cc0-4f58-98ee-6ede0ac6f50c installs=0.19.703 f63c3c82e6bf202f2ca7b205b532f681c5ebb2c8 -->
    Loom-Trace-Id: a40e86a64366c7a1e36aea026901334f
    Loom-Build: unknown ebb37db560de172930e261675a35bd52e429f650 clean
    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
2026-10-05 chore: resync installed Loom surfaces
    <!-- loom:provenance v1 build=unknown 7a41c2e69ef89d60ed3bd190b94838021bf18d0f clean prompts=none sweep=none story=none trace=fc04851db12f586b5d58155325131b6e host=robb-studio base=be1971159d79f26d2feb54f8632de7dc8e162ce7 run=loom-run/v1:timer:robb-studio/fleet-resync:a7d5da6f-a896-4d6f-8d00-aebf47f9b266 installs=0.19.703 2ad9a08fb93de4d7dfac9d2b501d12c684c9c2cc -->
    Loom-Trace-Id: fc04851db12f586b5d58155325131b6e
    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
2026-10-05 chore: resync installed Loom surfaces
    <!-- loom:provenance v1 build=unknown afe7e99e397c242cc319fa80702fb3b23e23f5a7 clean prompts=none sweep=none story=none trace=e46782e1dd9c94461b4cf934ce05296b host=loom-worker-2 base=345b82d3a5d04ac2303628565577fd984baab06b run=loom-run/v1:timer:loom-worker-2/fleet-resync:caa89259b1fd414ebd2f07500621166d installs=0.19.703 972fe7321be6a9efe2653579379ea3bc40b899b2 -->
    Loom-Trace-Id: e46782e1dd9c94461b4cf934ce05296b
    Loom-Build: unknown afe7e99e397c242cc319fa80702fb3b23e23f5a7 clean
    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
2026-10-05 chore: resync installed Loom surfaces
    <!-- loom:provenance v1 build=unknown b44cb904ebb599db793066ccc631c846862abfbd clean prompts=none sweep=none story=none trace=9590fed7c1b1c9f549ccf3cba24292d7 host=robb-pro base=0fbc1e4909d2762917f150de9d4c1a2e91536642 run=loom-run/v1:timer:robb-pro/fleet-resync:dbc6174e-403d-422d-98b6-73a4b6dbf44f installs=0.19.708 dc8faf1eae3143feda6301887c303b1ee45db7f4 -->
    Loom-Trace-Id: 9590fed7c1b1c9f549ccf3cba24292d7
    Loom-Build: unknown b44cb904ebb599db793066ccc631c846862abfbd clean
    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
2026-10-05 chore: resync installed Loom surfaces
    <!-- loom:provenance v1 build=unknown 4548905848fcb7cb875c1c0518f2fd88eb65818e clean prompts=none sweep=none story=none trace=aff5e139797705f6fa0811f102ecd103 host=loom-worker-1 base=5e005c49176bc5fc06b1ca25ddb1d2f2193a2964 run=loom-run/v1:timer:loom-worker-1/fleet-resync:ba6a9e5686a64abaa842d71acaeae2ca installs=0.19.718 00d99344506bcf00e1aec7e910abe3d13df2d240 -->
    Loom-Trace-Id: aff5e139797705f6fa0811f102ecd103
    Loom-Build: unknown 4548905848fcb7cb875c1c0518f2fd88eb65818e clean
    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
2026-10-05 chore: resync installed Loom surfaces
    <!-- loom:provenance v1 build=unknown e7efbaa6e7b97a7d72da6032044c67525291f4d1 clean prompts=none sweep=none story=none trace=d74a33a6f35e329b3e795991e790ebfd host=robb-studio base=5bb21904e9cfc8476d6c3de09cfc1ee1375c41a2 run=loom-run/v1:timer:robb-studio/fleet-resync:304f49c8-5b3e-46a9-a557-945b9ae177f0 installs=0.19.718 00d99344506bcf00e1aec7e910abe3d13df2d240 -->
    Loom-Trace-Id: d74a33a6f35e329b3e795991e790ebfd
    Loom-Build: unknown e7efbaa6e7b97a7d72da6032044c67525291f4d1 clean
    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
2026-10-05 chore: resync installed Loom surfaces
    <!-- loom:provenance v1 build=unknown 347b71e65e709d9fd49aba75d3fb67877fc08818 clean prompts=none sweep=none story=none trace=f9653dd318724c98136e7cef63e551ed host=robb-pro base=10e9236d1284af33d9655d59def7087683873db5 run=loom-run/v1:timer:robb-pro/fleet-resync:cdc95970-9fb1-49fa-a0e6-037a3fab2099 installs=0.19.728 991dcebf6f6b2de6571f1d3400bec083498c6438 -->
    Loom-Trace-Id: f9653dd318724c98136e7cef63e551ed
    Loom-Build: unknown 347b71e65e709d9fd49aba75d3fb67877fc08818 clean
    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
2026-10-05 chore: resync installed Loom surfaces
    <!-- loom:provenance v1 build=unknown 5c0d18101f48fecb656f10fa37afa9b09bf41631 clean prompts=none sweep=none story=none trace=ddcf49552af364cbf6e884bd59584c1f host=loom-worker-1 base=a7d7c33d54c92b3f6e70b05e016c3f8cc7979663 run=loom-run/v1:timer:loom-worker-1/fleet-resync:5eb526a05f244f1985770579e7620ff1 installs=0.19.731 7484b71fce5179a025950e71a82855afaf6fd730 -->
    Loom-Trace-Id: ddcf49552af364cbf6e884bd59584c1f
    Loom-Build: unknown 5c0d18101f48fecb656f10fa37afa9b09bf41631 clean
    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
2026-10-05 chore: resync installed Loom surfaces
    <!-- loom:provenance v1 build=unknown 0b160514b6658e3ab26a71c6525791da25b46fcf clean prompts=none sweep=none story=none trace=311c3eb2c0ab9550d3de38df5523f3d7 host=robb-studio base=a2e2839ff210b845a8a195a92870d5111e03891a run=loom-run/v1:timer:robb-studio/fleet-resync:e6dec631-b42b-4cf2-b854-cc363cfde6e0 installs=0.19.731 d6146becf339a3d4e55e26e8807ac4571213a00b -->
    Loom-Trace-Id: 311c3eb2c0ab9550d3de38df5523f3d7
    Loom-Build: unknown 0b160514b6658e3ab26a71c6525791da25b46fcf clean
    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
2026-10-05 chore: resync installed Loom surfaces
    <!-- loom:provenance v1 build=unknown 5c0d18101f48fecb656f10fa37afa9b09bf41631 clean prompts=none sweep=none story=none trace=f1e8d4c6e73b8eec3e87a8da52e10f2d host=robb-pro base=d31e0a0913660ce01eaf2f6576b132858327d9f7 run=loom-run/v1:timer:robb-pro/fleet-resync:5518fd33-81cb-479f-93f0-287ea4b08876 installs=0.19.732 8592cf72c2d9172ec658f717173b6b18c439d06d -->
    Loom-Trace-Id: f1e8d4c6e73b8eec3e87a8da52e10f2d
    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
2026-10-05 chore: resync installed Loom surfaces
    <!-- loom:provenance v1 build=unknown ca170d11544ef499cc9500a45bbad152edacfbd1 clean prompts=none sweep=none story=none trace=6dcfc713b6a851b40932158c2eeb70af host=loom-worker-3 base=896b9ab5cff3c7191d8e58ceb639451fb11bbb60 run=loom-run/v1:timer:loom-worker-3/fleet-resync:20ce0908ea5a468a9e055470104047ed installs=0.19.734 7ba6ea50c36dfdd2b5e2922dd22c65560980a5a2 -->
    Loom-Trace-Id: 6dcfc713b6a851b40932158c2eeb70af
    Loom-Build: unknown ca170d11544ef499cc9500a45bbad152edacfbd1 clean
    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
2026-10-05 chore: resync installed Loom surfaces
    <!-- loom:provenance v1 build=unknown 03f1c42302d15f8a83425a84a4e36ca484f3f625 clean prompts=none sweep=none story=none trace=f1bc879f8aa652d550764ffcd36e27d1 host=loom-worker-1 base=ed20c3a6ca9023e5f9fae97a51644b34b7c2bc2c run=loom-run/v1:timer:loom-worker-1/fleet-resync:f302a3cc8558413492093df510b02418 installs=0.19.734 967abe71d019ce6606018b4e57dee0223b84d96f -->
    Loom-Trace-Id: f1bc879f8aa652d550764ffcd36e27d1
    Loom-Build: unknown 03f1c42302d15f8a83425a84a4e36ca484f3f625 clean
    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
2026-10-05 chore: resync installed Loom surfaces
    <!-- loom:provenance v1 build=unknown ce7557ba58624d48fedbca2bc037dfa8ce3943e7 clean prompts=none sweep=none story=none trace=e1f2558834c47835cd9a53ec8c9a2ffa host=loom-worker-3 base=26155192c4c4278067d3d0ae9b30e7b5b47dc376 run=loom-run/v1:timer:loom-worker-3/fleet-resync:50f5f0046e2c4890961b3221bd360247 installs=0.19.734 ba9edb650872e5265eaca0c47f75e3cb828ecad2 -->
    Loom-Trace-Id: e1f2558834c47835cd9a53ec8c9a2ffa
    Loom-Build: unknown ce7557ba58624d48fedbca2bc037dfa8ce3943e7 clean
    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
2026-10-05 chore: resync installed Loom surfaces
    <!-- loom:provenance v1 build=unknown f92eaec38470a7b0732e065f4864faec9a1905d6 clean prompts=none sweep=none story=none trace=07aa020a8179d52651250562e9808b98 host=robb-studio base=7695f55e5559b2a2776c6fada2e4e31c4fff3e66 run=loom-run/v1:timer:robb-studio/fleet-resync:3b3ebdf2-b5f7-48ed-b7bb-5fb945094061 installs=0.19.734 78f3e99c44d0af6d4598adf7577bb6676baf3e8f -->
    Loom-Trace-Id: 07aa020a8179d52651250562e9808b98
    Loom-Build: unknown f92eaec38470a7b0732e065f4864faec9a1905d6 clean
    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
2026-10-06 chore: resync installed Loom surfaces
    <!-- loom:provenance v1 build=unknown ca170d11544ef499cc9500a45bbad152edacfbd1 clean prompts=none sweep=none story=none trace=fca9c14d74d6d634726f5823c51bc62a host=loom-worker-2 base=8e489d110c60eedf3119dea6f42be782b645298d run=loom-run/v1:timer:loom-worker-2/fleet-resync:23a23f0878c1494cb720941baddfea81 installs=0.19.741 3cede3920c6b567d5400789187a904970d46b0fb -->
    Loom-Trace-Id: fca9c14d74d6d634726f5823c51bc62a
    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
2026-10-06 fix(sim/loop-stability): drop dead Xsoftstart.CLG nodeset from dc_seed_lines (#307)
    Loom-Story: 2AMLogic/gf180-ldo#307
    Loom-Trace-Id: 4a03b2c53910b29b0441ea077516ac7f
    Loom-Build: 0.19.732 c1ef52e4d1926fd6f224abe962829326121161da clean
    [test_loop_stability.py]
2026-10-06 chore: resync installed Loom surfaces
    <!-- loom:provenance v1 build=unknown e38a22941348fd8e83d1f4b06130d2a214adfb50 clean prompts=none sweep=none story=none trace=a7fe3a9a1fedfce89846c20f2e98ac31 host=robb-pro base=51efb880a80e828940f7a2868a561b43712576d0 run=loom-run/v1:timer:robb-pro/fleet-resync:2d770a42-f0e7-4695-abfa-b912e75382e6 installs=0.19.744 8bc5bcce93c4d9721817387afe8b4b6d79f26054 -->
    Loom-Trace-Id: a7fe3a9a1fedfce89846c20f2e98ac31
    Loom-Build: unknown e38a22941348fd8e83d1f4b06130d2a214adfb50 clean
    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
2026-10-06 chore: resync installed Loom surfaces
    <!-- loom:provenance v1 build=unknown f66ea90ff1bdec51aa4c8dc3f4b2e8d26e3dfd2d clean prompts=none sweep=none story=none trace=66d96c3bb00b04fae967865ee02fc4de host=loom-worker-3 base=047362c4d59f10c64584d191fff753d3e8b2e9e2 run=loom-run/v1:timer:loom-worker-3/fleet-resync:eb2dceb410e848a19d58f96f678c995e installs=0.19.749 6135634b053dc30ef5aa8e6d733bfe79bb2ac734 -->
    Loom-Trace-Id: 66d96c3bb00b04fae967865ee02fc4de
    Loom-Build: unknown f66ea90ff1bdec51aa4c8dc3f4b2e8d26e3dfd2d clean
    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
2026-10-06 chore: resync installed Loom surfaces
    <!-- loom:provenance v1 build=unknown ade8a2c60cc8370d04d72f331141acb6fb32e121 clean prompts=none sweep=none story=none trace=6245fb88b5bdf9f7ccecb6b2168dc335 host=robb-studio base=ea98c516fe09fae01514afc87adddfcc69b11663 run=loom-run/v1:timer:robb-studio/fleet-resync:b305aed2-1a25-4576-aca7-9b017ac4377e installs=0.19.755 8d97d322e1cb3723988504337089beca73d0511c -->
    Loom-Trace-Id: 6245fb88b5bdf9f7ccecb6b2168dc335
    Loom-Build: unknown ade8a2c60cc8370d04d72f331141acb6fb32e121 clean
    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
2026-10-06 chore: resync installed Loom surfaces
    <!-- loom:provenance v1 build=unknown 2489bb7d5203844b3fbe8efbe007f44aa074685d clean prompts=none sweep=none story=none trace=0b5c9263a55c09e6fbd870b2d9ff5d9b host=loom-worker-2 base=5221e6b3e44590c6b0a42ed9b04980580c3c10fe run=loom-run/v1:timer:loom-worker-2/fleet-resync:d3f5a5beb1144f72ac8be575767b3e03 installs=0.19.760 3a509582b179d91c2d5b5a65a7ba4650c3c08985 -->
    Loom-Trace-Id: 0b5c9263a55c09e6fbd870b2d9ff5d9b
    Loom-Build: unknown 2489bb7d5203844b3fbe8efbe007f44aa074685d clean
    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
2026-10-06 chore: resync installed Loom surfaces
    <!-- loom:provenance v1 build=unknown 986d16b700174622774ff68af4ef323e8d0e23ba clean prompts=none sweep=none story=none trace=cb518f1f5785c258556383940a46c461 host=loom-worker-1 base=c23c1fe54ac051996e0cefebab63973ba06dd8b3 run=loom-run/v1:timer:loom-worker-1/fleet-resync:97df92c5eca846de85e979810663a94b installs=0.19.765 c6cec65c4f320f11153c72e840e49a5d6a6f1afc -->
    Loom-Trace-Id: cb518f1f5785c258556383940a46c461
    Loom-Build: unknown 986d16b700174622774ff68af4ef323e8d0e23ba clean
    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
2026-10-06 chore: resync installed Loom surfaces
    <!-- loom:provenance v1 build=unknown 85e52221261264d7f7643251de706f00c8db289f clean prompts=none sweep=none story=none trace=a2434124d73d8cca0ca77230fc85adf5 host=robb-pro base=7879fdb4e095ad99c58c9d2f92e891b374327344 run=loom-run/v1:timer:robb-pro/fleet-resync:abffb067-59ed-4a6e-94b6-8cf3500c935c installs=0.19.768 c9f7ca975144d991bce40f492403b8292e8b7fae -->
    Loom-Trace-Id: a2434124d73d8cca0ca77230fc85adf5
    Loom-Build: unknown 85e52221261264d7f7643251de706f00c8db289f clean
    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
2026-10-06 chore: resync installed Loom surfaces
    <!-- loom:provenance v1 build=unknown 31b34ebfd7d4539094523eaa7b56a104bebe5fc0 clean prompts=none sweep=none story=none trace=16fac36f144dc183c71465eb36c89afc host=loom-worker-3 base=f82ff87cd2703b9f33664176ea2c99a8e50e4b8b run=loom-run/v1:timer:loom-worker-3/fleet-resync:c763e24590314b918c8ee8df5d2de1db installs=0.19.769 af995a5725fdadf708127f006aa8f248b482d7d7 -->
    Loom-Trace-Id: 16fac36f144dc183c71465eb36c89afc
    Loom-Build: unknown 31b34ebfd7d4539094523eaa7b56a104bebe5fc0 clean
    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
2026-10-06 chore: resync installed Loom surfaces
    <!-- loom:provenance v1 build=unknown 7bed309263b3785eae46a9cbc53b3b24a52b10d2 clean prompts=none sweep=none story=none trace=843adbd5eac450c43d3a2c43da1bf729 host=robb-studio base=c9da7363f92f7f6eb29a519fcd983a5f9f101249 run=loom-run/v1:timer:robb-studio/fleet-resync:f83d5ba4-81f7-479a-9768-6af33d4cc825 installs=0.19.783 a9b459e0c2b1916ceb116db33053e7eb0df57e7b -->
    Loom-Trace-Id: 843adbd5eac450c43d3a2c43da1bf729
    Loom-Build: unknown 7bed309263b3785eae46a9cbc53b3b24a52b10d2 clean
    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
2026-10-06 chore: resync installed Loom surfaces
    <!-- loom:provenance v1 build=unknown 07bc40ba9ab0f7dfe7cd0990377b7ac07a52d220 clean prompts=none sweep=none story=none trace=563f186108419cf03cef002a62c3b201 host=loom-worker-2 base=fa103ed49f9de191acf47933525cdb3133de376b run=loom-run/v1:timer:loom-worker-2/fleet-resync:944beccd157a4197b81feafdd19f443e installs=0.19.785 2f0a9dbb4f06053f747b8a5615a3519f8e30b527 -->
    Loom-Trace-Id: 563f186108419cf03cef002a62c3b201
    Loom-Build: unknown 07bc40ba9ab0f7dfe7cd0990377b7ac07a52d220 clean
    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
2026-10-06 chore: resync installed Loom surfaces
    <!-- loom:provenance v1 build=unknown 31b34ebfd7d4539094523eaa7b56a104bebe5fc0 clean prompts=none sweep=none story=none trace=ea6600df41a4b420b6d8e967f839ccfd host=loom-worker-3 base=bfebe54cc2b650841a819fc93e6309b740b37c76 run=loom-run/v1:timer:loom-worker-3/fleet-resync:c80415b48fd5404bbd599c4f6cc8a448 installs=0.19.793 7ceff96944c39d33e3c2f1141ca650c2c4c05679 -->
    Loom-Trace-Id: ea6600df41a4b420b6d8e967f839ccfd
    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
2026-10-06 chore: resync installed Loom surfaces
    <!-- loom:provenance v1 build=unknown 596a53e525683919daae1b43e6babe9bf847a02f clean prompts=none sweep=none story=none trace=b9c0cb42a5a72ecc21726229c957ef1f host=loom-worker-2 base=4e0bbb97be75543dbc3ba990f9313d61f8c19f77 run=loom-run/v1:timer:loom-worker-2/fleet-resync:21d578f5cc0b4b7ba5f10759f5f30ae8 installs=0.19.801 524bdb33cb26c8355454d7550413c89e72c06fae -->
    Loom-Trace-Id: b9c0cb42a5a72ecc21726229c957ef1f
    Loom-Build: unknown 596a53e525683919daae1b43e6babe9bf847a02f clean
    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
2026-10-06 chore: resync installed Loom surfaces
    <!-- loom:provenance v1 build=unknown 40b591a33adb895d4f46977105f9b264d8a2599b clean prompts=none sweep=none story=none trace=e41c725fe0c176312eb412bc69fe5b01 host=robb-studio base=f205fe2ba220a9da5ce157678230fdd93514a513 run=loom-run/v1:timer:robb-studio/fleet-resync:37d704dd-4dfd-4341-adb4-6551637ad147 installs=0.19.802 72ce1f7385747dd773d1644408ec22072b8a5d20 -->
    Loom-Trace-Id: e41c725fe0c176312eb412bc69fe5b01
    Loom-Build: unknown 40b591a33adb895d4f46977105f9b264d8a2599b clean
    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
2026-10-06 chore: resync installed Loom surfaces
    <!-- loom:provenance v1 build=unknown 31b34ebfd7d4539094523eaa7b56a104bebe5fc0 clean prompts=none sweep=none story=none trace=5ad0480c4b21b80f9c852c448319e7a1 host=loom-worker-3 base=f71f44bf4f8d67900355423b61f60ece61a2085d run=loom-run/v1:timer:loom-worker-3/fleet-resync:48e836f11f9547ddb96de5aa0d072a05 installs=0.19.810 933f828e779602e492e4e157812988a4b8128111 -->
    Loom-Trace-Id: 5ad0480c4b21b80f9c852c448319e7a1
    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
2026-10-07 chore: resync installed Loom surfaces
    <!-- loom:provenance v1 build=unknown f71cf25de9e75bae6060da4a599df8fbabe75890 clean prompts=none sweep=none story=none trace=64943e35511da4833bbd385cf288be8a host=loom-worker-2 base=d567a9872810f956a0ab6911c875220da3b21d13 run=loom-run/v1:timer:loom-worker-2/fleet-resync:d69eb1b87d4849ae810a145b1b667d2f installs=0.19.822 1c6969ea8726c800a353c236d9f23456a5706f1a -->
    Loom-Trace-Id: 64943e35511da4833bbd385cf288be8a
    Loom-Build: unknown f71cf25de9e75bae6060da4a599df8fbabe75890 clean
    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
2026-10-07 chore: resync installed Loom surfaces
    <!-- loom:provenance v1 build=unknown 31b34ebfd7d4539094523eaa7b56a104bebe5fc0 clean prompts=none sweep=none story=none trace=cb192cb8f72cf6f2711f73f7ee12bebc host=loom-worker-3 base=9f397993caecb939940ab8dc5b7ac07ba4a3da00 run=loom-run/v1:timer:loom-worker-3/fleet-resync:c1e385c3607e43ad8bed9c7d29811c66 installs=0.19.830 a966f7b89b714704fa1225b96e2dbee50480a4c6 -->
    Loom-Trace-Id: cb192cb8f72cf6f2711f73f7ee12bebc
    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
2026-10-07 design: replace Fbias/Fss_ramp with a VREF-forcing V-to-I servo (#320)
    ldo_ilimit and ldo_softstart each carried the same idealization: a CCCS
    copying the VREF/R current of a resistor branch (Fbias, Fss_ramp) with a
    0 V sense source (Vbsense, Vbsense_ss). Neither has a physical
    realization, so neither cell could be laid out or LVS-matched.
    Both are replaced by the same real-device circuit: a two-stage
    PMOS-input servo amplifier forces VREF onto the top of Rbias/Rss_bias
    through an NMOS conveyor (Mconv), whose drain current IS VREF/R and is
    sunk from the block's existing PMOS diode (Mpd, unchanged in ldo_ilimit;
    new Mpd_ss in ldo_softstart). The amplifier is biased from that same
    diode, with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
    [ldo_ilimit.sch, ldo_softstart.sch]
2026-10-07 chore: resync installed Loom surfaces
    <!-- loom:provenance v1 build=unknown 8abdd34fddc879aff407380278baa713eca6b758 clean prompts=none sweep=none story=none trace=ea945665dad5ccb3880de51c4448e8b9 host=robb-pro base=c13465762a4ce81c52c02401db9a11f30fe43876 run=loom-run/v1:timer:robb-pro/fleet-resync:1466e397-b80c-46ea-a42c-26a7fbd4e00e installs=0.19.831 61814c9c1912925cdff7418842ff3ea17cd56fe4 -->
    Loom-Trace-Id: ea945665dad5ccb3880de51c4448e8b9
    Loom-Build: unknown 8abdd34fddc879aff407380278baa713eca6b758 clean
    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
2026-10-07 sim+spec: klt sim drivers, single-point A/B records and DR-0037 for the VREF-forcing bias servo (#320)
    Adds klt-sim based bench drivers (current-limit, soft-start,
    quiescent-current), single-point tt/27C/3.30V A/B evidence records and
    DR-0037 (proposed). Full PVT matrices are NOT recorded: every batch-fleet
    job returned batch_job_failed (2AMLogic/klayout-tools#2733).
    Loom-Story: 2AMLogic/gf180-ldo#320
    Loom-Trace-Id: a891bad482b77195f5bc777280b8e2a2
    Loom-Build: 0.19.827 6b5119f48f153d6e74b5815da984b8998af166eb clean
    [summary.csv]
2026-10-07 test: make the harness self-tests hold across the #320 netlist change
    test_soft_start_loop_gain: _classify_attribution_effect diffed with
    difflib's default autojunk heuristic. Once the instrumented ldo_core netlist
    passed 200 lines (216 after the bias servo), the PDK's per-device "+ ps=...
    m=1" continuation lines, which are byte-identical across instances, were
    junked. The matcher then reported an untouched continuation line as removed
    and re-added, and acopen-fb-inj / acopen-fb-pre / acopen-hold raised
    "unrecognised transform shape". Diff with autojunk=False. The checks the
    classifier runs are unchanged.
    test_build_characterization_report: the Stability-row rendering test
    pinned the freshn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
    [test_build_characterization_report.py, test_soft_start_loop_gain.py]
2026-10-07 report+spec: regenerate CHARACTERIZATION.md, re-pin signoff, note DR-0037 follow-ups
    sim/CHARACTERIZATION.md is regenerated with
    `python3 sim/build_characterization_report.py` against the servo netlist.
    Every testable row, Stability included, now reads STALE: no PVT re-mint
    could run because the klt sim batch fleet is down
    (2AMLogic/klayout-tools#2733). signoff/'s pinned content hash is re-pinned
    and t1-tier-report.json is regenerated with `bash signoff/check.sh --write`.
    T1 is unchanged at 1/11.
    DR-0037 (still proposed) now:
    - explains why the current limit matches the baseline to 6 digits. A
    single-point op shows V(VX)-V(VREF) = -6.8 uV, so the Rbias current
    matches the ideal CCCS to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
2026-10-07 chore: resync installed Loom surfaces
    <!-- loom:provenance v1 build=unknown 628be5bb140bcff803d159201bd61e1b868901b0 clean prompts=none sweep=none story=none trace=093df1dc315c5e78dcccfca9d699d5f5 host=loom-worker-2 base=a77d98398c391e0e8b2f2beba7e04a8d0caab123 run=loom-run/v1:timer:loom-worker-2/fleet-resync:0b0ea5e184c0429a9c431fcca6c791ad installs=0.19.832 1a0fc15974bf0575a9155fb8276f7529fc813542 -->
    Loom-Trace-Id: 093df1dc315c5e78dcccfca9d699d5f5
    Loom-Build: unknown 628be5bb140bcff803d159201bd61e1b868901b0 clean
    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
2026-10-07 sim(soft-start): explain the startup peak Icap difference (#351)
    The 142 vs 282 mA peak Icap reported for the DR-0037 servo is a time-step
    artifact of tran 1u 9m. Resolved at <=5 ns, both DUTs peak at ~296 mA /
    395 V/ms at 151.82 us, from the hold-release gate slew truncated by the
    current-limit clamp. Single-corner evidence; cross-corner batch submission
    failed (klayout-tools#2733) and is pending.
    Loom-Story: 2AMLogic/gf180-ldo#351
    Loom-Trace-Id: 7501bb7a53cff022aaa7f33f22361ce8
    Loom-Build: 0.19.831 61814c9c1912925cdff7418842ff3ea17cd56fe4 clean
    [convergence.csv, event_baseline.csv, event_new.csv, summary.csv]
2026-10-07 chore: resync installed Loom surfaces
    <!-- loom:provenance v1 build=unknown 069e3b45d86c08f0d60c8fc2b0096de441e99bdc clean prompts=none sweep=none story=none trace=b1ba9d6b2b581e47827d9c099f717b04 host=loom-worker-1 base=f84a598ecb314affa057914596282a6411639ea4 run=loom-run/v1:timer:loom-worker-1/fleet-resync:aada8278bd4843bcaecce69fdf91251e installs=0.19.837 9504f1e9b05e05ce908dd5cffad2aae723621f63 -->
    Loom-Trace-Id: b1ba9d6b2b581e47827d9c099f717b04
    Loom-Build: unknown 069e3b45d86c08f0d60c8fc2b0096de441e99bdc clean
    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
2026-10-07 chore: resync installed Loom surfaces
    <!-- loom:provenance v1 build=unknown 31b34ebfd7d4539094523eaa7b56a104bebe5fc0 clean prompts=none sweep=none story=none trace=ef030e94bce76f728497f5927960865f host=loom-worker-3 base=b535f66ff30c4450875fda66eb404a129bc98619 run=loom-run/v1:timer:loom-worker-3/fleet-resync:28ba4284bfa446c888b501714eda0509 installs=0.19.840 59b533a2a1ed5e186fbf8446b5acbe42d7231854 -->
    Loom-Trace-Id: ef030e94bce76f728497f5927960865f
    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
2026-10-07 chore: resync installed Loom surfaces
    <!-- loom:provenance v1 build=unknown bc59c70c3412a87b31a0dbe65cd6abf968744328 clean prompts=none sweep=none story=none trace=766033e4e881801f24971d664c490ea3 host=robb-studio base=29ce8dd0bc4c891af278fb3accaf8a5f29fd0818 run=loom-run/v1:timer:robb-studio/fleet-resync:6b3b079a-890e-4a79-9c3a-0b4bb33ff7c4 installs=0.19.840 59b533a2a1ed5e186fbf8446b5acbe42d7231854 -->
    Loom-Trace-Id: 766033e4e881801f24971d664c490ea3
    Loom-Build: unknown bc59c70c3412a87b31a0dbe65cd6abf968744328 clean
    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
2026-10-07 chore: resync installed Loom surfaces
    <!-- loom:provenance v1 build=unknown a068938e7a6c13759bcb3943e408273a3d352257 clean prompts=none sweep=none story=none trace=76bec863c8f6aff2d49b3aa2be128619 host=robb-pro base=8b3a971dc5dc18b9dbcc513c8845256507f206af run=loom-run/v1:timer:robb-pro/fleet-resync:d9927fc6-ee80-4b6a-ba2b-f13576bd5f9b installs=0.19.846 837b14d7440b89ae8a2cec6d045483ac33659af5 -->
    Loom-Trace-Id: 76bec863c8f6aff2d49b3aa2be128619
    Loom-Build: unknown a068938e7a6c13759bcb3943e408273a3d352257 clean
    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
2026-10-07 chore: resync installed Loom surfaces
    <!-- loom:provenance v1 build=unknown 628be5bb140bcff803d159201bd61e1b868901b0 clean prompts=none sweep=none story=none trace=5a6f676b4652a1a750bbce1386c68d06 host=loom-worker-2 base=016efe09e6324d0c0ea4e2aa159a6d272d8e9dd7 run=loom-run/v1:timer:loom-worker-2/fleet-resync:bd416e653be04ef4b13353430625e379 installs=0.19.850 3bb4bfc90603b6ad65cabca9b3eb42a59f1a9d3a -->
    Loom-Trace-Id: 5a6f676b4652a1a750bbce1386c68d06
    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
2026-10-07 chore: resync installed Loom surfaces
    <!-- loom:provenance v1 build=unknown 40215645df8a13508180b248b44244dc488bb078 clean prompts=none sweep=none story=none trace=29fde30615e6e47f39b41aa314c2c883 host=loom-worker-1 base=e8d4589075c560202dca5f840769c6d13bf08019 run=loom-run/v1:timer:loom-worker-1/fleet-resync:d1fbedfcc7824ae59233c0ea94dc4650 installs=0.19.853 2889d5ed585b4da0935543cb916381cc03b19746 -->
    Loom-Trace-Id: 29fde30615e6e47f39b41aa314c2c883
    Loom-Build: unknown 40215645df8a13508180b248b44244dc488bb078 clean
    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
2026-10-07 chore: resync installed Loom surfaces
    <!-- loom:provenance v1 build=unknown 31b34ebfd7d4539094523eaa7b56a104bebe5fc0 clean prompts=none sweep=none story=none trace=cdf49c615da3f5ce46e9fcda1a24f787 host=loom-worker-3 base=65a33838971bb957d25e761061b1f5f90f778b2e run=loom-run/v1:timer:loom-worker-3/fleet-resync:cab31e05b8a24df09bc88f53ee3fb501 installs=0.19.857 7a0b529e6f57a79713f6924bf58d8392ff404259 -->
    Loom-Trace-Id: cdf49c615da3f5ce46e9fcda1a24f787
    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
2026-10-07 chore: resync installed Loom surfaces
    <!-- loom:provenance v1 build=unknown 4b44e7c5db0de1d2b5927de7de229120d546aad3 clean prompts=none sweep=none story=none trace=dfa656ee3483a044378501f49d36f812 host=robb-studio base=2dd1d5e0f9473c921a923aafe4b4c84cc9b682cb run=loom-run/v1:timer:robb-studio/fleet-resync:d80d6bc0-eb68-4a07-8226-2d947d328b3a installs=0.19.859 0aefebd79aba8ab33470f1af4b96847fc794bd0d -->
    Loom-Trace-Id: dfa656ee3483a044378501f49d36f812
    Loom-Build: unknown 4b44e7c5db0de1d2b5927de7de229120d546aad3 clean
    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
2026-10-07 chore: resync installed Loom surfaces
    <!-- loom:provenance v1 build=unknown b591c8cf436f0d4aa5870a9bc7cd5f7194e0e778 dirty prompts=none sweep=none story=none trace=6eca4b0c47205457aae7a3d721c17f17 host=robb-pro base=079dfd253a0b706aa3b5580919ebafa6eee4e1f9 run=loom-run/v1:timer:robb-pro/fleet-resync:64af20b3-58cb-47f2-b770-117197cb41e9 installs=0.19.864 128a7eba2bb5f7bcf8891ba284b14cb7ebf8dd3d -->
    Loom-Trace-Id: 6eca4b0c47205457aae7a3d721c17f17
    Loom-Build: unknown b591c8cf436f0d4aa5870a9bc7cd5f7194e0e778 dirty
    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
2026-10-07 chore: resync installed Loom surfaces
    <!-- loom:provenance v1 build=unknown b551219fd5b8347113c0cbc79ea416e81c39fa9d clean prompts=none sweep=none story=none trace=5ac7c8c62dad54841e21dd94f0920de3 host=loom-worker-2 base=fd3d542e00b8700ac614ab3648f953ee1b15ce51 run=loom-run/v1:timer:loom-worker-2/fleet-resync:d10fb10789e94930ab1af368c15a8f8b installs=0.19.864 128a7eba2bb5f7bcf8891ba284b14cb7ebf8dd3d -->
    Loom-Trace-Id: 5ac7c8c62dad54841e21dd94f0920de3
    Loom-Build: unknown b551219fd5b8347113c0cbc79ea416e81c39fa9d clean
    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
2026-10-07 chore: resync installed Loom surfaces
    <!-- loom:provenance v1 build=unknown 90fbd167e4e376894396e651676cf58fc9aa223a clean prompts=none sweep=none story=none trace=196876656e912171b28029ceca9f772d host=loom-worker-1 base=bdd81729bd81b57398ff96f82083747b2296851f run=loom-run/v1:timer:loom-worker-1/fleet-resync:7b46720ff3a84a8184f2f2b3bc039260 installs=0.19.868 ee904e1c151bc9cf15b0eb55dfe9d57ad6136cff -->
    Loom-Trace-Id: 196876656e912171b28029ceca9f772d
    Loom-Build: unknown 90fbd167e4e376894396e651676cf58fc9aa223a clean
    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
2026-10-08 chore: resync installed Loom surfaces
    <!-- loom:provenance v1 build=unknown 5a3df331a0612dee585ef905015af01d08e3467f clean prompts=none sweep=none story=none trace=5690fa95febe608e500a46dde8a6ee92 host=loom-worker-2 base=3635836a1ebc3aa56b7eddc355cca2fa2c40b00d run=loom-run/v1:timer:loom-worker-2/fleet-resync:5c9c35d59b704bff9d8bf096ee7ba7be installs=0.19.876 b16d54e63fbbec4d7f15f13c1f43a5e5b38145ce -->
    Loom-Trace-Id: 5690fa95febe608e500a46dde8a6ee92
    Loom-Build: unknown 5a3df331a0612dee585ef905015af01d08e3467f clean
    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
2026-10-08 chore: resync installed Loom surfaces
    <!-- loom:provenance v1 build=unknown 134eb3ff06c1a86f49a911c6c17464f55e719736 clean prompts=none sweep=none story=none trace=c7df110d490314040dcd1347b2481843 host=loom-worker-1 base=80680c3080af23e059874368b25b1b4f72edc570 run=loom-run/v1:timer:loom-worker-1/fleet-resync:53d0cec2cd61484eb9a0f8fb1f24ac5e installs=0.19.879 c15619905bdd8a24506c3853f45490d26e8f1cad -->
    Loom-Trace-Id: c7df110d490314040dcd1347b2481843
    Loom-Build: unknown 134eb3ff06c1a86f49a911c6c17464f55e719736 clean
    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
2026-10-08 chore: resync installed Loom surfaces
    <!-- loom:provenance v1 build=unknown 8f86de23319d8f6cf049557dcc9cf2e321211d9d clean prompts=none sweep=none story=none trace=17de45f778fbfd714af8afad02c96375 host=loom-worker-3 base=747102812ccc9f787bd8450b49f1fff8e0e8c6f3 run=loom-run/v1:timer:loom-worker-3/fleet-resync:9e3e5d4a08824de3b7bc02940be2a0da installs=0.19.882 c9f85af3d967986cdd7a3f27e088a16f88712b05 -->
    Loom-Trace-Id: 17de45f778fbfd714af8afad02c96375
    Loom-Build: unknown 8f86de23319d8f6cf049557dcc9cf2e321211d9d clean
    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
2026-10-08 chore: resync installed Loom surfaces
    <!-- loom:provenance v1 build=unknown 4a5fb2b6276e17ff26ee1382acfe2ea7360ebea5 clean prompts=none sweep=none story=none trace=67857e1b7189785825a2dfc70921cf85 host=loom-worker-2 base=ed7be2c55c5bccbef0d99884c4624b238b9a24a4 run=loom-run/v1:timer:loom-worker-2/fleet-resync:dd6a5f3dceff4d8d8602a07a1dc89c95 installs=0.19.892 ce93e8a919d79a6f027bab268846a52084f9d94e -->
    Loom-Trace-Id: 67857e1b7189785825a2dfc70921cf85
    Loom-Build: unknown 4a5fb2b6276e17ff26ee1382acfe2ea7360ebea5 clean
    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
2026-10-08 sim(soft-start): bias-acquisition characterization driver for the DR-0037 servos (#352)
    Adds sim/soft-start/testbench/bias_acq.py: seven klt sim scenarios (op,
    op_nodeset, encycle, powerup, forced, vreflate, negctl) that measure both
    DR-0037 self-biased servos (ldo_ilimit and ldo_softstart) from an
    instrumented copy of the committed DUT, with declared windows and
    tolerances, plus unit tests for the classification logic.
    Harness: KLT_CMD lets a run use a pinned klt client from a throwaway uvx
    environment, and collect() redacts the batch job bucket name from reports.
    Loom-Story: 2AMLogic/gf180-ldo#352
    Loom-Trace-Id: 5af9680ba878d892b05a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
    [bias_acq.py, test_bias_acq.py]
2026-10-08 sim(soft-start): bias-acq README, op/op_nodeset batch results (#352, partial)
    Loom-Trace-Id: 5af9680ba878d892b05ae07585ef1895
    Loom-Build: 0.19.868 ee904e1c151bc9cf15b0eb55dfe9d57ad6136cff clean
    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
2026-10-08 sim(soft-start): drop incomplete partial run (no manifest); full run follows (#352)
    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
2026-10-08 sim(soft-start): bias-acquisition PVT characterization record for both DR-0037 servos (#352)
    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
    [acquisition.csv, op.csv, ss_-40c_2.97v.wave.csv, ss_-40c_3.30v.wave.csv, ss_27c_2.97v.wave.csv, ss_27c_3.30v.wave.csv, tt_-40c_2.97v.wave.csv, tt_-40c_3.30v.wave.csv]
2026-10-08 record: fix diagnostic count wording (#352)
    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
2026-10-08 chore: resync installed Loom surfaces
    <!-- loom:provenance v1 build=unknown b591c8cf436f0d4aa5870a9bc7cd5f7194e0e778 dirty prompts=none sweep=none story=none trace=28e7ca5fdb768489aa38bf002407d5a5 host=robb-pro base=befe8c39efb38a66526e195c15d43282031cb148 run=loom-run/v1:timer:robb-pro/fleet-resync:eb5f838e-a774-4e20-8102-c37ee3ff31ca installs=0.19.895 9b30d293bcba1e79d49cabfc1c5bb5b6f4c0dc77 -->
    Loom-Trace-Id: 28e7ca5fdb768489aa38bf002407d5a5
    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
2026-10-08 docs: record servo characterization and closed issues
2026-10-08 Enforce pinned xschem 3.4.7 in shared netlist export (#361)
    Loom-Story: 2AMLogic/gf180-ldo#361
    Loom-Trace-Id: 4abf9fd5b0ff1a83d55969d3a8044b42
    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
2026-10-08 feat: generate status index for spec/decision-records (#362)
    Adds build_index.py, a generated README.md index, a CI staleness diff beside the DR-number uniqueness step, and stdlib parser tests run via sim/selftest.sh. DR-0007 (proposed, HELD) is classified by override table; no record is edited.
    Loom-Story: 2AMLogic/gf180-ldo#362
    Loom-Trace-Id: b84d810411307ab6b5a8d3b2af207c3c
    Loom-Build: 0.19.898 3d55b9a1669c132d130d98f10a292c1325322c30 clean
2026-10-08 docs(signoff): README reflects the two drawn layout cells (Part of #79)
    Loom-Story: 2AMLogic/gf180-ldo#79
    Loom-Trace-Id: a487836bc2188974982bd09dce71b6b8
    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
2026-10-08 ci: enforce append-only sim/ evidence at PR level (#371)
    Loom-Story: 2AMLogic/gf180-ldo#371
    Loom-Trace-Id: cc54e4021fcf9a5368218065bffa2b86
    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
2026-10-08 sim(loop-stability): cap default local jobs at 2, require explicit --backend local for grids (Part of #366)
    Loom-Story: 2AMLogic/gf180-ldo#366
    Loom-Trace-Id: 169caea9397018114e0c22e4000797cd
    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
2026-10-08 fix(sim): stop embedding absolute host paths in records (#365)
    Render the PDK location relative to its root, normalise diagnostic log
    paths (repo-relative / <abs>/basename), add unit tests, and add a CI
    check that fails when a record added or modified in a PR contains
    /home/<user> or /Users/<user>. Existing records are untouched.
    Loom-Story: 2AMLogic/gf180-ldo#365
    Loom-Trace-Id: af132a207ceb07c843912dd1865a95fa
    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
    [test_harness.py]
2026-10-08 refactor(layout): route divider and testcell gen_gds through gen_gds_common (#370)
    Remove the private _fail/_rd/_load_pdk_pcells/_text copies. _text becomes
    _label (layer pair instead of layer index). GF_PDK_OPTION is now passed
    explicitly ("D") and assigned unconditionally, matching passives and
    pass_array. Regenerated divider/testcell GDS is XOR-identical.
    Loom-Story: 2AMLogic/gf180-ldo#370
    Loom-Trace-Id: 0a209e4c551fb7d34b8c9f4d2521e9fd
    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
2026-10-08 fix(layout): dedent divider vout_head, restore _fail exit code 1 (#370)
    - layout/divider/gen_gds.py: `vout_head = heads[...]` was indented into
    the preceding net-ownership loop; dedent to function scope.
    - layout/gen_gds_common.py: shared _fail() raises SystemExit(1) after
    writing to stderr, matching the pre-refactor divider/testcell helpers
    (the message string as exit code duplicated stderr output and made the
    in-process exit code a str).
    - layout/tests/test_testcell_gen_gds.py: restore assertEqual(code, 1).
    Loom-Build: 0.19.898 3d55b9a1669c132d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
2026-10-08 fix(sim): protect frozen netlist snapshots with the append-only guard (#378)
    Loom-Story: 2AMLogic/gf180-ldo#378
    Loom-Trace-Id: a48ecae162707adf227a8004ba5fb4cf
    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
    [test_check_append_only.py]
2026-10-08 style: apply ruff F541/F401 autofixes (#377)
    Loom-Story: 2AMLogic/gf180-ldo#377
    Loom-Trace-Id: 3ab94773dc167d0880315e01c91a920f
    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
2026-10-08 ci: run ruff F+E9 lint gate in harness-selftest and npm run lint (#377)
    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
2026-10-08 ci: install uv in harness-selftest before the ruff lint step (#377)
    The pinned `uvx ruff==0.16.10 check .` step failed with
    `uvx: command not found` because uv was not installed in that job.
    Install it via pip, matching the signoff-tier-report job.
    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
2026-10-08 chore: resync installed Loom surfaces
    <!-- loom:provenance v1 build=unknown 04a1189116c7320def7d9ce357d2d9268405ae92 clean prompts=none sweep=none story=none trace=8e55b27fc60ffb045554bd413ad8f3c8 host=robb-pro base=b5dd589efd096811398e70f797c97e975340afdb run=loom-run/v1:timer:robb-pro/fleet-resync:83b69005-7c5b-44b3-96f8-33f07bf82f4b installs=0.19.917 d3c1ea3a4c81e01ce5487dc3e4bbdd86534e677e -->
    Loom-Trace-Id: 8e55b27fc60ffb045554bd413ad8f3c8
    Loom-Build: unknown 04a1189116c7320def7d9ce357d2d9268405ae92 clean
    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
2026-10-08 docs: README repository layout lists signoff, ratification, docs, reuse.lock.json (#383)
    Loom-Story: 2AMLogic/gf180-ldo#383
    Loom-Trace-Id: a32948c624fdbd22dd6889bc08a77734
    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
2026-10-08 sim: golden-record unit tests for the rollup scripts (#381)
    Add sim/tests/test_summarizers.py (stdlib unittest, no PDK/ngspice). Each
    rollup script is re-run against one committed record's raw logs, read in
    place, and its headline numbers are compared with values parsed from that
    record's .md (half a unit in the last printed digit; mc-output-accuracy
    adds a stated 1e-5 relative allowance for its 6-figure MCSAMPLE lines).
    Each script also gets a malformed-input case asserting a raise.
    Behaviour-preserving refactors so the logic is importable:
    - mc-output-accuracy/summarize.py: pure rollup() + main()
    - soft-start, current-limit, enable-shutdown summarize.py: rollup(),
    write_csv(), module-le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
2026-10-08 spec: DR-0038 keeps error_amp in tree vs gf180-opamp; reuse.lock.json evaluate -> kept (#384)
    Loom-Story: 2AMLogic/gf180-ldo#384
    Loom-Trace-Id: 9f80b78319e3c5897143bbd3c4985991
    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
2026-10-08 spec: index design citations of unratified decision records; fail on dangling ones (#387)
    Loom-Story: 2AMLogic/gf180-ldo#387
    Loom-Trace-Id: e0f16b6385bea966df0bcc33623088de
    Loom-Build: 0.19.929 e0381fd31734743649019281f22b12223f853f41 clean
    [ldo_softstart.sch]
2026-10-08 chore: resync installed Loom surfaces
    <!-- loom:provenance v1 build=unknown d2a55ce217b3ad1793611a2c54946676bb55b512 clean prompts=none sweep=none story=none trace=459637e4e8503593bdf58360865a7524 host=robb-pro base=6f99ac835fb36a073b1fd4143e85336883f1cd95 run=loom-run/v1:timer:robb-pro/fleet-resync:95b3cf92-9cd9-4c36-8bbd-bdcace7c3874 installs=0.19.935 d347079cd0bad2db2c11ee4f0b760f04b2601d21 -->
    Loom-Trace-Id: 459637e4e8503593bdf58360865a7524
    Loom-Build: unknown d2a55ce217b3ad1793611a2c54946676bb55b512 clean
    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
2026-10-08 sim: bind characterization freshness to the designated DUT (#393)
    freshness() accepted a match against either design netlist anywhere in a
    snapshot, so a stale ldo_core snapshot that also included the current
    standalone error_amp read as fresh, and freshness-first selection used the
    same predicate. Freshness now takes the source's expected DUT (explicit
    DUT_BY_SLUG mapping), compares only that netlist's provenance section (or
    the whole file for legacy headerless snapshots), and reports unknown with a
    reason when identity is missing or ambiguous. Selection and rendering share
    the same expected DUT. Regenerated rollup is byte-identical (no committed
    row changes).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
    [test_build_characterization_report.py]
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2026-10-09 chore: resync installed Loom surfaces
    <!-- loom:provenance v1 build=unknown 05dba463c5b293d38f0ca071725983862498b3f3 clean prompts=none sweep=none story=none trace=14298316053024bcf5120bff695771ab host=robb-pro base=3eb091d141b82d296a2e08846ff72a28bed73aaa run=loom-run/v1:timer:robb-pro/fleet-resync:2f384483-6d77-4ba2-9888-aa1e4b5be36c installs=0.19.953 b93d7a955d63411cb4c94b986fd5138d27dedb0f -->
    Loom-Trace-Id: 14298316053024bcf5120bff695771ab
    Loom-Build: unknown 05dba463c5b293d38f0ca071725983862498b3f3 clean
    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
2026-10-09 ci: fail when README T1 tier/count prose disagrees with the verdict of record
    Closes #398
    Loom-Story: 2AMLogic/gf180-ldo#398
    Loom-Trace-Id: ed5fcd6818def92b503e619a7a7945c5
    Loom-Build: 0.19.950 72047016af9d66c08f900bb94c642a66dfd75fc5 clean
    [test_readme_claims.py]
2026-10-09 ci: harden ci.yml (permissions, concurrency, timeouts, pin uv/volare)
    Closes #402
    Loom-Story: 2AMLogic/gf180-ldo#402
    Loom-Trace-Id: 6c7f3fbc47f9532b7b7d8a251c58ed4e
    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
2026-10-09 chore: resync installed Loom surfaces
    <!-- loom:provenance v1 build=unknown 7f06b288b150f2fe0a4b24c331a9b3ec093d709d clean prompts=none sweep=none story=none trace=a90c217ff3a3bd9e3a30282b8cadc24d host=robb-pro base=be93deee29184dada0803c4895836ea7785ca791 run=loom-run/v1:timer:robb-pro/fleet-resync:6e5ec9f3-d6ef-4953-80f7-c93035e2d359 installs=0.19.966 9bed656320e53ba6c64305daa60613431a7ed02d -->
    Loom-Trace-Id: a90c217ff3a3bd9e3a30282b8cadc24d
    Loom-Build: unknown 7f06b288b150f2fe0a4b24c331a9b3ec093d709d clean
    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
2026-10-09 ci: pin the ratified README spec table behind a lock and decision-record amendments
    Adds spec/check_spec_table.py, spec/spec-table-lock.json (bootstrap, no spec
    values changed), tests, CI wiring in harness-selftest, and docs. Closes #397.
    Loom-Story: 2AMLogic/gf180-ldo#397
    Loom-Trace-Id: b9ff40ba28545003e9d55c985158caa1
    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
2026-10-09 test: pin each spec-table lock rule to its own error message
    Address Judge review on #404:
    - Add tests that reach base_check's "duplicate, unrelated or contradicts
    the table change" rule: a fabricated amendment with an unchanged table
    (passes parse_lock/_check_chains and cites an eligible new DR), and an
    amendment whose before-state contradicts the real transition. Disabling
    that raise now fails both tests.
    - Replace generic msg="error" assertions with the specific message for
    each rule; bad() now requires msg. The bootstrap non-empty-ledger case
    previously failed at the current-tree check; it now regenerates the lock
    so the bootstrap rule itself is exercised.
    - Real 'held' co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
    [test_check_spec_table.py]
2026-10-09 chore: resync installed Loom surfaces
    <!-- loom:provenance v1 build=unknown 30c7a7ee2f74a6a2b5bb0f19fd9f049ec8ae8b5c clean prompts=none sweep=none story=none trace=7bc5ba399ff199d049d83d711920a157 host=robb-pro base=a89fb5b4fd4de887a95b3612b7a09d12ac350188 run=loom-run/v1:timer:robb-pro/fleet-resync:8e237160-c4d0-4ce3-85ac-c96aff5cf221 installs=0.19.982 2bc4cba624b9053535663441e6f0daf08a7acf2e -->
    Loom-Trace-Id: 7bc5ba399ff199d049d83d711920a157
    Loom-Build: unknown 30c7a7ee2f74a6a2b5bb0f19fd9f049ec8ae8b5c clean
    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
2026-10-10 chore: resync installed Loom surfaces
    <!-- loom:provenance v1 build=unknown 03c1cb521a10d5101bd8aa2c52a47cebfb0e795b clean prompts=none sweep=none story=none trace=09ccab293fce5c1a7b4aa907c7197bec host=robb-studio base=fae8f7a8a85eaade95b5d7d7f70df1b3f7f7c067 run=loom-run/v1:timer:robb-studio/fleet-resync:ed2be6c5-20fe-4228-a206-940d35a4858f installs=0.19.996 0d2be7e9ae05753e2c9232a83b7399d45de5396e -->
    Loom-Trace-Id: 09ccab293fce5c1a7b4aa907c7197bec
    Loom-Build: unknown 03c1cb521a10d5101bd8aa2c52a47cebfb0e795b clean
    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
2026-10-10 chore: resync installed Loom surfaces
    <!-- loom:provenance v1 build=unknown a7d2b01d8eb7d09e597a4638e5cb3cdd8bab9156 clean prompts=none sweep=none story=none trace=35c1337ee84607e87ba2038523d63198 host=robb-pro base=8f781c93188f4032437bac1252dc0fd41ab73095 run=loom-run/v1:timer:robb-pro/fleet-resync:6bf32a81-6c4a-48c5-a51e-1ad65c6bedfd installs=0.19.999 20513e3064fa3a7c4b3f1c641d97a00446e9ba78 -->
    Loom-Trace-Id: 35c1337ee84607e87ba2038523d63198
    Loom-Build: unknown a7d2b01d8eb7d09e597a4638e5cb3cdd8bab9156 clean
    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
2026-10-10 sim: reject failed ngspice runs in generic PVT path (#406)
    Extract validate_process_output() (exit status, fatal log, undefined
    vector) shared by run_point() and run_ngspice_deck().
    Loom-Story: 2AMLogic/gf180-ldo#406
    Loom-Trace-Id: 7cd62e55104943983255bdd179b979fc
    Loom-Build: 0.19.996 0d2be7e9ae05753e2c9232a83b7399d45de5396e clean
    [test_harness.py]
2026-10-10 chore: resync installed Loom surfaces
    <!-- loom:provenance v1 build=unknown c156f673e072832aaacb4cd1ec65b742e7f45867 clean prompts=none sweep=none story=none trace=9de99c124c651049199abe9a75070dc7 host=robb-pro base=534de90835365aefcef6a2cd48ffd6d9a10711bc run=loom-run/v1:timer:robb-pro/fleet-resync:f790885c-7154-4b3d-acd9-71fd537cd20b installs=0.19.1010 d1d5fcecb79550fe39658555a4419f98cec060fb -->
    Loom-Trace-Id: 9de99c124c651049199abe9a75070dc7
    Loom-Build: unknown c156f673e072832aaacb4cd1ec65b742e7f45867 clean
    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
2026-10-12 fix(sim): require complete unique stability-matrix coverage for the row PASS (#410)
    envelope_verdict() now derives the 630 required DR-0018 coordinates and
    compares them with normalized, de-duplicated CSV coordinates. Partial
    coverage without failures is UNKNOWN with measured/required counts; a
    genuine in-envelope failure stays FAIL with coverage disclosed; duplicate
    and malformed rows never fill slots. Complete matrices keep the existing
    margin/resurgence verdict.
    Loom-Story: 2AMLogic/gf180-ldo#410
    Loom-Trace-Id: 2bc792adf4c443de3db824f030f6bb3d
    Loom-Build: 0.19.1071 dcab8265613676d08b763cddc911b93c7ab7d9d4 clean
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2026-10-12 fix(ci): cover top-level layout/records in host-path evidence guard (#413)
    Move the selector into sim/check_record_host_paths.py and add a git
    pathspec regression test.
    Loom-Story: 2AMLogic/gf180-ldo#413
    Loom-Trace-Id: b4868997f6cc5538af92b04be1d775c6
    Loom-Build: 0.19.1081 6966a93d1cd1b005f2a6b22bf9691ade8793ed73 clean
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2026-10-12 fix(ci): size the nightly startup smoke budget from measurement; keep partial output on timeout (#409)
    Loom-Story: 2AMLogic/gf180-ldo#409
    Loom-Trace-Id: 3ac2e69dbe7164f01b76a436728d0580
    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
2026-10-12 fix(harness): validate manifest checks at load (#418)
    Loom-Story: 2AMLogic/gf180-ldo#418
    Loom-Trace-Id: 9670143749d28f1ebd58802fa036e0d0
    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
2026-10-12 fix(sim): fail closed on non-finite measurements and derived statistics (#420)
    Loom-Story: 2AMLogic/gf180-ldo#420
    Loom-Trace-Id: 7c322e93dea8e0dec697e98c314da1df
    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
2026-10-12 fix(sim): make summarize overflow/underflow-proof on extreme finite samples (#420)
    Addresses PR #421 review:
    - _spread_pct: a rescaled denominator that underflows to zero (or is
    non-finite) now yields None (unevaluable, spread checks fail closed)
    instead of raising ZeroDivisionError.
    - _safe_mean: the overflow fallback normalises each term by the largest
    sample magnitude before fsum (terms in [-1, 1], cannot overflow), then
    clamps to [min, max]; fsum(v / n) could raise "intermediate overflow".
    - Regression tests for [-1e308, 1e308, 1e-300] and 3x float max.
    Loom-Trace-Id: 7c322e93dea8e0dec697e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
2026-10-12 fix(sim): enforce append-only record writes with exclusive creation (#422)
    Loom-Story: 2AMLogic/gf180-ldo#422
    Loom-Trace-Id: 372fcc110076fd6d1ca7d6dc58e5af32
    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
2026-10-15 test: disable git auto-maintenance in temp repos to avoid cleanup race
    Loom-Story: 2AMLogic/gf180-ldo#426
    Loom-Trace-Id: dfe57900f8ab12afdfebc26c8086c15b
    Loom-Build: 0.19.1166 8a9aad12e32504cea9a7c7d2ed774749c487f875 clean
2026-10-15 feat(sim): pin PDK to open_pdks f6eeac7 via ciel and refuse mismatched trees
    Add PINNED_OPEN_PDKS_REVISION / PINNED_CIEL_VERSION to the PDK resolver,
    check every resolved tree's SOURCES revision against it (PdkPinMismatch),
    prefer ~/.ciel over ~/.volare, move CI and docs to ciel 2.6.1.
    Part of #428
    Closes #429
    Loom-Story: 2AMLogic/gf180-ldo#429
    Loom-Trace-Id: 9667df4150c106453f97fa030e91bdf2
    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
2026-10-15 sim(soft-start): record the incomplete DR-0037 PVT run and fix the summary.csv crash after failed jobs (#320)
    The new-DUT main request and both extra requests exceeded the fleet's 3600 s
    whole-job ceiling and returned batch_job_timeout; no verdict is claimed.
    klt_run.py now builds the CSV header from the union of row keys.
    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
2026-10-17 sim: cap local jobs at 2 and require explicit backend for bash/soft-start-loop-gain grids
    Part of #366. Applies the loop-stability guard from #375 to the remaining
    ratified-row drivers: current-limit, enable-shutdown and soft-start run.sh
    default to 2 jobs and refuse a multi-point grid unless BACKEND=local;
    soft-start-loop-gain sweep.py gains --backend and a 2-job default. Points
    at klt_run.py where one exists, and updates the loop-stability batch
    refusal to the current klayout-tools gap (#3737).
2026-10-17 sim: add klt sim batch front end for the enable-shutdown PVT grid
    Part of #366
    The deck chains four analyses in one .control block; klt_run.py submits one
    request per analysis state (enabled op, disabled op, leakage op, tran) over the
    same 63-point grid and merges the returned values into run.sh-style m_* logs so
    summarize.py rolls them up unchanged. run.sh's header and guard message now
    point at it.
2026-10-17 sim(soft-start-loop-gain): add klt sim batch front end for the margin and hand-over decks
    sweep.py --backend batch now submits one klt sim request per
    variant/phase/C_eff/ESR (analysis.passes + tian series_injection, ramp state
    and supply as zipped corners.params rows) plus one op request per variant for
    the DC hand-over transfer, replacing BATCH_UNSUPPORTED. Rows enter the record
    through the same ROW/HOV parsers and landing rule as the local path.
    --backend klt-local runs the same requests locally for a single-PVT-point
    batch-vs-local check. The loop-stability cross-check re-run now follows the
    chosen backend instead of fanning out locally.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
2026-10-21 signoff: re-pin characterization evidence to regenerated sim/CHARACTERIZATION.md
    signoff/check.sh failed on the stale sha256 pin. Re-pinned the envelope and
    manifest and regenerated the T1 record; the verdict of record is unchanged
    (T1 1/11 items met).
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2026-10-21 spec: DR-0039 attributes the ff/125C line-regulation failure to the soft-start injection residual
    The 8.28 mV/V reading at ff_125c_3.30v is a 17.7 nA Vin-dependent current
    sourced into FB by the soft-start FB-injection element, not loop gain. The
    bound stays at 5 mV/V; the fix is DR-0035's VIN-referenced ramp ceiling
    re-landed over DR-0037's servo (open PR #344 conflicts with main).
    Part of #473
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2026-10-21 fix(sim): run chained-bench supplies as separate klt requests, since the fleet worker rejects corners.params
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2026-10-21 fix(sim): sweep dropout Vin rising and step the load current so the DC benches stay on the physical branch
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2026-10-21 sim: re-mint psrr-vs-freq-50ma on the batch fleet with the supply-gated sink; ss_-40c_2.97v is physical
    Record 20261021-034534-0165a0b: 42/45, the 44 other corners agree with the
    previous record to within rounding (one 0.9 mdB shift), the three remaining
    FAILs are the real PSRR corners (DR-0031). Regenerates CHARACTERIZATION.md and
    re-pins signoff.
    Closes #478
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2026-10-21 sim: re-qualify load-transient and mc-output-accuracy at open_pdks f6eeac7 via klt sim
    Both benches re-run on the batch fleet with the pinned models staged. Each
    fails bounds on the current DUT; the earlier DUT reproduces the earlier
    records through the same driver, so the movement is the DUT, not the pin
    (#483, #484). mc-output-accuracy keeps its 25 copies per solve and takes its
    40 redraws as monte_carlo.n; its committed report is compacted to the
    per-sample logs summarize.py reads.
    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
2026-10-21 sim: attribute the load-transient excursions to the DR-0034 pass width at 0.33 uF / 100 mOhm (#483)
    Mechanism record for the 8 failing points of 20261021-pdk-f6eeac7-tran. A
    git-ref bisect and single-variable edits put the step at the pass-device
    width change (2000 -> 2800 um); the DR-0037 servo moves the undershoot by
    0.1 mV. Tian loop gain at 50 mA is -7.7 .. +0.8 deg PM at the slow/cold
    corners, and the late-plateau probes show a sustained VOUT oscillation, so
    the "excursion" is the first trough of a marginally unstable loop. The
    bench's 0.33 uF / 100 mOhm output network is outside the Stability envelope
    (DR-0018: 1 uF, ESR >= 200 mOhm); at ESR >= 200 mOhm every probed point
    passes with >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
2026-10-21 refactor(sim): share ROW coercion and curve capture between loop sweeps
    Move the shared Row field coercion (base_row_kwargs, nan_or) and the
    print-tdb-tph curve capture (print_curve_log) into the loop-stability
    sweep and reuse them from soft-start-loop-gain. Fixes the falsy-zero
    drift where a 0.0 VOUT or DC gain became NaN in loop-stability.
2026-10-21 refactor(sim): share klt grid retry driver and backend guard between loop sweeps
    Move the klt-sim grid state machine (parse per unit, non-retryable klt
    problems, one seeded re-run on a DC-branch miss, optional voiding) and the
    --backend/klt-local single-PVT guard into harness/klt_grid.py. Both sweep
    scripts keep their own print formats through callbacks.
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2026-10-23 feat: store new sim evidence in the artifact store, commit only manifests
    Port of the sg13g2-comparator writer and manifest checker: run_corners.py stages
    the snapshot and corner logs, puts them via klt artifact put, and commits only
    manifests/artifacts/*.manifest.json plus the Markdown record. Fail closed with
    no byte fallback; offline CI check; manifests protected as append-only; DR-0041.
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2026-10-27 chore(signoff): pin klayout-tools to PyPI 0.8.0 and regenerate T1 record
    Replace the git-SHA pin with klayout-tools==0.8.0 in check.sh, CI and the
    signoff README; align install lines in docs. Regenerate the T1 report and
    item 1/9/10 envelopes (only build metadata and the ci.yml/check.sh content
    hashes changed; no verdict moved).
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2026-11-05 refactor: run xschem netlist export through klt netlist with a bounded timeout
    run_xschem_netlist() hand-rolled the xschem subprocess with no timeout, so a
    hung xschem blocked design/netlist.py and the LVS export indefinitely, and it
    duplicated ERC detection by regex over stdout. It now delegates to
    'klt netlist --erc --timeout-s', which forces the headless flags, kills the
    process group on expiry and fails on ERC findings and unresolved symbols.
    The 3.4.7 version pin and normalize() are kept, and klt's provenance header is
    stripped so output is identical to the previous helper for all 4 design cells
    and all 4 LVS cells.
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2026-11-06 feat: cite limit-checked sim envelopes as T1 item 5 evidence
    Cite the #538 klt-report.json envelopes for Current limit, Dropout @ 50 mA,
    Load reg (0–50 mA) and Enable / shutdown in the signoff manifest, fix the
    Load reg row id to the ratified en dash, reword the Thermal gap, and
    regenerate the verdict of record.
    Closes #552
2026-11-06 feat: report files and bytes added per sim slug on PRs (non-blocking)
    Adds sim/report_evidence_growth.py, which diffs <base>...HEAD and writes a
    per-slug table of files and bytes added to the job summary. Reporting only:
    always exits 0, no ceiling or override. Wired into harness-selftest as a
    PR-only continue-on-error step.
    Closes #388
2026-11-06 fix(signoff): re-attest item 9 after klt_run.py change
    Regenerated signoff/evidence/item9.generic.json with
    klt signoff --attest 9 (klayout-tools 0.8.0); 90/90 checks pass. Only the
    per-file hash for sim/quiescent-current/testbench/klt_run.py moved. Envelope
    content_hash and the T1 record are unchanged (item 9 stays met, 4/11).
2026-11-08 fix: wait for batch capacity in the load-transient klt wrapper
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2026-11-08 fix(signoff): re-pin characterization and re-attest item 9 after PR #564 evidence
    sim/CHARACTERIZATION.md moved (regenerated for the 1 uF load-transient
    records) and sim/load-transient/testbench/klt_run.py changed. Re-pinned the
    characterization envelope + manifest hash, re-attested item 9 (90/90 checks),
    and regenerated signoff/records/t1-tier-report.json. Verdict unchanged
    (T1 4/11); no spec threshold touched.
2026-11-11 feat(sim): enforce ngspice as a major-version floor, not an exact pin
    Replace the exact ngspice-46 identity comparison with a single
    NGSPICE_MIN_MAJOR floor compared as an integer; containment check is
    unchanged. Adds DR-0043 and reconciles environment-setup docs.
2026-11-12 fix(signoff): re-attest T1 item 10 instead of downgrading it
    Revert the README tier-prose edits and the stale_evidence record; re-attest
    item 10 against the current tree so it stays met (T1 4/11). The DR index
    regeneration is unchanged.
2026-11-13 refactor: share delta-CSV writer and spread() between the two compare_records
    The soft-start-loop-gain comparison script already imports loop-stability's
    `_num`, `delta`, `fmt`, `load` and the resurgence tolerance so the two
    experiments cannot disagree about what a delta means. Two pieces of that
    contract were still restated verbatim in both files: the delta-CSV writer
    (byte-identical in both) and the nested `spread()` statistics helper (same
    filtering, sort, median index, p99 index and "not comparable" suffix; only
    the worst-point label differed).
    Lift both to module level in `sim/loop-stability/testbench/compare_records.py`
    as `write_delta_csv(rows, out)` and `spread(rows, field, label, u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
2026-11-13 refactor: parse HOV lines with the shared strict parser, hoist the FB-node KCL
    `parse_hov_fields()` in the soft-start loop-gain driver was a third
    statement-for-statement copy of the strict `key=value` line parser that
    #203 / PR #206 consolidated into `harness.report.parse_row_fields()`. It
    predates that consolidation by three days and simply was not in its scope,
    so a future hardening of the shared parser would have silently skipped the
    hand-over deck's lines -- the exact drift the `ROW` wrapper's docstring
    says the shared parser exists to prevent.
    - `harness.report.parse_row_fields()` takes an optional `tag` naming the
    line kind in its three error messages. It defaults to `ROW`, so ever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
2026-11-13 fix: grade the current-limit bench against DR-0005's ratified window once
    sim/current-limit/testbench/summarize.py still windowed ilim_1764_ma at
    65-80 mA and printed the count as "corners outside the ratified 65-80 mA
    window", while klt_run.py's grade() applied DR-0005's ratified 62-95 mA /
    <= 346 mW bounds (README.md "Current limit" and "Thermal" rows, ratified
    2026-09-15). So run.sh's printed summary reported 36/63 corners outside
    "the ratified" window for a design that is 63/63 inside it, and klt_run.py's
    docstring claim to mirror summarize.py's bounds was false.
    Define the two ratified bounds once, in summarize.py (ILIM_WINDOW_MA,
    PSHORT_MAX_MW), and have klt_run.py's grade() and its d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
2026-11-13 docs: grade soft-start against DR-0024 as ratified, not proposed
    DR-0024 was ratified 2026-09-15 (spec/decision-records/README.md indexes it
    `ratified`; README.md's Startup row already carries 5 V/ms / 1.8 ms at
    C_eff = 1 uF). The soft-start generator and the experiment README still
    described that row as a pending proposal, so every new rollup printed a
    wrong provenance statement and the experiment's front page quoted the
    superseded DR-0006 row as "the ratified Startup row".
    summarize.py: the 12-line header block claiming DR-0024 is "proposed, not
    yet ratified" and that "the ratified README.md Startup row is still the
    <= 1 V/ms / 3 ms row" is replaced with the ratified framing plus a note
    t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
2026-11-13 signoff: re-attest T1 item 9 after the current-limit bench edits
    This PR edits sim/current-limit/testbench/klt_run.py and
    sim/current-limit/testbench/summarize.py, both inventoried members of the
    T1 item 9 attestation (signoff/inventory-item9.json). The envelope still
    pinned their pre-edit hashes, so a fresh `klt signoff --manifest` graded
    item 9 unmet/stale_evidence (t1_met_count 3 vs the committed 4) and
    `bash signoff/check.sh` failed on a stale verdict of record.
    Regenerated the envelope with the pinned release, per signoff/README.md
    -> "After any inventoried file changes" (same as c061206b / 1de94810):
    uvx --from klayout-tools==0.8.0 klt signoff --attest 9 \
    --inventory signoff/i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
2026-11-13 refactor(sim): one harness @TOKEN@ renderer and netlist preflight for eight drivers
    The "no template token left unsubstituted" guard existed in eight hand-written
    copies at three different strengths: `@([A-Z0-9_]+)@` in the four file-template
    renderers, `@[A-Z_]+@` in two `klt_run.py` drivers, `@[A-Z]+@` in the other
    two. The first underscore- or digit-bearing token added to either of the two
    narrowest decks would have reached ngspice as literal text -- a silent evidence
    defect, not a crash -- and the four `klt_run.py` copies were `assert`
    statements, which vanish under `python -O`.
    Add `sim/harness/deck.py` (50 lines of code):
    * `TOKEN_RE` / `render` / `render_file` / `require_substituted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
2026-11-14 ci: reject added records that still carry klt_record's "(to be written)"
    sim/harness/klt_record.py mints every record with a literal
    "(to be written)" under a `## Reading` heading for the minting agent to
    replace. Nothing checked that it did: PR #602 reached fully green CI
    (11 SUCCESS, 4 SKIPPED) with the placeholder still at line 88 of its
    added record. Records are append-only, so correcting one after merge
    costs an sim/append-only-allowlist.txt entry plus a decision record,
    versus a one-line fix before merge.
    Adds sim/check_record_reading.py, modelled on the sibling gate
    sim/check_record_host_paths.py: PR-scoped `git diff --diff-filter=AM`
    over the same PATHSPECS, a PLACEHOLDERS constant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
2026-11-14 fix(signoff): re-attest T1 item 10 after ci.yml change (during evaluation)
    The item 10 envelope pins .github/workflows/ci.yml's content hash; this PR
    edits ci.yml, so the committed envelope was stale, `klt signoff --manifest`
    re-graded item 10 as stale_evidence (met -> unmet, T1 4/11 -> 3/11), and
    signoff/check.sh failed the "T1 tier report" CI job.
    Regenerated with the klt release signoff/check.sh pins:
    uvx --from klayout-tools==0.8.0 klt signoff --attest 10 \
    --inventory signoff/inventory-item10.json \
    -o signoff/evidence/item10.generic.json
    10/10 checks pass; the inventory's own sha256 is unchanged, so the manifest
    pin needs no edit and signoff/records/t1-tier-report.json is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
2026-11-14 fix: stage models and split the loop-stability klt grid under the job ceiling
    `run_grid_klt` submitted each of its 72 (load, C_eff, ESR) requests as one
    63-unit job with no staging options, which broke a batch run two ways:
    * a job's pre-submit bound of `timeout_s * 63 + 120` is 17x the fleet's
    3600 s whole-job ceiling, and the fleet kills a job that reaches it and
    reports EVERY unit of it `batch_job_timeout` -- the finished ones included;
    * without `options.stage_model_inputs` the runner simulates whatever
    open_pdks revision its image carries (`c6d73a3`), not the `f6eeac7` that
    `sim/harness/pdk.py` pins, so a record minted from it cannot claim the pin.
    Staging turns out not to be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
2026-11-14 fix: stub klt_version in the wiring test and re-attest T1 item 9
    Two CI failures on the first push, both mine.
    `TestRunGridKltWiring` calls the real `run_grid_klt`, which ends by asking
    `klt_run.klt_version()` for the record's provenance -- and that shells out to
    `klt --version`. The test stubbed `run_configs` but not this, so it passed on a
    dispatch host (klt installed) and died with `FileNotFoundError: 'klt'` on the
    CI runner, where it is not. Stub it too, and say in the docstring that both
    stubs are what make the test the offline test it claims to be. Verified by
    re-running the suite with klt off PATH: 761 tests, OK (it was the stray
    subprocess that made this class take 0.9 s; it now tak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
